konamivrc6/Gewu/README.md

# 格物

> 在一块 8×8 点阵上，渲染几颗**有物理的像素**。

---

## 硬件

| 器件 | 作用 |
|---|---|
| 合宙 CORE-ESP32-C3 | 主控，跑物理引擎 |
| MAX7219 + 8×8 点阵 | 世界本身 |
| MPU6500 | 重力矢量来源 |
| 旋转编码器 EC11 | 连续量输入——重力系数、弹性、阻尼、时间步长 |
| 微动开关 ×2 | 离散量输入——重置、计时、冻结 |
| SN74HCT125 | 3.3V → 5V 电平转换，驱动 MAX7219 |
| 拨动开关 + 2pin 排针 | 5V 供电入口 |
| 电源小板（TP5400 + DW01A） | 18650 → 5V 升压与保护，与主板叠装 |

**`PCB/` 里的 EDA 工程仍标 MPU6050——那只是因为立创EDA 元件库里有这一颗，实际按 MPU6500 采购。**

**电源板上有三处飞线，打样后需手工补接。**

**完整接线见 [`硬件接线.md`](硬件接线.md)。** 该文档包含经官方资料核实的引脚分配、电平转换细节、去耦要求与上电检查步骤，动烙铁前请通读。

---

## 设计要点

**为什么需要 SN74HCT125**：MAX7219 在 5V 供电时输入高电平门限为 3.5V，而 ESP32-C3 输出仅 3.3V，处于「有时能用有时不能用」的危险区间。HCT 系列是 TTL 电平输入，2.0V 即判为高，3.3V 驱动有充足余量，输出 5V 摆幅正好匹配。它只能单向使用，因此**不能**用于传感器的 I2C 总线。

**为什么 X 放在 Y 引脚**：见接线文档「主控引脚分配」一节，其中 GPIO8 与 strapping 脚的取舍有专门说明。

---

## 软件栈

- 平台：Arduino（板型 `AirM2M CORE ESP32C3`）或 ESP-IDF
- 构建：`arduino-cli compile firmware/Hardware_Test`。板型、平台与库版本都钉在 `firmware/Hardware_Test/sketch.yaml` 里，缺什么会自动下载，换机器不必先配板管理器
- flash 模式：DIO（本板型固定，无需设置）
- 显示驱动：MAX7219 三线协议，3 个 GPIO
- 传感器：MPU6500 I2C，地址 `0x68`。九个标定常数（加速度计六个、陀螺三个）与「模组系 → 屏幕系」的轴映射都在固件里，来历见 [`标定.md`](标定.md)
- 物理引擎：自写，1-bit 离散世界，无需浮点库。内核定案为**格子锚定**（格号是状态不变量，不是事后修补），全程 Q16.16 定点。平面内重力、任意转轴的刚体转动（离心 / 科氏 / 欧拉，三轴全进模型）与板面静摩擦（法向压力 `N = sqrt(G² − g∥²)`）都已进来；平放转板时物块会聚到四角，转速低于 `sqrt(μ_p·N/r)` 时被静摩擦钉住不动，绕板面内的轴转时物块被推离该轴。设计推导与验证在 [`物块模式_物理设计.md`](物块模式_物理设计.md)，可运行的定点原型与评测套件在 `sim/particle/`。C++ 移植在 `firmware/common/PhysicsWorld.h`，正式固件 `firmware/Gewu/` 已接编码器增删粒子、MPU6500 实时重力与三轴角速度（200 Hz、±4 g）；角速度经标定与「模组系 → 屏幕系 → 引擎系」映射后每 5 ms 喂给内核，转板子时离心/科氏/欧拉三项都实时生效；`sim/particle/` 仍是逐位基准，三组场景的板上 trace 与 `sim/particle/port_trace.py` 逐行一致。固件现有水 / 红豆 / 钢珠三组材料预设：钢珠是同一内核上的低摩擦高恢复颗粒（μ_p = 0.003、μ = 0.15、e = 0.78、阻尼 0.9999），重力标度与红豆同为 0.0118——密度不进入自由落体，钢珠的「重」只能由低摩擦与高恢复表现。推导与台面实验见 `sim/steel/` 与设计文档 §4.5

---

## 待定

- [x] 物理模型的粒度——答案是两者之外的第三种：位置保持连续，但「占用」是状态的一部分而非事后检查。见 [`物块模式_物理设计.md`](物块模式_物理设计.md)
- [x] 各向异性扫描——镜像残差在 90 个角度上全部为零，见设计文档 §4.1
- [x] 转动的各向同性——`S/+ω` 与转置后的 `T(S)/−ω` 逐位相同，见 §4.2
- [x] 板面静摩擦——启滑阈值逐 LSB 扫过，与 `G·μ/√(1+μ²)` 差 0.7%~3.9%，见 §4.3
- [x] 陀螺实时转动——MPU6500 角速度每 5 ms 进内核，屏幕系 → 引擎系后驱动离心 / 科氏 / 欧拉；`w` 现场调转速增益，见 §4.4
- [x] 内聚力的拓扑加权（平直界面减弱、凸角保持）——8×8 上不成立：零重力液滴周长从 18 涨到 20、边界出现单格凸起，性能 +18%。`k` 不是曲率的好代理，均匀收缩才是液滴成形的机制。已回滚
- [ ] 滞后回线的实测
- [ ] 钢珠模式的块间摩擦与恢复系数上板实测——`u` 扫 0.10 / 0.15 / 0.20，`e` 扫 0.70~0.82；仿真只能验到速度余量与反弹衰减，堆角要在板上看。见设计文档 §4.5
- [ ] 编码器映射到哪个参数最直观
- [ ] 是否需要 WiFi 扩展（OTA 调参？多机同步？）
- [x] PCB 化——主板与电源板的原理图、PCB 均已完成，工程与 Gerber 见 `PCB/`

---

## 工具

`tools/` 下的脚本分两拨。

**工程包解析**——只依赖标准库，**都不传参数即可裸跑**——默认取 `PCB/` 下最新的 `.epro2`，免得工程一改名就集体失效。

| 脚本 | 作用 | 用法 |
|---|---|---|
| `bom.py` | 元器件清单：位号明细、按立创编号聚合的采购表、PCB 手焊清单 | `python tools/bom.py` |
| `netlist.py` | PCB 网表，按位号列出每个焊盘的网络，用来对照 `硬件接线.md` | `python tools/netlist.py` |
| `epro_dump.py` | 工程文件概览：元素类型计数与文档段划分 | `python tools/epro_dump.py` |

`bom.py` 另有两个开关：`--json` 出结构化数据，`-o 文件` 写进文件。**要重定向就用 `-o`**——PowerShell 的 `>` 默认产出 UTF-16，别的工具读不了。

手焊清单的「标签」不是位号，是 layout 阶段为了手焊方便在板面上改成的展示值（`100nF`、`4k7`、`HCT125`），脚本照读原值，并附上它对应的权威位号，方便回头查原理图。

**台面调试与标定**——要 `pyserial`，要板子插在串口上。不指定 `--port` 时按 VID/PID 自动找板上的 CH343（换机器 COM 号变了也不用改脚本）；认不出或有多个候选会列出清单，用 `--port COM7` 覆盖。四支都按 921600 打开。**默认不复位**——只有加 `--reset` 才拉 RTS 让板子重启，因为复位会冲掉亮度、显示模式、屏上已画的内容，而标定过程往往正需要保留这些。

| 脚本 | 作用 | 用法 |
|---|---|---|
| `serial_send.py` | 逐条发串口命令并回显，滤掉 IMU 数据行，`--reset` 会等开机横幅 | `python tools/serial_send.py '?' 'i 8'` |
| `serial_console.py` | 交互式串口控制台：常驻提示符，一行一条命令；本地命令 `:help` / `:reset` / `:port`（别名 `:com`）/ `:filter` / `:log` / `:quit` | `python tools/serial_console.py` |
| `imu_stat.py` | 抓一段 IMU 数据行做静止统计：均值、原始计数、标准差、模长、重力方向 | `python tools/imu_stat.py --sec 12 --label '点阵面朝上'` |
| `accel_calib.py` | 加速度计六面标定：`record` 采一个姿态、`status` 看还缺哪个、`solve` 解常数并自检 | `python tools/accel_calib.py record --pose flat_up` |

原始数据写到 `%TEMP%`，不进仓库。判据、摆法与固件那一路串口命令的清单都在 [`标定.md`](标定.md)。

---

## 文件

| 文件 | 内容 |
|---|---|
| `README.md` | 本文档 |
| `硬件接线.md` | 接线、引脚分配、上电检查 |
| `电源设计.md` | 电源小板的设计规格与选型记录 |
| `标定.md` | 传感器与点阵屏的标定：判据、方法与进度 |
| `物块模式_物理设计.md` | 物理内核的前提、推导、方案评估与验证记录；附录里有被否掉的思路和判别实验设计 |
| `sim/` | 三套原型共用的公共层（只用标准库）：`fixed.py` Q16.16 定点原语（C++ 侧逐条对应）、`spawn.py` 统一摆位、`world2.py` 格子锚定内核（内聚 / 浸润项默认关闭）、`checker.py` 独立不变量检查 |
| `sim/particle/` | 粒子内核原型与评测：`world.py` 基线、`run.py` 终端演示（`--engine v1\|v2`）、`eval.py` 不变量、动能、运算数与板面摩擦阈值评测、`aniso.py` 各向异性扫描、`rot.py` 转动与镜像检验、`port_trace.py` 生成与固件 `v` 命令同格式的逐位对照 trace |
| `sim/water/` | 水模式原型：`water.py` 参数预设、场景、度量与实验（`drop` / `wet` / `tilt` / `sweep` / `jam` / `column` / `show`）；`port_trace.py` 生成与固件 `v water` 同格式的逐位对照 trace，`port_trace_hydro.py` 生成 `v hydro` / `v hydrod` / `v grain` / `v graind` 的压强路径与屈服门逐位对照（竖直与斜向重力各一组，后者开屈服 μ = 0.45；零摩擦零内聚，只留静水压强）。零摩擦、零恢复系数，八邻域内聚 + 键轴阻尼 + 静水压强（重力反方向的水头差变成横向推力，竖柱会塌、液面会平），壁面虚拟格与接触线力（默认关闭） |
| `sim/steel/` | 钢珠模式原型：`steel.py` 参数预设与实验（`drop` / `pile` / `plate` / `bounce` / `tilt` / `show`），同时带一份红豆预设做对照。只改摩擦、恢复、阻尼，不引入球体或多格刚体；`plate` 扫出启滑阈值（钢珠 3 LSB = 0.222°，红豆 40 LSB = 2.965°），`bounce` 扫恢复系数（e = 0.78 首跳回弹 4 格，与 e² × 7 = 4.26 对得上），`tilt` 在 2° 板面上直接看出钢珠流、红豆不动 |
| `PCB/` | 立创EDA 专业版工程（`.epro2`，主板与电源板同在一个工程里）与导出的 Gerber 包 |
| `面板Logo/` | 前面板铭牌 Logo 的源图与导出件，含总览 SVG、铜箔层与丝印层的分层文件 |
| `firmware/` | 板级上电自检草图（Arduino），一次验点阵、I2C 总线、串口与五路输入；另带一路串口命令，可点名点灯、全亮查死点、逐行逐列扫、运行时调亮度。逻辑坐标用数学系 `(x, y)`，原点左下。IMU 读数已按标定修正，`g` 命令进重力模式，把屏幕系的重力方向画成一颗灯 |
| `firmware/Gewu/` | 正式固件：移植后的格子锚定物理内核 + 编码器增删 + MPU6500 实时重力与三轴角速度（200 Hz 采样、±4 g、218 Hz 加速度计 DLPF）。三组材料预设共用同一内核与同一套时间尺度（重力标度 0.0118~0.0120），切换保留现有粒子、只恢复该模式的默认参数，上电不预置任何粒子。默认**水模式**：零摩擦、零恢复、静水压强，外加很小的内聚力和键轴黏性（`a` 4 / `j` 4），重力标度 0.0120、转速增益 200%；`m particles` 切**红豆模式**（μ_p = 0.05、μ = 0.45、恢复 0.50、阻尼 0.9998、重力 0.0118、转速 100%）；`m steel` 切**钢珠模式**（μ_p = 0.003、μ = 0.15、恢复 0.78、阻尼 0.9999、重力 0.0118、转速 100%）。顺时针一格随机添加，逆时针一格删除最新，编码器按下后松开清空全部，容量 64。SW2 短按松开时在 水 ↔ 钢珠 之间循环（红豆预设不给按键入口，只能 `m particles` 进入）；按住满 2 秒时最外圈 28 颗先闪约 120 ms，随后进入计时模式：清空后立刻补一格、之后每 60 秒加一格，长按后的松开不再切换模式；计时模式被编码器转动或编码器按键松开打断，SW2 短按不打断（周期可用 `t` 临时改）。SW3 改为按住冻结：消抖确认的按下沿暂停全部物理推进，松开恢复；冻结期间编码器增删照常、新粒子停在原地，计时任务照常计时。按键动作不再统一在松开沿：SW3 在两个沿动作，SW2 短按在松开沿、长按在按住中触发。串口命令 `n / d / p x y / c / i / f / q / u / e / g / w / t / m / a / j / h / s / k / v`：`a` 调内聚，`j` 调黏性，`h` 调静水压强增益（百分数），`m` 切模式，`f`（百分数）与 `q`（千分之一，钢珠的 0.003 用 `q 3`）调板面摩擦，`u` 调块间摩擦，`e` 调恢复系数（百分数），`g [1-999]` 调重力标度（`m` 切换恢复各模式默认），`w` 调转速增益，`t` 调计时模式周期，`v plain\|friction\|spin\|water\|hydro\|hydrod\|grain\|graind` 生成确定性 trace（前三种对照 `sim/particle/port_trace.py`，`water` 对照 `sim/water/port_trace.py`，其余四种对照 `sim/water/port_trace_hydro.py`，其中 `grain` / `graind` 是带屈服门的颗粒路径）。构建上传：先用 `arduino-cli board list` 确认端口（本板是板载 CH343，换机器 COM 号会变），再 `arduino-cli compile -u -p <端口> -m gewu-firmware firmware/Gewu` |
| `firmware/common/` | `BoardProfile.h`：这台板子**实测出来**的档案——点阵模块型号、编码器每格跳变数、IMU 量程与九个标定常数。与「可调参数」刻意分成两处，见文件开头的分组规则。`fixed_q16.h`：Q16.16 定点原语，逐条对应 `sim/fixed.py`。`PhysicsWorld.h`：格子锚定物理内核的 C++ 逐位移植，header-only，不依赖 Arduino |
| `tools/` | 两组脚本：工程包解析（`bom` / `netlist` / `epro_dump`，只用标准库），台面调试与标定（`serial_send` / `serial_console` / `imu_stat` / `accel_calib`，要 `pyserial`） |
