konamivrc6/Gewu/电源设计.md

# Gewu 电源设计

本文档定义格物的**独立电源小板**：单节 18650 供电、升压至 5V、支持边充边用。

与 `硬件接线.md` 的分工：**格物主板一侧的接线以 `硬件接线.md` 为准，本文档只管电源小板**。两块板之间只有一个 2 针接口 `CN1`。

**本文档的位号与定稿的原理图逐一对齐**，可以直接对着 BOM 和 PCB 找件。两条容易混的地方：电源板的 `H1` 是跳线，格物主板的 `H1` 是输出排针，两块板各自独立编号；网络名本文档仍用概念名（`VBOOST`、`V5V`、`VBAT`、`B−`、`P−`），与 EDA 网名的对应见 §2 的节点表。

**当前版本基于 `TP5400` 单芯片方案**（此前一版是 TP4056 + FP6291 + TLV3011 的离散方案，已被本文档取代）。改版理由见 5.3，被淘汰的候选见 4.7。

---

## 一、目标与约束

| 项 | 内容 |
|---|---|
| 电池 | **1S1P**，单节 18650，容量按 3000mAh 校核（4.2V 放到 3.0V 可用约 2700mAh） |
| 电池保护 | **裸电芯，不自带保护板**，保护电路做在本板上（见 4.3） |
| 输出 | **5V 轨**，供给格物主板的 `H1` 排针。3.3V 由格物板载 LDO 产生，本板不管 |
| 充电 | USB-C 输入 |
| **充电时的负载策略** | **由跳线 `H1` 选择**：断开 = 充电时切断主板供电；闭合 = 边充边用。见 5.8 |
| 切换 | USB 插拔时**允许格物复位或冷启动**，不要求无扰切换（见 5.5） |
| 形态 | 独立小板，**与格物主板叠装**，板载 18650 电池座（`BT1`，占位约 77 × 21 mm），与格物用 **JST XH2.54** 连接 |
| 主要场景 | 手持游玩。**不作为长期插电的桌面设备** |

最后一条是刻意的取舍，它降低了"电池长期停在满充"这一类风险，后文多处结论依赖它。

---

## 二、系统架构

**五条链路，两个汇合点。**

| 链路 | 路径 |
|---|---|
| **输入** | `USB1` 的 VBUS → `F1`/`F2`（PTC）→ `VBUS_CHG` |
| **充电** | `VBUS_CHG` → `U1` 的 `VCC` → `U1` 的 `BAT` → 电芯正极 |
| **放电** | 电芯正极 → `L1` → `U1` 的 `LX` → 整流 → `VBOOST` |
| **整流** | `U1` 的 `LX` → `D2` → `VBOOST`（`VBOOST` 就是 `U1` 的 `VOUT` 脚） |
| **直供** | `VBUS_CHG` → `H1` → `D3` → `V5V`（**`H1` 断开即切断**） |
| **汇合** | `VBOOST` → `Q1`（P-MOS 开关）→ `V5V`；`V5V` → `CN1` |

节点命名：

| 网络名 | EDA 网名 | 含义 |
|---|---|---|
| `VBUS_CHG` | `VBUS_CHG` | PTC 之后的 USB 5V，`D3` 的阳极侧、`U1` 的 `VCC`、`Q1` 的栅极 |
| `VBAT` | `VBAT+` | 电芯正极（保护 IC 之外的 B+），同时是 `U1` 的 `BAT` 脚 |
| `B−` | `VBAT−` | 电芯负极。只连 `BT1`、`U2` 的 `VSS`、`Q2` 的 `S1`、`C10` 的下端 |
| `P−` | `GND` | 板地。`Q2` 的 `S2` 接在这里，**与 `B−` 不是同一个网络** |
| `LX` | `LX` | `U1` 的开关节点，电感与续流二极管之间 |
| **`VBOOST`** | **`BAT5V`** | **升压输出，就是 `U1` 的 `VOUT` 脚**。`D2` 的阴极、`Q1` 的源极、47µF 电解 `C3`、TVS `D1` 都挂在这里 |
| `V5V` | `5VOUT` | 输出轨。`Q1` 的漏极与 `D3` 的阴极在此汇合，47µF 储能 `C9` 也挂在这里，直接送 `CN1` |

**`VBOOST` 和 `V5V` 是两个节点，中间是 `Q1`。** 这个拆分是本文档最新一版的核心改动，理由见 5.6。

`V5V` 由谁供：

| 状态 | `H1` | `V5V` 由谁供 | 电池 | 格物 |
|---|---|---|---|---|
| USB 不在位 | 任意 | `Q1` 导通，5.0V | 放电 | 运行 |
| USB 在位 | **闭合** | `D3`，约 4.65V（`Q1` 关断） | 充电，判停干净 | **继续运行**（边充边用） |
| USB 在位 | **断开** | **无人供电 → `V5V` ≈ 0** | 充电，判停干净 | **断电** |

**四个关键拓扑性质**：

1. **负载与充电器不在同一个节点上。** `U1` 的 `BAT` 脚上只有电池和保护，格物的负载挂在 `V5V`。所以充电器的判停测量天然干净，不需要任何电源多路复用器。
2. **`Q1` 保证"USB 在位时电池不出力"是无条件的。** 不依赖任何电压余量，见 5.6。
3. **`H1` 决定"USB 在位时主板吃不吃电"。** 这是使用者的配置选择，见 5.8。
4. **`D3` 保证"电池供电时升压不会被自己的输出电压顶住"**（否则形成自锁死循环），见 5.6。**注意 `D3` 无论 `H1` 怎么设都不能删。**

---

## 三、负载预算

**两种账，不能混用。**

### 3.1 电流账（选器件用）

| 项 | 平均 | 峰值 |
|---|---|---|
| MAX7219 显示 | 15～75mA | 320mA |
| 3.3V 轨（经格物板载 LDO） | 30mA | ~45mA |
| **5V 轨合计** | **45～105mA** | **0.36A**（本项目无 WiFi） |

含 WiFi 的峰值是 0.7A，格物用不到，只作参考。

**MAX7219 平均电流的来历**：8 位扫描复用，任一时刻只有一行导通。设单段电流 `I_seg`（`R_SET` = 10kΩ、5V 时约 40mA），则平均电流 = `N_lit` × `I_seg` / 8，其中 `N_lit` 是当前点亮的总像素数。64 颗全亮才等于 8 × `I_seg` = 320mA。

**这一栏是估算，不是实测。** 实际值取决于固件每帧画了多少像素。**下一步应该串一颗电流表跑真实固件量一次。**

### 3.2 能量账（算续航用）

升压是功率守恒 + 效率惩罚，输入电流由电压比放大：

```
I_in = (V_out × I_out) / (V_in × η)
```

`TP5400` 手册给的效率是 **90% @ 500mA 输出、88% @ 1000mA**（`VBAT` = 3.8V）。本项目工作点只有 45～105mA，离手册测点较远，**取 η = 0.85 作为偏保守的估计**（这是估算不是手册值）：

| 5V 轨电流 | 输入电流 @3.7V | 输入电流 @3.0V |
|---|---|---|
| 45mA | 72mA | 88mA |
| **75mA（典型）** | **119mA** | **147mA** |
| 105mA | 167mA | 206mA |
| 365mA（峰值） | 580mA | **716mA** |

电感纹波（`L1` = 10µH、f = 400kHz、Vin = 3.0V、D = 0.43）：

```
ΔI_L = (V_in × D) / (L × f) ≈ 0.32A
峰值电感电流 ≈ 0.716 + 0.16 ≈ 0.88A
```

**设计输入峰值取 0.9A。**

续航按 147mA 估，2700mAh 可用容量对应**约 18 小时**。

**顺带两条设计上限**：

- `TP5400` 的最大占空比是 75%，本项目 3.0V 输入时只需约 43%，余量充足
- 它的升压**绝对最大输出是 1.8A/5V**，本项目用不到，也不要按这个数去设计散热

---

## 四、器件选型

**选型顺序：封装是第一道筛子，功能是第二道。**

手工焊接的可用封装白名单：**SOT-23 / SOT-23-3 / SOT-23-6 / SC70 / SOP-8 / ESOP-8 / TSSOP-8 / MSOP-8 / SMA / SMB / 1206 / 1812 / 0805 / 0603 / 2.54mm 排针，以及所有直插**。

不可用：**QFN、DFN、VQFN-HR、WLCSP、BGA**——凡是无可见引脚、靠底部焊盘散热的一律排除。

**`ESOP-8` 是允许的**：本体 4.9 × 3.9 mm、引脚间距 1.27 mm 的鸥翼脚，拖焊轻松；底部散热焊盘虽然不可见，但尺寸大（3.1 × 2.21 mm），可以用过孔从背面灌锡解决，见 7.18。

**无源元件统一用 0805，不用 0603。** 两者都在白名单里，但 0805 比 0603 大一档，镊子夹持和拖焊都明显更好操作，而本板虽然**与格物主板叠装**，叠装高度却是由 `BT1` 里的 18650 决定的——电芯本体直径 18.4 mm，连座子约 21 mm，**凡是低于电芯的元件都不受约束**。这是**反向的木桶效应**：桶高不由最短的那块板定，由最长的那块（电芯）定。所以 0805 多占的那点尺寸换不到任何代价，§7.20 那条"热回路周长压到 15mm 以内"在 0805 下依然轻松满足。

**TVS（`D1`）不受 0805 规则约束。** TVS 的封装体系是 SOD-123 / SOD-323 / SMA / SMB，EIA 阻容尺寸的 TVS 本来就少，**双向型更难找**。本设计实际用的是 **SMB 封装的 `SMBJ6.8CA`**——比 0603 大得多，但它挂在 `VBOOST` 而不是 `LX` 上，封装引线的寄生参数影响很小，手工焊反而更容易。如果将来要缩小，正确的方向是 **SOD-323 或 SOT-23 的双向 TVS**，不是 0805。

### 4.1 选型表

| 位号 | 功能 | 型号 | 封装 | 关键参数 |
|---|---|---|---|---|
| `U1` | **充电 + 升压二合一** | **TP5400**（南京拓微） | **ESOP-8 带散热焊盘** | 线性充电 1000mA 可编程、4.2V ±1%、C/5 判停、2.9V 涓流；升压 5V ±2.5%、VFM、400kHz、Dmax 75%；**内置欠压关断 3.0V 关断 / 3.3V 解锁**；空载 <10µA；**无需按键自动启动** |
| `U2` | 电池保护 | **DW01A**（永裕泰 C2927799） | **SOT-23-6** | 过充 **4.30V / 解除 4.10V**，过放 **2.40V / 解除 3.00V**，放电过流 **0.16V**，短路 **1.3V**。引脚 1 OD / 2 CSI / 3 OC / 4 NC / 5 VDD / 6 VSS |
| `Q2` | 保护 MOS | **8205A**（杰盛微 C2762931） | **SOT-23-6** | 20V / 6A，Rds(on) **22/28mΩ @4.5V、30/38mΩ @2.5V**（典型/最大）。引脚 1 S1 / 2 D（共漏）/ 3 S2 / 4 G2 / 5 NC / 6 G1。**引脚 2 的焊盘铺铜但不接网络**，见 7.25 |
| **`Q1`** | **输出隔离开关** | **CJ3401**（长晶，P-MOS） | **SOT-23-3** | 1=G、2=S、3=D。**源极接 `VBOOST`，漏极接 `V5V`，栅极接 `VBUS_CHG`**，见 5.6 |
| `D3` | USB 直供通路 | **SS34** | SMA | 3A / 40V。阳极接 `H1`，**阴极接 `V5V`** |
| `D2` | 升压整流 | **SS34**（**与 `D3` 同料**） | SMA | 同上。手册推荐 SS32（3A/20V），本项目统一用 SS34 换 40V 耐压余量。阳极接 `LX`，阴极接 `VBOOST` |
| `D1` | `VBOOST` 端 TVS | **`SMBJ6.8CA`**（R+O C19077562），双向 | SMB | VRWM 5.8V，击穿 6.46～7.14V，钳位 10.5V @ 57.1A。手册推荐 5.5～6.8V 的 TVS，本料**两端都满足**：`VRWM` 5.8V 保证 5.0V 稳态不导通，击穿 + `D2` 的 Vf ≈ 7.0～7.7V 保证钳位赶在 `LX` 的 10V 绝限之前。击穿上限比手册典型值高 0.34V，不影响功能，见 5.7。接在 `VBOOST` 与 GND 之间 |
| `L1` | 升压电感 | **`SLS6D38S100MTT`**（顺络 6D38，10µH ±20%） | 7×7mm（本体 6.0×6.0×3.8） | 额定电流 **2A**，DCR **38mΩ max**。手册推荐 3.3～22µH，典型 10µH。−20% 容差对应 8µH，峰值电流约 0.92A，仍远低于额定 |
| `F1`/`F2` | 输入自恢复保险丝 | **1.5A 保持 PTC ×2 并联**（R+O `SMD1206-150-8`） | **1206 ×2** | **Vmax 8V**、Imax 40A、Itrip 3A。**按库存条件定的方案**：库存现成的是 1.5A/1206，单颗扛不住 1A 的工作点，而 1206 的 PTC 上限就在 1.5A 附近，买 2A 要换成 1812 并重新开一次采购。并联后保持电流约 **2.4～2.7A**（不是 3A），热余量比单颗 2A 还宽。**两颗必须同型号、并排、且一起远离 `U1`**，见 4.5 后果一、7.23、7.24 |
| **`H1`** | **充电时负载策略选择** | **2.54mm 2 针排针 + 短路帽** | — | **闭合** = 边充边用；**断开或不装** = 充电时切断主板。见 5.8。可用 2 焊盘焊接跳线或 0805 零欧电阻代替，但改起来要动烙铁 |
| `R4`/`R6` | 充电电流设定 | **2.2kΩ ×2 并联 = 1.1kΩ** | **0805 ×2** | `I_BAT` = 1100 / `R_PROG`(kΩ)，其中 `R_PROG` = `R4`∥`R6` → **1000mA**（手册上限）。**按库存条件定的方案**：库存没有 1.1kΩ，但有 2.2kΩ 一百颗，两颗并联正好是 1.1kΩ（并联比单颗还准）。**两颗都必须是 1%**，见 4.5、7.17。另一笔代价是电池低于约 3.3V 时芯片会热调节降流 |
| `R3` | LED 限流（两颗共用） | 1kΩ | 0805 | 手册典型应用。`LED2`（红，充电中）与 `LED1`（绿，充满）**共用这一颗**——两个开漏非此即彼，约 3mA |
| **`R5`** | **`Q1` 栅极下拉 + `VBUS_CHG` 泄放** | **10kΩ** | 0805 | **一颗电阻干三件事**，见 4.4。开源参考设计用的是 100kΩ，会带来约 0.7 秒的切换空窗，本文档改小 |
| `R8` | DW01A `VDD` 串阻（引脚 5） | 470Ω | 0805 | DW01A 手册强制，**必须 ≥470Ω** |
| `R7` | DW01A `CSI` 串阻（引脚 2，旧称 `VM`） | 2kΩ | 0805 | DW01A 手册要求 1～3kΩ |
| **`R1` / `R2`** | **USB-C CC 下拉** | **5.1kΩ** | 0805 | 分别接 `USB1` 的 `CC1` / `CC2` 到 GND。**漏了就取不到电**，见 6 与 7.12 |
| `C2` | `VCC` 储能与去耦 | 10µF | 0805 | 紧靠 `U1` 的 `VCC` 脚，管充电稳定与输入纹波（**不在开关热回路上**，见 7.20）。**不要再加大**——它同时决定拔线后升压启动的延时，见 4.4 与 5.5 |
| `C1`/`C8` | `VCC` 高频去耦 | 0.1µF | 0805 | 与 `C2` 并联 |
| `C6` / `C7` | `BAT` 去耦 | **22µF ×2，铝电解**（`KM1E220M0407`） | **直插**（φ4×7mm） | 手册要求 `BAT` 端并联两颗 22µF，**不限类型**。实际用 25V 规格，建议 105°C。为什么用铝电解和直插，见 5.7 |
| `C3` | `VBOOST` 主电容 | **47µF / 25V 直插铝电解**（`KS476M025D07`） | 直插（φ5×7mm） | **手册强制要求钽或电解，不能用 MLCC**，见 5.7。最终选了铝电解而不是钽，理由见 5.7 |
| `C4` | `VBOOST` 高频去耦 | 0.1µF | 0805 | 与 `C3` 并联 |
| `C9` | `V5V` 储能 | **47µF / 25V 直插铝电解**（与 `C3` 同料） | 直插（φ5×7mm） | 撑住 `Q1` 关断那一刻的负载电流，见 5.5。**有极性** |
| `C5` | `BAT` 高频去耦 | 0.1µF | 0805 | 与 `C6`/`C7` 并联 |
| `C10` | DW01A 去耦 | 0.1µF | 0805 | ≥0.1µF |
| `LED2` | 充电中指示 | 红色 LED（`GL0805UR01`） | 0805 | 接 `U1` 的 `CHRG`（开漏），经 `R3` 限流 |
| `LED1` | 充满指示 | 绿色 LED（`GL0805UG01`） | 0805 | 接 `U1` 的 `STDBY`（开漏），经 `R3` 限流 |
| `BT1` | 电池座 | **18650 贴片电池座**（MYOUNG `BH-18650-B1BA002`） | SMD | 焊在板上，占位约 77 × 21 mm。**取出电芯即物理断电**，见 4.4。⚠️ 贴片座要承受每次换电芯的插拔力，见 7.21 |
| `CN1` | 输出连接器 | **JST XH2.54** 2P | — | 每触点 3A |
| `USB1` | 充电输入 | **USB-C 16P 母座**（首韩 `TYPE-C 16PIN 2MD(073)`） | SMD 卧贴 | 只用 VBUS/GND/CC1/CC2，**D+/D−/SBU 全部悬空**；**CC1 / CC2 各经 `R1` / `R2` 配 5.1kΩ 下拉** |

### 4.2 元件数统计

| 方案 | IC | 分立半导体与 LED | 无源 | 连接器与开关 | 合计 |
|---|---|---|---|---|---|
| 全集成（不可焊，作废） | 3 | 0 | 12 | 4 | 19 |
| 离散方案（TP4056 + FP6291 + TLV3011） | 5 | 7 | 约 21 | 4 | **约 37** |
| **本方案（TP5400 + `Q1` + `H1`）** | **2** | **7** | **19** | **4** | **32** |

省下的 8 个主要来自 `U1` 内部替掉了 FP6291 升压 IC、TLV3011 迟滞比较器、VBUS 检测管以及 `EN_BOOST` 上拉网络和整个迟滞分压网络共 5 个无源。

**新增的是 4 个，分两类：**

- **功能性的两颗**：`Q1` 把"USB 在位时电池不出力"从"依赖电压余量"变成"无条件成立"（见 5.6）；`H1` 把"充电时主板要不要断电"变成使用者的选择（见 5.8）。这两颗都不可省
- **重复的两颗**：`F1`+`F2` 与 `R4`+`R6` 各由一颗变两颗，是**对着库存定的并联方案**（1.5A/1206 的 PTC 两颗并联当输入保险丝、2.2kΩ 两颗并联当 1.1kΩ 的 `R_PROG`），见 4.5。省掉的是采购，不是元件

所以相对离散方案**净省 5 个**（8 减 4，再加上删掉的电源开关 `SW1`——那一颗两边本来都有，现在本方案没有）。

> **口径说明**：上表的"离散方案 约 37"是按单颗 `R_PROG`、单颗 `F1`、含一颗电源开关计的。本节那两处并联是为了省采购才加的重复件，**纯比架构的话本方案是 30 个**（省下的 8 个全额兑现，再减掉删掉的开关），32 是含库存方案的实际装配数。加 `C9`、`C5`、`C8` 三颗文档早期版本没有的电容后，板上实际装配 **34 颗**。

**代价是失去了可调的欠压门限**（见 5.3）和**电池温度检测**（见 4.6），换来的是整块板不再有任何需要上台调参的模拟模块。

### 4.3 电池保护电路——不可省

裸电芯没有保护板，而 **`TP5400` 的充电管理不包含放电保护**。它只有：

- 充电侧的浮充限压（4.2V ±1%）和热调节（`Tj` 120°C）
- 升压侧自己的欠压关断（3.0V）——但这只管升压，**不管电芯本身**

它**不管放电过流、不管短路**。而且 3.0V 的升压关断点对 18650 来说偏深——18650 放到 3.0V 已经接近深度放电区。没有 `U2` + `Q2`，一次输出端短路就没有任何东西拦得住。

> 顺带一条佐证：英集芯在 `IP5306` 手册里专门列了「Battery protection recommends: **IP3005A**，ESOP8，过充检测 4.28V，过放检测 2.5V，过流检测 7A」。**厂商自己都建议给集成方案外加保护 IC。**

`U2` + `Q2` 的过流门限：

```
Rds(on) 两颗串联 ≈ 22 × 2 = 44mΩ（典型，Vgs = 4.5V）
I_OCP = 0.16V / 0.044Ω ≈ 3.6A
```

**按最坏情况再算一遍**：`Rds(on)` 取手册最大值 28mΩ；电池接近 3.0V 时栅压只有 2.5V 上下，此时取 38mΩ。串联 76mΩ，`I_OCP ≈ 2.1A`。

**2.1～3.6A，都远高于本项目 0.9A 的输入峰值**，不会误触发；又能真正拦住短路。这是一个合适的窗口——下限比文档早期按 FS8205A 的 21.6mΩ 算出的 3.5A 低，但仍然有 **2.3 倍**余量。

DW01A 的外围（手册强制要求，不可省）：

| 位号 | 值 | 作用 | 约束 |
|---|---|---|---|
| `R8` | 470Ω | `VDD` 串阻 | **必须 ≥470Ω** |
| `R7` | 2kΩ | `CSI` 串阻 | 1～3kΩ |
| `C10` | 0.1µF | `VCC` 去耦 | ≥0.1µF；**下端接 `U2` 的 `VSS` 脚（引脚 6），也就是 `B−`，不是板地 `P−`** |

**一个可选的替代**：把 `U2` + `Q2` 换成单颗 **`IP3005A`**（**ESOP-8**，同样手工可焊，MOS 内置）。立创开源工程 `rushairer/tp5400-18650` 用的就是它，BOM 少一行。选哪个主要看手头库存与采购难度，**电气上是同一个东西**——过放点从 DW01A 的 2.4V 变成 `IP3005A` 的 2.5V，差异可以忽略。

> ⚠️ 顺带记一条教训：那个工程的作者在描述里写「`IP3005A` 低于 3V 关断」，被评论区指出**手册实际是 2.5V**。**以手册为准，不要以作者的描述为准。**

### 4.4 两个"位置型"决策

这两条都不是选器件，是选位置，改一下布线就能同时满足多个约束。

> **电源开关 `SW1` 已删除。** 上一版在电感支路里串过一颗 ≥1A 的拨动开关（`VBAT → SW1 → L1 → LX`），那是它唯一合法的位置——`TP5400` 把充电输出和升压输入做在同一个 `BAT` 脚上，开关放在电芯与 `BAT` 之间会连充电一起断掉。现在整颗删掉，支路直连。
>
> - **理由**：`BT1` 是焊在板上的电池座，**把电芯取出来就是物理断电**；日常开关机落在**主板那颗 `SW1`**（`SS-12D10L5`，串在格物 5V 轨上）。电源板上再放一颗，等于把一个动作拆到两个地方。
> - **代价**：电源板不再有低功耗关机态。只要电芯放在 `BT1` 里，升压就一直在跑、`V5V` 恒为 5.0V；主板开关断开只是摘掉负载，静态电流从原来约 40µA 变成**升压空载电流**。这个数手册没给、也没实测，是删掉这颗开关唯一没有兜底的代价，见 9.2。
> - **成本下降**：`SW1` 原本串在 7.20 的热回路里，删掉之后那条回路少一个远程元件，15mm 的约束更容易满足。
> - **一条不成立的担心**：非同步升压有一条「电芯 → `L1` → `LX` → `D2` → `VBOOST`」的无源直通路径，但它只在**升压停着**的时候才有意义。删掉开关后只要有电池升压就启动，`VBOOST` 被芯片稳压在 5.0V，直通路径被盖过去。
> - **装配顺序**：电芯落进 `BT1` 的瞬间升压就启动，`V5V` 立刻带电。先接好 `CN1` 再放电池，见 7.15。
>
> 参考设计 `rushairer/tp5400-18650` 本来就没有电源开关，这是回到它的做法。

#### ① `R5` 的位置：一颗电阻干三件事

`R5`（10kΩ）接在 `VBUS_CHG` 与 GND 之间，同时服务三个目标：

| 作用 | 说明 |
|---|---|
| **`Q1` 栅极下拉** | USB 拔掉后把栅极拉到 0V，`Q1` 才导得通。**没有它栅极会浮空，输出永远起不来** |
| **`VBUS_CHG` 泄放** | 让 `U1` 的 `VCC` 跌破 3.8V，升压才会重启。没有它 `VCC` 只能靠芯片 µA 级漏电放电，要十几秒 |
| 顺带放掉 `C2` | 同上 |

**取值是 5.5 与 5.8 两节联立的解。**

#### ② `D3`、`D2`、`D1` 三颗二极管各有各的方向

名字相近，接错方向都会造成难查的故障：

| 器件 | 阳极接 | 阴极接 | 接反的后果 |
|---|---|---|---|
| `D3` | `H1` | `V5V` | 完全不充电，见 7.6 |
| `D2` | `LX` | `VBOOST` | 升压建立不起来，见 7.7 |
| `D1` | — | — | 双向 TVS 无方向，但**不能用成单向型**，见 7.8 |

### 4.5 充电电流设定（`R4`/`R6`）——**与 `H1` 联动**

`TP5400` 的充电电流公式：

```
I_BAT = 1100 / R_PROG(kΩ)    （mA）        R_PROG = R4 ∥ R6
```

手册给的表：

| `R_PROG` | 10k | 5k | 2k | 2.2k | 1.5k | **1.1k** |
|---|---|---|---|---|---|---|
| `I_BAT` | 130mA | 245mA | 560mA | 500mA | 740mA | **1000mA** |

**本设计取 1.1kΩ，也就是手册的上限 1000mA。** 理由是 500mA 对 3000mAh 电芯只有 0.17C，充满要 6.5～7.5 小时；1A 是 0.33C（仍是 18650 的标准 0.5C 以内），充满缩到 **3.5～4 小时**，近乎翻倍。**这个改动带来两个必须一起认账的后果，见本节末尾。**

#### `R4`/`R6` 怎么取值：两颗 2.2kΩ 并联（按库存定）

**本设计不买 1.1kΩ，而是用两颗库存的 2.2kΩ 0805 并联得到。** 库存里没有 1.1kΩ 这个阻值，但有 2.2kΩ 一百颗。

```
R = (2.2k × 2.2k) / (2.2k + 2.2k) = 4.84k / 4.4k = 1.1kΩ
```

**这是精确值，不是近似**——两条同阻值支路并联就是一半。三条判据都对得上：

| 担心 | 实际情况 |
|---|---|
| **精度会变差？** | 不会。**同阻值电阻并联，相对误差不放大。** 最坏情况是两颗偏到同一极端（都 +1%），并联后仍是 +1%；实际上一颗偏正、一颗偏负时误差还会互相抵消一部分。**并联出来只会比单颗更准，不会更差** |
| **功率够不够？** | 远远够。`PROG` 脚电压只有 1V 上下，流过 `R4`/`R6` 的电流约 0.9mA，整组才耗 **0.9mW**，对半分到每颗 **0.45mW**——0805 额定 125mW，用了不到 0.4% |
| **代价是什么？** | 多占一个 0805 焊盘。板子还没画，零成本 |

**但有一条不能打折：两颗都必须是 1%。** 并联合格的前提是它们各自合格——**两颗 5% 并联出来还是 5%**，充电电流会在 950～1050mA 之间飘（见 7.17）。丝印上 `2201` 是 1%、`222` 是 5%；有些 0805 批次根本不印字，那就只能看采购时的包装标签。

**充电时 USB 端口要供多少电流，取决于 `H1`：**

| `H1` | 充电时负载电流 | USB 总电流 @`R4`/`R6`=1.1k | 说明 |
|---|---|---|---|
| 断开（充电时切断主板） | **0** | **1000mA** | **必须配真正的 USB 充电头** |
| 闭合（边充边用） | 约 150mA | **1150mA** | 同上，且余量更紧 |

> ⚠️ **500mA 时代那条"任何 USB 口都扛得住"的结论，随 `R4`/`R6` 改成 1.1k 一起作废了。** 见 5.8 那张表的同类修正。

`TP5400` **没有输入电流自适应**（那是 `IP5306` 的功能）。它只有 `VCC` 欠压闭锁：`VCC` 掉到接近电池电压时直接停充，**是硬切换不是柔性降流**。所以插进一个只有 500mA 的电脑 USB 口时，它不会降流，而是走"拉塌 `VCC` → 停充 → `VCC` 回弹 → 复充"的振荡：症状是 `LED2` 忽明忽暗、充电极慢，**可能比老老实实用 500mA 还差**。

### ⚠️ 后果一：`F1`/`F2` 要改成两颗并联（按库存定）

`F1`/`F2` 串在 `USB1` 的 VBUS 到 `VBUS_CHG` 之间，**充电电流和负载电流都要从它们身上过**。它们原本是按 500mA 选的，`R4`/`R6` 改到 1A 之后就不够了：

下表是 60°C 下的**占用率**（实际电流 ÷ 降额后的保持电流），**超过 100% 就会跳闸**。降额比例按 50%～70% 的区间取（不同厂家的曲线有差异）：

| `F1`/`F2` 方案 | 25°C 保持 | 60°C 降额后 | `H1` 断开（1.0A） | `H1` 闭合（1.15A） |
|---|---|---|---|---|
| 1.5A 单颗（原选型） | 1.5A | 0.75～1.05A | ❌ 不够 | ❌ 不够 |
| 2A 单颗（1812） | 2.0A | 1.0～1.4A | ⚠️ 勉强 | ⚠️ 勉强 |
| **1.5A 两颗并联（本设计采用）** | **2.4～2.7A** | **1.2～1.9A** | ✅ | ✅ |

PTC 的保持电流随温度大幅衰减，**1.0A 的静态工作点直接落进单颗 1.5A 规格的降额曲线里**。而这颗 PTC 和 `U1` 在同一块小板上，`U1` 线性充电时要往板上倒 1～2W，**PTC 感受到的温度高于室温**。

**本设计采用两颗 1.5A/1206 并联，这是对着库存定的。** 库存现成就是 1.5A/1206（10 颗），单颗扛不住 1A 的工作点；而 1206 的 PTC 上限就在 1.5A 附近，要去买 2A 就得换成 1812，等于为这一颗料重开一次采购。**用库存件并联，采购省掉，热余量反而比 2A 单颗更宽。**

并联不是想当然的做法，Eaton 的 PTC 应用指南（Technical Data 11055）里专门有一节讲它，三条要点：

- **阻值减半，但保持电流不翻倍。** 原文："the hold/trip current does not double. A general rule of thumb is that this hold and trip current increase is **1.6 to 1.8 ×** I_HOLD of a single PTC resettable fuse"。所以两颗 1.5A 得到的是 **2.4～2.7A**，不是 3A
- **`I_MAX` 不增加**，仍等于单颗。单颗 1206 的 `I_MAX` 在 50A 量级，USB 源给不到这个数，本条对本设计无影响
- **必须同型号，且必须处在相近的热环境里**，否则会产生 nuisance trip

**第三条落到布局上是硬要求**：`F1` 与 `F2` 并排放、朝向一致，而且**两颗都要尽量远离 `U1`**。如果一颗挨着发 1～2W 热的充电芯片、另一颗在板子另一头，两者温度对不上，电流分享会失衡——这正是 Eaton 警告的那种 nuisance trip。

**代价要认**：`1.6～1.8` 是厂商写的 "general rule of thumb"，**不是规格值**；跳闸时间曲线也只对单颗给出，并联组合没有。也就是说这颗安全器件工作在经验值上，出了事没有手册数字可以对照。换来的是一笔省掉的采购和更宽的热余量——在本项目（室内手持、由 USB 充电头供电）的场景下可以接受。

> 顺带记一条：`F1`/`F2` 的价值随工作电流上升而变薄。它的作用是在 USB 源之外兜底（非限流源、车充、实验电源），而 USB 充电头本身自带限流。工作电流抬到 1A 后，`F1`/`F2` 的合力保持电流做到 2.4A、跳闸点更高——**已经高于多数 USB 源能提供的电流上限**，对限流源来说它基本是装饰。真要简化，这条是可以讨论整条删掉的；留着则按两颗并联做。**不要既留着它、又让它工作在降额边缘**——那是唯一真正糟糕的组合。

### ⚠️ 后果二：底部一段充电会热调节降流

`TP5400` 的充电通路是**线性**的（手册：`VCC` 与 `BAT` 之间的功率管 `Rds(on)` = 450mΩ），功耗 `= (VCC − VBAT) × I_BAT`。电流翻倍，这一项也翻倍：

| 电池电压 | I = 500mA（旧） | I = 1000mA（新） | 结温 @θJA 55°C/W、25°C 环境 |
|---|---|---|---|
| 3.0V | 1.00W | **2.00W** | 135°C → **热调节** |
| 3.3V | 0.85W | 1.70W | 118.5°C ✅（刚好压线） |
| 3.7V | 0.65W | 1.30W | 96.5°C ✅ |
| 4.2V | 0.40W | 0.80W | 69°C ✅ |

**热调节点在 120°C，对应电池约 3.3V。** 也就是说：

- **电池高于约 3.3V 时真跑 1A**
- **低于 3.3V 时芯片自己把电流收下来**，结温稳定在 120°C 附近，而不是继续往上冲

**这不是故障，是手册设计的保护行为**，而且恰好落在最不重要的那一段——3000mAh 电芯的 2.9V～3.3V 只占 5% 上下容量，多花的时间可以忽略。**但它意味着"1A"是名义值而非全程值**，别拿它去对账充电时间。

深放电不必担心：低于 2.9V 进涓流，电流降到程序值的 **1/5**（`R4`/`R6` = 1.1kΩ 时约 200mA），此时 (5.0 − 2.4) × 0.2 = 0.52W，**离热调节点远得很**。

> ⚠️ **更正**：本文档早期版本此处写的是「约 1/10（约 100mA）」，**那是 `TP4056` 的值**，从上一版方案抄过来时没有改。`TP5400` 手册中英文两版的原文都是涓流电流约为设定值的 **1/5**（`ITRIKL` 典型值 200mA @ `RPROG` = 1.5K）。改成 1/5 之后功耗从 0.26W 变为 0.52W，**离热调节点仍然远得很，结论不变**。这条也是一个提醒：换芯片时要顺着旧芯片的每一个参数回头重算一遍，哪怕它藏在别的小节里。

**代价是 `θJA` 从"备注"升级成"设计参数"。** 上面那张表的 55°C/W 前提是"ESOP-8 散热焊盘焊好、铜箔足够"。板子铺铜不足、或焊盘没焊上时 `θJA` 会到 70～80°C/W，热调节会**更早介入、覆盖更宽的电压段**。所以 7.16 和 7.18 这两条在 1A 下从"建议"变成**硬要求**，`U1` 周围的顶层铺铜也该按能铺多大铺多大。

**验收标准也变了**：见第八节第 20 步，1A 下的"正常"比 500mA 下烫得多，别拿旧数字当判据。

### 4.6 ⚠️ 失去的电池温度保护

`TP5400` **没有任何电池温度检测引脚**。对比表：

| | TP4056（上一版） | TP5400（本版） |
|---|---|---|
| 电池温度输入 | `TEMP` 脚，配 NTC 分压 | **无** |
| 低温禁充（<0°C） | 可做 | **做不了** |
| 内部过温保护 | 有（`Tj` 145°C） | 有（`Tj` 145°C，热调节 120°C） |

**这是一个真实的退步，必须明说。** 0°C 以下给锂离子充电会在负极析出金属锂，不可逆，且是后续热失控的种子。渭南冬天室外可以到零下，虽然本项目主要场景是室内手持，但风险存在。

**可选的外部补齐方案（待定，见 9.3）**：`TP5400` 的 `PROG` 脚不只是电流设定，还是**关断脚**——手册写明「Shutdown Mode: `RPROG` Not Connected」。所以可以用一支 NTC 网络在超出温区时**断开 `PROG`**，等价于关掉充电器。

代价是要么用一颗比较器（把刚省下的元件又加回来），要么用三极管 `Vbe` 做粗略阈值（精度差，且阈值本身随温度漂移——用它测温度误差会叠加）。**两条路都不优雅。**

**倾向：先不做，接受这个退步，把 NTC 列为后续可加的模块。**

### 4.7 为什么淘汰了其他候选

| 型号 | 原定用途 | 封装 | 结论 |
|---|---|---|---|
| TP4056 | 充电 | SOP-8 带散热焊盘 | **可用，但功能被 `TP5400` 覆盖**，拆开会多出 8 个元件 |
| FP6291 | 升压 | SOT-23-6L | **可用，同上被覆盖**。另外它不是低功耗件，见 9.2 |
| TLV3011 | 欠压闭锁比较器 | SOT-23-6（DBV） | **被 `TP5400` 内置的 3.0V/3.3V 关断取代**，代价是门限不可调 |
| **IP5306** | 充电宝 SoC | ESOP8 | **封装可焊，但有三颗雷**，见 5.4 |
| TP4100 / TP4102 | 充电 + 保护 + 反接一体 | DFN3×3-8 / DFN2×2-8 | 无可见引脚，排除 |
| TPS2121 | 电源多路复用 | **VQFN-HR-12**（2.5×2mm） | 无可见引脚，排除 |
| SGM66057A | 同步升压（3.45A 开关、24µA Iq、固定 5V 输出） | **WLCSP-1.26×1.21-9B**（0.4mm 球间距） | 比 QFN 更难，排除 |

**一个结构性事实**：带电源路径管理的充电 IC **几乎全是 QFN**。原因是它要让充电电流通过芯片内部或紧贴芯片的功率管，热量集中在底部，厂商为了散热必须用带焊盘的封装。**"手工可焊"和"集成电源路径"这两个约束天然打架**，这不是运气问题。

**`TP5400` 为什么能绕开这条规律**：它**没有电源路径管理**——它是"充电"和"升压"两套独立逻辑共用一个封装，靠 `VCC` 电压决定谁工作。真正需要"路径管理"的那个场景（充电时把负载从电池上切走）在这里是由**拓扑 + 一颗 `Q1`** 解决的，不是由芯片解决的，见 5.6。

---

## 五、关键设计决策

**这一节是本文档的核心。** 每条决策都记下理由，改动前先读。

### 5.1 保留格物板载 LDO，不做二级 3.3V 转换

5V → 3.3V 经线性稳压，效率 66%，损失 51mW（3.3V × 30mA 输出，从 5V 取 150mW）。

想省这 51mW 需要加一颗 3.3V 升降压转换器（1S 供电时 3.7V 输入出 3.3V，电池掉到 3.0V 时 LDO 做不到，所以必须升降压）。这类器件在 30mA 轻载下效率约 85%，净省约 34mW，**约为电池侧总功耗的 10%**。

**不值得。** 而且 LDO 在中高频的 PSRR 有 40～60dB，把升压输出的开关纹波滤得很干净，3.3V 轨反而更安静。

### 5.2 负载必须挂在 `V5V`，不能挂在 `BAT` 节点

**这是整个设计的地基，不是可选优化。**

如果把负载和充电器并联在同一个节点（这是最直觉、也是绝大多数开源充电宝板子的接法），充电器的判停判据就被污染了。判据本身是「我的输出电流降到设定值的 1/5」（`TP5400` 是 C/5；`TP4056` 是 C/10），而负载电流混在里面：

- 格物的负载折算到电池节点是 70～160mA
- `TP5400` 的 C/5 门限（`R4`/`R6` = 1.1kΩ、1000mA 时）是 **200mA**

**负载高于门限时判停永不触发，低于门限时会在 4.1V 与 4.2V 之间无限微循环。**

**关键认识：问题不是"测不到终点"，是"测到了也没用"。** 负载焊死在电池节点上，关掉充电器只会让电池转为服务负载，电压跌落又会重启充电。只有物理切换能解决。

**但"物理切换"不等于"必须用多路复用器"。** 把负载整个搬到 `V5V` 节点、让 `U1` 的 `BAT` 脚上只剩电池和保护，KCL 上的干扰项就消失了。

### 5.3 为什么选 `TP5400`

一句话：**它把上一版最难的三个模块做进了芯片内部。**

| 上一版要自己做的 | `TP5400` 的处理 | 判定 |
|---|---|---|
| VBUS 检测 + 停升压 | 内置：`VCC` > 3.8V 时升压自动停 | ✅ 替代 |
| 升压 IC（`U4` FP6291 + 电感 + 续流管） | 内置 400kHz VFM 升压，只需外接电感与二极管 | ✅ 替代 |
| 欠压闭锁迟滞比较器（`U5` + 5 个无源） | 内置 3.0V 关断 / 3.3V 解锁，滞回 300mV | ⚠️ **替代，但门限不可调** |
| 充电器（`U1` TP4056 + `R_PROG`） | 内置线性充电，`R4`/`R6` 可编程 | ✅ 替代 |
| 按键开关机 | **不需要**，手册明写 "No External Button is Required for Start" | ✅ 省掉 |

**它是怎么做到"插 USB 就停升压"的**——手册原文：

> "When the `VCC` pin is not connected to the power supply and the Li-Ion battery voltage is in the range of 3V-4.2V, **the boost circuit starts automatically** and the 5V constant voltage source is continuously output. When the `BAT` voltage is 3V-4.2V and the input power supply `Vcc` is less than 3.8V, or `Vcc` < `Vbat`+50mV and the `PROG` pin is left floating, the boost operation will also work."

**判据是 `VCC` 电压，不是某个使能脚。** 这一条同时带来一个好处和一个麻烦：

- 好处：真正的"自动"，不需要任何外部逻辑
- 麻烦：拔掉 USB 后，`VCC` 节点上的电容要靠自己放电跌破 3.8V，升压才会启动。**所以 `R5` 不可省**，见 4.4 与 5.5

**代价清单（要认账）：**

| 失去的 | 说明 |
|---|---|
| **可调欠压门限** | 固定在 3.0V / 3.3V。上一版是 3.25V / 3.63V。3.0V 对 18650 偏深——但本项目插电时电池不放电，循环次数本来就少，**可以接受** |
| **电池温度检测** | 见 4.6 |
| **输入电流自适应** | 见 4.5 |
| **充电终止精度** | C/5（1000mA 时是 200mA）比 TP4056 的 C/10 粗，电池大约充到 90% 就判满。**对循环寿命反而是好事**。注意门限随 `R4`/`R6` 变：改用 1.1kΩ 后判停点从 100mA 升到 200mA，**终点会再早一点、少充约 2～4% 容量**（3000mAh 上是 60～120mAh，续航约少半小时）——和充电时间近乎减半相比，这个代价可以接受 |
| **`VBOOST` 不用 MLCC** | 手册强制钽或电解，见 5.7 |

### 5.4 为什么不用 `IP5306`

它是这个品类里最流行的芯片（2.4A 升压 / 2.1A 充电 / 单电感 / 4 颗 LED 电量 / 内置路径管理），封装同样是 ESOP-8 手工可焊，价格更低。**但它在"永远在线的小电流负载"这个场景下有三颗雷**，全部来自手册：

| 参数 | 手册值 | 对本项目的意义 |
|---|---|---|
| `TloadD` 负载移除检测 | 负载电流持续 **< 45mA** 达 **32s** → 关输出 | ⚠️ 格物空闲时（点阵全灭 + WiFi 关）完全可能掉到 45mA 以下，输出一关就是**重启死循环** |
| `ICHARG` 充电电流 | **1.8 ～ 2.1A，不可编程** | 接电脑 USB 口全靠"自适应"，不确定 |
| `TEND` 充电安全定时器 | **20 / 24 / 27 小时** | 长期插电会到点强制终止充电 |

还有三条手册之外的实证：

- 有开源作者在原话里写着「更改成用物理开关控制（**从物理层面解决不同版本的芯片导致的各种问题**）」——**`IP5306` 有版本漂移**
- 有用户实测报告「用一段时间就会烧毁芯片，最终导致电池损坏」，另有一例是 10W 负载把主控**烧红穿洞**
- 有开源工程专门换了芯片，标题直接写着「**完美解决了 IP5306/FM5324GA 的低电流下的自动休眠**」

**结论：`IP5306` 是给充电宝设计的，它为"手机插上就充、拔了就走"优化，而格物是永远在线的小电流负载。** 场景不同，不适合。

### 5.5 时序：USB 插拔时到底发生什么

**这一段是整块板最需要实测的地方。**

#### `VBOOST` 的启动延时（两种 `H1` 配置相同）

拔掉 USB 后，`U1` 要等 `VCC` 跌破 3.8V 才启动升压：

```
t=0    USB 拔出，VBUS_CHG 开始经 R5(10kΩ) 与 C2(10µF) 放电
t≈23ms VBUS_CHG 跌破约 4.1V → Q1 的 Vgs 变负 → Q1 导通
t≈44ms VBUS_CHG 跌破 3.8V → U1 的升压自动启动
```

τ = `R5` × `C2` = 10kΩ × 10µF = **100ms**：

| 事件 | 阈值 | 时间 |
|---|---|---|
| `Q1` 导通 | `VBUS_CHG` ≈ 4.1V | **23ms** |
| 升压启动 | `VBUS_CHG` ≈ 3.8V | **44ms** |

**参考设计用的是 100kΩ 配 20µF**（τ = 2s），同样两个事件分别在 **0.4s 和 0.7s**。这解释了为什么别的开源工程评论区里有人实测出「**大约 0.5 秒的断电现象**」——那个数字不是物理极限，**是 `R5` 取值不当**。

#### `H1` 闭合（边充边用）：拔线时是"复位"

`V5V` 在插电时由 `D3` 供到 4.65V，拔线后无人供电，只能靠自身电容撑：

```
t_hold = C × ΔV / I = 47µF × 0.6V / 0.15A ≈ 190µs
```

**比 44ms 小两个数量级，所以格物一定复位。** 要撑过 44ms 需要 `C = 0.15A × 0.044s / 0.6V ≈ 11000µF`——**不现实**。

#### `H1` 断开（充电时切断主板）：拔线时是"冷启动"

`V5V` 在插电时本来就是 0，格物是关着的。拔线 → 44ms → 升压起来 → **格物从上电开始跑**。

**这在体验上比"复位"好**：是一次干净的开机，而不是运行中被硬生生打断。

**但插入方向要留意**：运行中插上 USB，`VCC` 立刻升到 5V → 升压停 → `Q1` 栅极被拉高 → `Q1` 关断 → **`V5V` 掉，格物当场硬断电**。这个掉电由格物自己的输入电容决定（几十 µF 配 100mA，约几毫秒），**非常陡**。如果 ESP32 正好在写 NVS / SPIFFS，有小概率损坏文件系统。要完全避免，应当在插入前先拨断主板那颗 `SW1`。

#### `R5` 的取舍

| `R5` | `VBUS_CHG` 静态电流 | 升压启动延时 | 评价 |
|---|---|---|---|
| 100kΩ | 50µA | **约 0.7s** | 参考设计的取值，太长 |
| 22kΩ | 227µA | 约 150ms | 折中 |
| **10kΩ** | **约 500µA** | **约 44ms** | **本文档取值** |
| 4.7kΩ | 1.06mA | 约 21ms | 再快也没意义 |

再往下调没有收益——**44ms 已经远小于人眼能感知的"开不了机"**，而静态电流是实打实地从 USB 口抽的。

#### 升压关断的收益

| | 升压常开 | 本方案 |
|---|---|---|
| USB 在位时的电池电流 | 升压空载电流持续消耗 | **≈ 0**（`VCC` > 3.8V，升压停；`Q1` 断开输出） |

### 5.6 ⚠️ `Q1` 为什么必需，以及 `VBOOST` / `V5V` 为什么必须分开

**这一节是本文档最新一版的核心改动，也是整个设计里最容易想错的地方。**

#### 先说一个"看起来能省掉 `Q1`"的方案

最直觉的接法是：**`VBOOST` 和 `V5V` 直连成一个节点**，靠 `D3` 和 `D2` 的方向性来隔离。理由听起来很硬：

```
USB 在位时： V5V = VBUS − Vf(D3) ≈ 5.0 − 0.35 = 4.65V
             LX  = VBAT（经 L1 直流耦合）≤ 4.2V
             D2 阴极 = V5V = 4.65V，阳极 = LX = 4.2V
           → 反偏 0.45V，D2 阻断，电池不受倒灌 ✅
```

**问题出在这个 0.45V 的余量不是恒成立的。**

| 情形 | `VBUS_CHG` | `V5V` | 满电电池 | `D2` 状态 |
|---|---|---|---|---|
| 好线 + 好头 | 5.0V | 4.65V | 4.2V | 反偏 0.45V ✅ |
| 长线 / 弱头 | 4.6V | 4.25V | 4.2V | 反偏 **0.05V** ⚠️ |
| 差一点 | 4.5V | 4.15V | 4.2V | **正偏 → 电池倒灌** ❌ |

**倒灌的后果有两条，第二条更麻烦**：

1. 电池在"充电中"同时向负载放电，白白损耗
2. **这条不受控的电流会混进充电器的判停测量**，把 5.2 节好不容易理干净的 KCL 又污染回去——电池会在 4.1V 与 4.2V 之间微循环，永远判不满

#### `Q1` 怎么解决

在 `VBOOST` 和 `V5V` 之间串一颗 **P-MOS（`Q1`，CJ3401）**，**栅极直接接 `VBUS_CHG`**：

| | `VBUS_CHG`（栅极） | `VBOOST`（源极） | `Vgs` | `Q1` |
|---|---|---|---|---|
| USB 在位 | 5.0V | ≈ 3.95V | **+1.05V** | **关断** |
| USB 不在位 | 0V（`R5` 拉低） | 5.0V（升压稳压点） | **−5.0V** | **导通** |

（`Vgs(th)` 典型 −0.9V，`Vgs` 只要不显著为负就是关断。）

**关断之后，电池到负载的通路彻底断掉，不依赖任何电压余量。** 这才是"USB 在位时电池不出力"的无条件保证。

#### 体二极管的方向是故意的

P-MOS 的体二极管是「**漏极 → 源极**」。所以要 **源极接 `VBOOST`、漏极接 `V5V`**（`CJ3401` 的 SOT-23 引脚：1=G、2=S、3=D）：

```
体二极管方向： V5V → VBOOST     ← 和电池供电方向相反
```

| 路径 | 方向 | 结果 |
|---|---|---|
| 电池 → 负载（`VBAT` → `L1` → `D2` → `VBOOST` → `V5V`） | 逆着体二极管 | ✅ **沟道关断 + 体二极管反向，双向阻断** |
| `V5V`（USB 供）→ `VBOOST` | 顺着体二极管 | 导通，`VBOOST` 被抬到约 3.95V。**无害**——那本来就是 USB 的电，不是电池的 |

**如果把 `Q1` 的源漏接反**（源极接 `V5V`、漏极接 `VBOOST`），体二极管就变成 `VBOOST → V5V`，**正好给电池供电打开了一条路**，`Q1` 完全失效。**这是本文档最隐蔽的一个坑**，见 7.2。

#### 这条设计是抄来的，注明出处

接法取自立创开源工程 `rushairer/tp5400-18650`（作者"阿笨"，已在 AbenFan Pro 项目投产，评论区有人下单 100 套移植）。他用的是同一颗 `TP5400`、同一个思路：`BAT5V`（相当于本文档的 `VBOOST`）与 `5VOUT` 之间一颗 `CJ3401`，栅极接 `USB5V`，配一颗 `100kΩ` 下拉。

作者在回复里解释得很准确：

> "TP5400 因为 5V 比 USB 过肖特基后还高，不用担心倒灌问题，而是**避免 USB 供电时依然跑电**。所以方向是反过来的。"

本文档只改了他的 `R5` 取值（100kΩ → 10kΩ），理由见 5.5。

#### `VBOOST` 与 `V5V` 分开之后，各挂什么

| 节点 | 挂什么 | 依据 |
|---|---|---|
| **`VBOOST`** | `U1` 的 `VOUT` 脚、`D2` 阴极、`Q1` 源极、**47µF 电解 `C3`**、`0.1µF` 的 `C4`、**TVS `D1`** | 手册典型应用：47µF 与 TVS 都在 `VOUT` 端 |
| **`V5V`** | `Q1` 漏极、`D3` 阴极、**47µF 电解 `C9`**、`CN1` | 输出节点 |

**⚠️ 千万不要在 `VBOOST` 与 `V5V` 之间再串一颗二极管当"保护"。**

```
USB 在位 → 升压关断 → 若 VBOOST 被二极管与 V5V 隔开，它会掉到 0V
         → D2 阳极 = LX = VBAT ≈ 4.2V，阴极 = VBOOST = 0V
         → D2 正偏，电池经 L1 → D2 直接灌进 VBOOST 的电容和负载 ⚠️
```

**凭空造出一条不受控的电池放电通路。** 加"保护"之前，把所有方向的电流路径都走一遍。

#### ⚠️⚠️ 一个必须认账的退步：`V5V` 现在是真正的 5.0V

**电池供电时，`V5V` = 5.0V，不是 4.65V。**

`D2` 的压降落在 `VBOOST` 之前，而 `VBOOST` 被 `TP5400` 稳压到 5.0V；`Q1` 是 MOS 不是二极管，导通压降只有几十毫伏。所以负载拿到的是实打实的 5.0V。

**后果**：格物主板上那个**烧录用的 USB-C 口**，它的 VBUS 直接挂在 5V 轨上。如果在那里插一台电脑，电脑的 5.0V 与本板的 5.0V **面对面，没有电位差、也就没有屏障**，存在向电脑 USB 口倒灌的风险。

早期离散方案里靠 `D2` 的 0.35V 压降把 `V5V` 压到 4.65V，从而天然避免这件事；**换成 `Q1` 之后这个附带保护没有了**。代价是值得的（`Q1` 换来的隔离是无条件的），但规则必须守住：

> **两个 USB 口不能同时插。** 这不是"建议"，是硬规则。要烧录就先拔掉充电线，反之亦然。

（顺带一提：参考设计 `rushairer/tp5400-18650` 有同样的性质，它的作者在描述里也没提这一条。）

### 5.7 `VBOOST` 的电容必须有 ESR——不能用 MLCC

`TP5400` 手册注意事项第 2 条原文：

> "the capacitance value at the `VOUT` end should not be less than 47μF (too small capacitance value will cause the chip to work unstable, and it is **strongly required to use tantalum capacitors or electrolytic capacitors** at the `VOUT` end), and connect a **5.5V~6.8V TVS diode** to make it have better frequency characteristics."

**"strongly required"——这是强制的，不是建议。**

原因是 VFM（变频）模式的环路补偿依赖输出电容的 ESR，MLCC 的 ESR 太低（毫欧级），会破坏环路稳定性，表现为输出振荡或纹波异常。

**两条强制的后果**：

- **`C3` = 47µF / 25V 直插铝电解**（`KS476M025D07`，φ5×7mm）。耐压取 25V 而不止 16V，是因为手册同一段还写着「电容的耐压至少是设计输出电压的三倍」，5V × 3 = 15V；25V 是 47µF 直插最顺手的档位
- **`D1` = SMB 双向 TVS（`SMBJ6.8CA`）**，击穿 6.46～7.14V，接在 `VBOOST` 与 GND 之间。手册写的是 "5.5V~6.8V TVS"，那两个数是按意图定的、不是绝限：**下限**管"5.0V 稳态不导通"（本料 `VRWM` 5.8V，满足）；**上限**管"钳位赶在 `VOUT`/`LX` 的 10V 绝限之前"（本料击穿 + `D2` 的 Vf ≈ 7.0～7.7V，满足）。击穿上限 7.14V 比手册典型值高 0.34V，**不影响功能**。真正要避免的是 8V 以上的型号——那样它永远赶在绝限之后动作，等于没装。另外，钳位电压 10.5V 那个数是在 57.1A 浪涌下标出来的，本项目的振铃电流只有百 mA 级，实际钳位点落在击穿电压附近

**布局上的三个后果**：

1. 直插电解比 0805 大得多（φ5×7mm），还要留出卧倒或立起的高度，占板面积要留够
2. **有极性**，丝印上必须画极性标记，装反了会鼓包漏液
3. TVS 必须用**双向**型，不要用单向的；封装是 SMB，不是 0603

参考料号：`KS476M025D07RR0VH2FP0`（47µF/25V，φ5×7mm 直插）。

**⚠️ 更正**：本文档早期版本在这里写过"开源工程用的就是它"，**这是错的**。参考工程的网表里它自己的 C2 的封装是 `CAP-SMD_BD5.0-L5.3-W5.3-LS6.3-FD`——本体直径 5.0mm 的圆柱贴片，是**贴片铝电解**，不是钽电容。所以参考工程走的是"手册允许的另一条路"。本设计最后也回到这条路——用**直插铝电解**，理由是失效模式温和、好买好换，而叠装高度由电芯决定（约 21mm），7mm 高的直插电容远在下面。

#### 铝电解可以替代，MLCC 串电阻不推荐

手册原文是 "tantalum capacitors **or** electrolytic capacitors"，**两者并列**。筛选条件不是"钽"，是"**有 ESR**"。三条路的对比：

| | 47µF/16V 钽（6032） | 47µF/16V 贴片铝电解 | 100µF/16V MLCC + 0.5Ω |
|---|---|---|---|
| 本体尺寸 | 6.0 × 3.2 × 2.5 mm | ⌀5.0 × 5.3 mm | 1210 + 1206，两个元件 |
| 极性 | 有 | 有 | 无 |
| ESR @100kHz | 0.3～1Ω | 0.3～2Ω | 由电阻定，可精确控制 |
| **DC 偏压衰减** | 几乎没有 | 没有 | **5V 下只剩 50～70%** |
| −20°C 的 ESR | 约 2× | 约 5～10× | 约 1× |
| 失效模式 | **起火** | 鼓包、漏液（温和） | **短路** |
| 元件数 | 1 | 1 | **2** |

**换铝电解完全合格**——本设计最终就选了这条路。除高度外，钽电容没有任何电气优势，而失效模式最凶险（起火）。本板与主板叠装，但高度天花板是电池座里的电芯（约 21mm），钽电容省下的那 4.5mm 换不到任何东西，这笔交易划算。上面那张对比表里的"47µF/16V 贴片铝电解"一列，对应的就是本设计实际用的那一档（只是换成了直插）。

**MLCC 串电阻在电气原理上是对的**（串在电容支路上的电阻就是 ESR 的物理定义），但在这个场合不划算：

1. **省不下空间**——因为 DC 偏压衰减，要保证 5V 下真有 47µF 得买 100µF 的，而 100µF/16V 的 1210 MLCC 加一颗 1206 电阻，占板面积已经和一颗 6032 钽电容打平
2. **验证手段够不着**——按手册用钽或铝电解，验收只需示波器看纹波（第八节第 20 步）；自己串电阻要验的是**相位裕度**，需要网络分析仪或 Bode 注入，本工程没有。示波器看阶跃响应的过冲只能证明"没炸"，不能证明"有余量"
3. 多一个元件、多两个焊点
4. 反着来，出了问题厂商不认

**两条常见但我认为不成立的理由**，不要拿它们当论据：串电阻的发热（`VBOOST` 纹波电流约 0.21A RMS，0.5Ω 上只有约 22mW）；串电阻牺牲瞬态响应（`ΔV = ΔI × ESR`，与钽电容的 ESR 是同一回事，不构成区别）。

**什么时候 MLCC 串电阻是对的**：IC 手册明确标 `MLCC stable`（内部补偿）的场合，**串电阻反而是错的**；量产产品能做环路特性化时，串电阻可以省掉钽电容的成本和起火风险。两条都不适用于手工单板。

#### 但 `BAT` 端（`C6`/`C7`）不受这条约束——本文档用直插铝电解

上一节那一整套强制**只针对 `VOUT` 端**。手册在 `BAT` 端只规定了容量（22µF ×2），**没有限定电容类型**。本设计在这里用 **22µF 直插铝电解 ×2**，三条理由：

| 依据 | 说明 |
|---|---|
| **高频环流另有其人** | 按 7.20 圈定的回路，`BAT` 侧的高频去耦由 **`C5`（100nF）** 承担——它紧贴 `BAT` 脚，吃掉开关环流里最陡的那一段。`C6`/`C7` 是**体电容**，管低频储能与纹波基底；手册对 `BAT` 端只规定容量（22µF ×2）、不限类型。电芯本身就在这个节点上，是最大的一颗"电容" |
| **MLCC 在这一栏名不副实** | 手册要 22µF，但 22µF 的 MLCC 以 6.3V/10V 档为主，在 4.2V 偏置下有效容量通常只剩 30～50%，**两颗加起来往往还不到手册要求的一半**。铝电解没有直流偏压衰减，标称多少就是多少 |
| **这一栏对 ESR 本来就松** | `BAT` 脚同时是线性充电器的输出，`C6`/`C7` 实质也承担输出电容的角色。充电是线性通路，没有开关边沿，对 ESR 的要求远低于 `VOUT` 端——那一端的强制来自 VFM 环路补偿，这条环路在这里不存在 |

**选直插而不是贴片铝电解**：贴片型的高度只有直插（实际用的 φ4×7mm）的一半左右，但直插更好手工焊接与更换，也更容易在装配后换料。本板虽与格物主板叠装，但**叠装高度由 `BT1` 里的 18650 决定**（连座子约 21mm），直插电解 7mm 的高度远在下面；贴片省下的那 2mm 换不到任何东西，**取直插**。

**规格**：≥16V（`BAT` 最高 4.2V，16V 已有充足余量）、建议 **105°C** 规格。实际用的是 **22µF/25V、φ4×7mm**；25V 比 16V 更好找。

**代价要认**：

- **有极性**——直插铝电解本体上有负极白色条纹，丝印必须画极性标记，见 7.10
- **低温 ESR**——−20°C 下涨 5～10 倍（见本节上面那张对比表）
- **有寿命小时数**——按规格书的小时数降额使用

这三条在"室内手持、纹波小、温度低"的本项目场景下都可以接受。**如果将来要挪到室外或做成长期插电的桌面设备，这一条要重估。**

### 5.8 `H1`：充电时主板要不要断电

**这一节是使用者做的一个配置选择，不是技术优劣问题。** 两种行为都合理，取决于怎么用。

#### 两种配置

```
VBUS_CHG → H1 → D3 → V5V
             │
             └─ 闭合：USB 直供负载（边充边用）
                断开：切断主板供电（仅充电）
```

| | `H1` 闭合（边充边用） | `H1` 断开（仅充电） |
|---|---|---|
| **插上 USB** | 升压停，格物**继续运行**（走 `D3`） | 升压停 + `Q1` 断 → **格物立刻关机** |
| **拔掉 USB** | `V5V` 掉 → **格物复位** | 44ms 后升压起 → **格物冷启动** |
| 充电时 USB 端口总电流（`R4`/`R6`=1.1k） | **1150mA** | **1000mA**——**两者都必须配真正的充电头**，电脑 USB 口已经不够（见 4.5） |
| 充电时主板发热 | 有 | 无 |
| 电池没电了能不能边充边玩 | **能** | **不能** |

#### 为什么做成跳线而不是二选一

这个权衡没有明显赢家：

- **`H1` 闭合**胜在体验。手持设备"电池快没电了，插上充电线接着玩"是很自然的动作，砍掉它比较难受
- **`H1` 断开**胜在干净：充电时格物不在跑，不会在写 NVS 时被硬断电，板子也不发热

> ⚠️ **原文这里还有一句"顺带把 USB 2.0 端口 500mA 的坎直接消掉"，随 `R4`/`R6` 改成 1.1kΩ 一并作废了。** 1A 的充电电流下两种配置都超出了电脑 USB 口的能力，`H1` 断开不再带来"任何口都能充"这个附带收益。这是 `R4`/`R6` 那个改动的第二笔账（第一笔是 `F1`/`F2` 要放大，见 4.5）。

**一颗 2.54mm 跳线帽的价钱，换掉一次押错的风险。** 装上去、试两种、留下顺手的那个。

#### 不装跳线时的默认行为

**断开（仅充电）**，也就是"安全"的那一侧：

- USB 端口不会超载
- 不会出现"插着充电线格物还在跑、然后被硬断电"这种情况

**跳线帽掉了也是退回这个状态**，症状是"插上充电线格物就关机"——**这是设计行为不是故障**，别去查电路。

#### 一个容易混的地方

**电源板上已经没有总开关了**（`SW1` 已删除，见 4.4），别再指望 `H1` 能关掉整机。

| | 管什么 |
|---|---|
| 主板 `SW1`（`SS-12D10L5`） | 格物的 5V 轨。断开后格物不工作，**电源板照常运行** |
| `H1` | **USB 直供支路**（`VBUS_CHG` → `D3` → `V5V`） |

所以**「整机断电」只剩一条物理路径：把电芯从 `BT1` 里取出来**。主板开关断开只是把负载摘掉，升压仍在空载运行。板上是清楚的：电芯是唯一的供电总闸，`H1` 是板内的一次性配置。

---

## 六、接口定义

**三个接口，方向各不相同，不要混。**

| 接口 | 针 | 网络 | **能量方向** | 说明 |
|---|---|---|---|---|
| `BT1` | + | `VBAT`（EDA：`VBAT+`） | **输入**（电芯 → 板） | 电池正极触点 |
| | − | `B−`（EDA：`VBAT−`） | | 电芯负极，进板后经 `Q2` 才接到板地 `P−`（EDA：`GND`） |
| `CN1` | 1 | `V5V`（EDA：`5VOUT`） | **输出**（板 → 格物） | 到格物 H1 脚 1 |
| | 2 | `GND` | | 到格物 H1 脚 2 |
| `USB1` | VBUS / GND | — | **输入**（充电器 → 板） | **充电口**，只做取电，**不引出 D+/D-** |
| | CC1 / CC2 | — | | 各经 `R1` / `R2`（5.1kΩ）下拉到 GND，见 7.12 |

**定稿用的是 16 针 USB-C 母座，但只接了四个功能**（VBUS/GND/CC1/CC2），D+/D−/SBU 全部悬空，两个外壳脚接 GND。早期版本打算用 6 针纯电源座，实际采购到的 `TYPE-C 16PIN 2MD(073)` 是 16 针件——**电气上没有区别**，但"顺手把 D+/D− 接上"的念想仍然要断掉。

**充电只走 `USB1`。`CN1` 充不了电**，因为 `D3` 反向阻断了 `V5V` 到 `U1` 的 `VCC` 的路径（见 5.6）。这是刻意的——那条路径一旦打通，`U1` 会误判 `VCC` 在位而永不启动升压，形成自锁死循环。

**`BT1` 是保护电路的边界。** 电芯正负极直接落在电池座上，保护器件在板上串在负极回路里。座子焊死在板上、极性由机械结构固定，**但焊座之前仍要核对两个焊盘与 `+`/`−` 的对应关系**——丝印标反了没有第二次机会，见 7.21。

> ⚠️ **`BT1` 只放 18650 电芯。** 绝不要用一段导线或假电池从座子里灌 5V 进去"充电"——那是直接跨在电芯两端，绕过 `U1` 的限压限流和 `U2` 的全部保护，**会过充起火**。充电只有一个入口：`USB1`。

全系统共两个 USB-C 口，各管各的：

| USB 口 | 位置 | 用途 |
|---|---|---|
| **电源小板的 `USB1`** | 电源小板 | **只充电** |
| 格物主板的 USB-C（在 CORE-ESP32-C3 上） | 格物主板 | **只烧录 / 串口**，不充电 |

分开的理由：在一根线上同时处理电源和数据，会牵出"两个口同时插"的一堆边界情况。**而这一版里"同时插"从"不方便"升级成了"有倒灌风险"**，见 5.6 末尾。

---

## 七、易错点

按危险程度排序。

1. **`U2`/`Q2`（或 `IP3005A`）的 `B−` / `P−` 混淆**——保护器件必须串在**电池负极回路**里，`B−` 是电芯负极、`P−` 是板地。接反或跳过，保护完全失效，且症状是"平时一切正常，出事时全无反应"。
2. **⚠️ `Q1` 的源漏接反**——必须**源极（引脚 2）接 `VBOOST`、漏极（引脚 3）接 `V5V`**。接反后体二极管方向变成 `VBOOST → V5V`，**正好给电池供电打开一条路，`Q1` 完全失效**，而万用表量不出任何异常（见 5.6）。这是全板最隐蔽的坑。
3. **`Q1` 栅极只接了 `VBUS_CHG` 而没有 `R5` 下拉**——栅极浮空，拔掉 USB 后 `Q1` 不导通，输出永远起不来。
4. **两个 USB 口同时插**——电池供电时 `V5V` 是实打实的 5.0V（见 5.6），与电脑 USB 口没有电位差，**存在倒灌风险**。这条在早期方案里靠 `D2` 的压降天然避免，换成 `Q1` 之后没了。**必须遵守"先拔一边再插另一边"。**
5. **在 `VBOOST` 与 `V5V` 之间多串一颗二极管**——见 5.6，会凭空造出电池放电通路。**看似加保护，实际造故障。**
6. **`D3` 缺失或装反**——`V5V` 直连 `U1` 的 `VCC`，`U1` 误判 `VCC` 在位，升压永不启动，形成自锁死循环。装反则完全不充电。**注意 `D3` 无论 `H1` 怎么设都不能删**——它挡的是自锁，不是直供。
7. **`D2` 缺失或装反**——升压没有整流回路，输出建立不起来。
8. **`D1`（TVS）漏装或用成单向型**——手册强制要求。TVS 的作用是压住 `LX` 的**正向**振铃：`LX` 冲高时 `D2` 正偏导通，把节点钳在 `VBOOST + Vf`；`VBOOST` 再高就被 `D1` 钳住，所以 `LX` 的正向上限 ≈ TVS 击穿电压 + `D2` 的 Vf ≈ **7.0～7.7V**（`SMBJ6.8CA` 的击穿区间 6.46～7.14V），离绝对最大值 10V 还有 2.4V 以上。漏装会让 `U1` 长期工作在过压边缘。**它对负向振铃一点作用都没有**——不要以为装了 TVS 就两侧都保住了，见 7.11。
9. **`C3` 用了 MLCC 而不是钽/铝电解**——手册"strongly required"，低 ESR 破坏 VFM 环路补偿。本设计里 LC 双重极点在 **5.4kHz**、电解电容（ESR≈0.5Ω）的 ESR 零点在 **6.8kHz**，零点紧跟在极点后面补相位；换成 MLCC（ESR≈5mΩ）零点跑到 **677kHz**，等于不存在。症状是输出振荡或纹波远超预期，**万用表查不出来，必须用示波器**。串一颗电阻去伪造 ESR 也不行——见 5.7。
10. **有极性电容装反**——全板**四颗直插铝电解**（`C3`、`C6`、`C7`、`C9`）反装都会鼓包、漏液，容量名存实亡，通电久了还可能炸开。四颗的丝印都必须画极性标记，装配时逐个复核。
11. **`LX` 节点铺铜过大**——它是全板唯一的 dv/dt 噪声源，铜皮越大天线越大，寄生电容也越大（和回路电感谐振，振铃越凶）。`LX` 到 `L1`、`LX` 到 `D2` 的铜皮够用就行。**⚠️ 这一条是画板时的硬检查项，不是画完再测的验收项**（理由见第八节第 18 步）。**它同时管正向和负向两侧的振铃，而两侧的保护来源完全不同。**

    `U1` 的 `LX` 绝对最大值是 **−2V ～ 10V**，两侧都要管——本文档早期版本只提了 +10V 一侧。名义工作点是：开关导通 `−I_L × Rds(on)` ≈ **−0.11V**，开关关断 `Vout + Vf(D2)` ≈ **5.35V**。也就是说留给振铃的余量是 **负向 1.9V、正向 4.65V**——**负向比正向难防得多**，这个不对称本身就是信息。

    - **正向有外部救兵。** `LX` 冲高时 `D2` 正偏导通，把节点钳在 `VBOOST + Vf`；`VBOOST` 再高就被 `D1` 钳住，正向上限 ≈ **7.0～7.7V**。**`D1` 存在的理由在这一侧。**
    - **负向没有外部救兵，而且不该有。** `D2` 全程反偏、`D1` 挂在 `VBOOST` 而不是 `LX`，两样都够不着。`LX` 掉到约 −0.7V 时，芯片内部升压 NMOS 的**漏-体结**（`LX` 是漏极的 n+ 区，衬底 p 型接 GND）自行正偏导通，把振荡能量吃掉。手册把这个方向限死在 −2V，约束的不是引脚耐压，而是**再往下就会往衬底里注入载流子**——这块硅上同时跑着充电器的基准、误差放大器和比较器，轻则基准漂移、比较器误动作，重则闩锁。

    **所以负向只有几何这一条路，加元件只会更糟**：任何外加器件（肖特基、RC 缓冲、管子）的封装引线加走线本身就接近 nH 量级，接到 `LX` 上等于给一个几 nH 的回路再串 2～3nH，**方向和要解决的问题是反的**。振铃过冲 ∝ √(回路寄生电感) ∝ √(节点寄生电容)，这两个根号分别对应本条和 7.20。有效手段只有三个：收窄本条说的铜皮、收紧 7.20 的回路、选一颗结电容小的 `D2`。
12. **USB-C 的 CC1 / CC2 没有配 5.1kΩ 下拉**——用 C-to-C 线接现代充电器时**完全取不到电**，而用 A-to-C 线却正常。症状具欺骗性，极易误判为充电器或线材问题。
13. **`R5` 漏焊**——拔掉 USB 后 `Q1` 不导通、升压不启动，**输出彻底为零**。装成大阻值（如 100kΩ）则表现为"拔了线要等差不多一秒才有电"。
14. **以为还能"关掉电源板"**——`SW1` 删除之后 `VBAT → L1 → LX` 直连，只要电芯放在 `BT1` 里，升压就一直在跑。主板那颗开关在 `V5V` 之后，只摘负载不停升压。**唯一的物理断电方式是把电芯从 `BT1` 里取出来**（见 4.4、5.8）；长期存放不取电池，就是拿升压空载电流去耗电芯。
15. **先放电池、后接负载**——电芯落进 `BT1` 的瞬间触点就接通、升压随即启动，`V5V` 立刻是 5.0V。装配与调试时先接好 `CN1` 再放电池，别带电插拔格物的 H1 排针。
16. **`U1` 的散热焊盘不接 GND 或不焊**——手册原文是"the Radiator need connect GND"。悬空会显著恶化散热，充电时结温冲上热调节点，充电电流被反复削减。**`R4`/`R6` = 1.1kΩ（1A）之后这条从"建议"升级为硬要求**：1A 下线性损耗最坏 2.0W，`θJA` 只要比 55°C/W 差一点，热调节就会覆盖很宽的电压段，充电反而比 500mA 时快不了多少。
17. **`R4`/`R6`（`R_PROG`）用 5% 精度电阻**——充电电流一致性差。必须用 **1%**。本设计是**两颗 2.2kΩ 并联**（见 4.5），所以要求落在**两颗**上：并联不会把精度变好到超过单颗的水平，**两颗都是 5% 出来就还是 5%**，指望分选或配对是没用的。
18. **散热焊盘没从背面灌锡**——ESOP-8 的散热焊盘从正面烤不到。正确做法是**焊盘上留 4～6 个过孔直通底层 GND 铺铜，焊接时从背面用烙铁灌锡**，靠毛细作用爬上正面焊盘。过孔**不要做阻焊塞孔**，要开窗。这是布局阶段就要留好的。1A 下**顶层 `U1` 周围也该尽量铺铜**，别只靠背面那层。
19. **两个 22µF（`C6`/`C7`）只装了一颗**——手册明确要求 `BAT` 端并联两颗。
20. **大电流回路面积过大**——升压的开关环路是唯一一条"画错了就随机出问题、万用表查不出来"的规矩。**热回路在 `BAT` 侧，不在 `VCC` 侧**：

    - **开关半环（最凶）**：`C5`(+) → `U1` 的 `BAT` 脚 → `L1` → `LX` 脚 → 内部 NMOS → `GND` 脚与散热焊盘 → 回到 `C5`(−)。这一圈每一拍都要从 0 跳到 `I_L` 再跳回 0，边沿最陡，**周长压到 15mm 以内**
    - **二极管半环**：`L1` → `LX` 脚 → `D2` → `C3`/`C4` → GND → 回到 `BAT` 侧电容的地。电流是电感电流的转移，边沿稍缓，但同样要短

    **`VCC` 侧（`C2`/`C1`/`C8`）不在热回路上。** 这颗芯片充电时升压停、升压时没有 USB（见 5.3），两者从不同时工作，`VCC` 节点在升压运行期间本来就是 0V。那一侧只走 1A 直流，没有快速边沿；`C2` 管的是充电稳定与 44ms 启动延时（见 5.5），不是开关环流。**布局注意力放在 `BAT` 侧：`L1` 贴近 `LX` 与 `BAT` 两个脚，`C5` 紧贴 `BAT` 脚，`C6`/`C7` 就近但不必挤进 15mm 那一圈，它们的接地回流要短。**

    **⚠️ 这一条是画板时的硬检查项，不是画完再测的验收项。** 理由与 7.11 相同：`LX` 的振铃没有条件实测（见第八节第 18 步），所以约束必须提前到画图阶段执行——**用设计约束替代测量**。物理关系很直接：`LX` 的负向过冲 ∝ √(回路寄生电感)，而回路面积就是这个电感的决定因素。画完拿尺子量，不要指望事后补救。
21. **连接器与电池座的极性**——`U1` 没有输入反接保护，**保护电路也不防反接**。`CN1` 是 XH2.54，做防呆标记；`BT1` 的机械结构不允许电芯反装，但**焊座时焊盘与 `+`/`−` 的对应关系只能靠丝印和装配前复核**，焊反了就是电芯两端直接短进板子。另外 `BT1` 是**贴片座**：板上没有电源开关，换电芯就是唯一的关机动作，这个座子会被反复插拔，插拔力全部落在两个贴片焊盘上。焊盘按能大则大做，装配后别拽着电芯拔。
22. **`H1` 额定电流不足**——`H1` 走负载电流（约 150mA，峰值 0.36A），2.54mm 排针余量充足。**注意它不走充电电流**：`H1` 在 USB 直供那一路，`R4`/`R6` 改成 1.1kΩ 不改变它的额定值要求。
23. **`F1`/`F2` 只装一颗**——`F1`/`F2` 串在 VBUS 入口，**充电电流和负载电流都要从它身上过**，是唯一被 `R4`/`R6` 改动波及的功率器件。**单颗** 1.5A 保持的 PTC 在 60°C 下降额到 0.75～1.05A，**盖不住 1A 的静态工作点**；而这颗 PTC 和发着 1～2W 热的 `U1` 同在一块小板上，它感受到的温度高于室温。症状是"天凉快时充电正常，热了就时断时续"，**极易被误判为充电头或线材的问题**。按 4.5 **必须装两颗**（同型号 1.5A/1206 并联，合力约 2.4～2.7A）。
24. **并联的 `F1`/`F2` 分开放**——Eaton 的 PTC 应用指南要求并联的 PTC 处在相近的热环境里，否则保持电流会失衡、引起 nuisance trip。**两颗必须并排、朝向一致，而且要一起远离 `U1`**——别让一颗贴着充电芯片、另一颗撂在板子另一头。这条和 7.20 的热回路布局是同一个区域的事，画板时一起考虑。
25. **`Q2` 的共漏脚（引脚 2）焊盘空着**——`8205A` 的两颗 MOS 在封装内部共漏，引脚 2 不接任何网络电路也能正常工作（`S1 → 内部共漏 → S2` 是通的），但**焊盘不要空着：铺一小块独立的顶层铜皮焊上去**，只做散热与载流，手册的 6A 额定就是按焊盘铺铜给的。⚠️ **这块铜皮绝不能接到 GND 或任何其他网络**——那等于把保护 MOS 的漏极短到板地，保护彻底失效，而且症状和 7.1 接反一模一样。

---

## 八、上电与验证步骤

> **测电流一律用假电池。** `BT1` 是焊死在板上的座子，没有插头可以拔，所以第 4、5、9 步的串表要在电池座里做：拿一颗 18650 空壳（或一段外径 18 mm 的塑料棒配两片铜皮）当载体，正负引线从座子里引出，电流表串在引线之间。空壳的机械尺寸照真电芯做，**接触电阻和引线长度会影响实际压降，测低压端工况时要留意**。

**第一步，不接任何负载**（`CN1` 空载，`H1` 先断开，电池最后才放）：

1. 万用表测 `VBAT`、`VBOOST`、`V5V` 对 GND，确认无短路。**上电前先目视复核 `C3`/`C6`/`C7`/`C9` 四颗有极性电容的方向**——万用表查不出反装的铝电解，只能靠眼睛，见 7.10
2. 把一颗已充电的电芯放进 `BT1`，量 `VBOOST` 应为 **5.0V ± 0.1V**（这是芯片的稳压点）。**电芯落座的瞬间升压就启动，没有开关可以拦**，见 4.4
3. 量 `V5V` 应与 `VBOOST` 基本相同（`Q1` 导通，压降几十 mV 量级）

**第二步，测静态电流**：

4. `CN1` 空载，用假电池在电芯回路里串电流表。**应小于 1mA**（升压空载应进入 VFM 的极低功耗状态）。`SW1` 删掉之后**这就是唯一的待机电流**。手册给的是 **10～100µA**（`IBAT`，升压无负载 @`VBAT` 3.8V），实测落在这一档就对了；大一个数量级就回头查 9.2
5. 用假电池把可调电源接进 `BT1`，从 4.2V 缓慢降到 3.0V 以下：`V5V` 应在约 **3.0V 时掉到 0**，输入电流降到 µA 量级。**这个具体值手册没给**（`ICC` 表里的 40µA 是 "Boost start"，不是关断态），顺手量出来记下。这是对内置欠压关断 3.0V / 3.3V 滞回的唯一验收，也是删掉 `SW1` 之后唯一存在的"关机"形态

**第三步，测真实负载**：

6. 接上格物，跑真实固件，在 `V5V` 串电流表记录电流波形。**这是 3.1 节那个估算的实测校正**
7. 记录不同画面下的平均电流，得到负载区间
8. 用示波器看 `V5V` 的纹波（AC 耦合，20MHz 带宽限制）。**这是 5.7 节电解电容选型是否正确的验收**，也是全板唯一必须用示波器而不能用万用表的指标

**第四步，测隔离——本设计最关键的一组**

9. **插着 USB，电池充到 4.0V 左右，用假电池在电芯回路里串 µA 表**。读数应为充电电流（正）。**如果测到电池有电流流出（负），说明 `Q1` 的方向错了或没装**，见 7.2
10. **把充电线换成一根又长又细的**（故意让 `VBUS_CHG` 掉到 4.5V 左右）重测第 9 步。**这是 `Q1` 存在的唯一理由**（见 5.6），也是"看起来能省掉 `Q1`"那个方案会失败的工况
11. 量 `Q1` 的 `Vgs`：USB 在位时应为 **正值（约 +1V）**，USB 拔出后应变为 **负值（约 −5V）**

**第五步，测 `H1` 两种配置**

12. **`H1` 闭合**：插着 USB，格物应**照常运行**，`V5V` 约 4.65V
13. **`H1` 断开**：插着 USB，格物应**关机**，`V5V` 应接近 **0V**；拔掉 USB 后约 44ms 格物冷启动
14. **`H1` 断开 + 不插 USB**：`V5V` 仍为 **5.0V**——这是删掉 `SW1` 之后的默认状态，电池在位升压就在跑。要真正断电只有把电芯从 `BT1` 里取出来，取出后 `VBOOST` 与 `V5V` 都应为 0

**第六步，测充电与判停**

15. 拔掉电池，只接 USB，量 `V5V`：`H1` 闭合时约 **4.65V**，断开时约 **0V**
16. 接上电池充电，观察 `LED2`（充电中）与 `LED1`（充满）。**若 `H1` 闭合**，接上格物并让它跑起来制造负载。**`LED1` 必须能在电流降到约 200mA 时点亮**（`R4`/`R6` = 1.1kΩ 的 C/5 判停点）——这是 5.2 节整套拓扑是否真的生效的最终验收。**同时量一次恒流段电流**：电池在 3.5～4.0V 之间时串电流表应读到 **1000mA**；明显偏低（比如只有 700mA）说明要么 `F1`/`F2` 在发热降额、要么 `U1` 已进热调节，两者都指向散热或 `F1`/`F2` 选型，见 4.5
17. **反接测试**（放到最后做）：把 `USB1` 反接一次，确认无器件损坏

**第七步，测切换与振铃**

18. **`LX` 振铃实测——⚠️ 不具备测量条件，跳过。** 预期振铃频率在 **100MHz 量级**，超出业余仪器带宽（100MHz 的入门台式示波器也只是勉强，口袋示波器差几个数量级）；而且常规鳄鱼夹地线的电感在这个频率下阻抗已达几十欧，**远大于真实回路的几欧——测出来的会是探头自己造出来的振铃**。所以"买台便宜示波器"解决不了这一条。

    **替代方案是把约束提前到画图阶段**：本条原本要验的两个量，改由 **7.11（`LX` 铺铜）与 7.20（热回路 ≤ 15mm）**在画板时手工保证，画完拿尺子量。这不是"测不了就不验收"，是**用设计约束替代测量**——和附注第 10 条"不要靠一个你无法验证的量来保证性质"是同一条原则。

    真要留一条万用表能做的间接判据：`LX` 的负向过冲如果已经严重到往衬底注入，**症状全在充电器一侧**——4.2V 判停不准、`LED2`/`LED1` 状态乱跳、恒流段电流明显偏离 1000mA。这三项分别落在第 15、16 步，任何一项对不上，回头查 7.11 和 7.20。

    若将来有条件测（**≥200MHz 示波器 + 短地弹簧**，不能用鳄鱼夹地线），判据是：**正向峰值 ≤ 8V、负向谷值 ≥ −1.6V**（绝对最大 −2V ～ 10V，两侧各留 20% 余量）。
19. **插拔切换测试**：设备运行中反复插拔 USB，用示波器单次触发抓 `V5V` 最低点。**`H1` 闭合时预期约 44ms 后复位；断开时是硬断电**（见 5.5），确认这个行为可以接受
20. **热测试**：电池放到 3.3V 左右，插 USB 以 **1A** 充电，跑 30 分钟，用热像仪或手指摸 `U1` 表面，**同时用手指摸 `F1` 与 `F2`（要摸的是它们俩温度是否接近）**。⚠️ **判据和 500mA 时代完全不同，别沿用旧数字**：1A 下 `U1` 本来就工作在热调节点附近（见 4.5 后果二），外壳到 **70°C 上下是设计行为不是故障**。真正要查的是两件事——**`F1`/`F2` 是否发烫**（发烫说明它在降额边缘，是 7.23 那个坑），以及 **`U1` 是否明显高于 70°C**（说明 `θJA` 远超 55°C/W，散热焊盘或铺铜不到位）。任一命中就退回 `R4`/`R6` = 1.5kΩ（740mA）

---

## 九、待定项

### 9.1 充电电流设定（`R4`/`R6`）——**已定：库存 2.2kΩ ×2 并联（1A）**

**这条已不再是待定项，留档记录决策、实现方式与退路。**

| `R_PROG` 有效值 | 怎么实现 | 充电电流 | 充满（3000mAh） | USB 侧 | 热 |
|---|---|---|---|---|---|
| 2.2kΩ（原设计） | 库存单颗 | 500mA | 6.5～7.5h | ≤0.65A，任何口都行 | 结温约 80°C，宽松 |
| **1.1kΩ（选定）** | **库存 2.2kΩ ×2 并联** | **1000mA** | **3.5～4h** | **1.0～1.15A，必须真充电头** | 低于约 3.3V 时进热调节 |
| 1.5kΩ（退路） | 库存 1kΩ + 470Ω 串联 = 1.47kΩ | 约 748mA | ≈5h | ≤0.9A | 全程不触热调节 |

**选定 1A 的理由**：500mA 只有 0.17C，充满要 7 小时，对一颗 18650 太慢；1A 是 0.33C，仍在标准充电倍率以内，时间近乎减半。

**实现方式同样对着库存定**：不买 1.1kΩ，用**两颗库存的 2.2kΩ 0805 并联**得到，正好是 1.1kΩ 的精确值，省掉一笔采购，见 4.5。**两颗都必须是 1%**（见 7.17）——并联不会把精度补回来。

**两笔连带成本**（都写在 4.5、7.23、7.24）：`F1`/`F2` 同样改成**两颗库存的 1.5A/1206 并联**；`H1` 断开方案失去了"任何 USB 口都能充"这个附带收益。

**退路**：第八节第 20 步的热测试是判据。若 `U1` 明显高于 70°C、或两颗 `F1`/`F2` 发烫，就退回 **1.5kΩ 那一档**——全程不触热调节，是最稳的折中。库里同样没有 1.5kΩ，用 **1kΩ（#35）+ 470Ω（#34）串联**得到 1.47kΩ，约 748mA。全都是 0805，动一下烙铁的事。

### 9.2 升压 IC 的进一步优化——**建议放弃**

**手册其实给了这个数。** 电特性表的 `IBAT` 一栏，条件是「升压无负载，`VBAT` = 3.8V」：**典型 −10µA、最大 −100µA**。（早期版本只看了 "no-load current less than 10µA when Supply Voltage is 5V" 那一句，漏了这张表。）按最坏的 100µA 算，3000mAh 电芯能撑 **约 3.4 年**——"放在抽屉里几个月"完全不用担心。

**删掉 `SW1` 之后这条从"待机参考"升级成"关机漏电"**——电源板上已经没有任何东西能在电池接入时停掉升压，所以这个数就是整机待机时唯一在流的东西。手册给的 10～100µA 已经足够低，这一条的风险基本可以排除；第八节第 4 步仍然要实测一次，确认拿到的就是这一档而不是大一个数量级。

如果实测发现空载电流偏大，可选方向是换一颗同步整流 + 真关断的升压 IC——但那类通常是 WLCSP 或 SOT-563，**封装筛子会先把大部分候选筛掉**（已排除的 SGM66057A 就是例子）。

**倾向：先实测，不预设问题。**

### 9.3 电池温度保护（可选模块）

见 4.6。`TP5400` 没有温度检测脚。补齐方案是**用 NTC 网络在超出 0～45°C 时断开 `PROG`**（手册：`RPROG` 断开即进入 Shutdown）。

两条实现路径都不优雅：

- **一颗比较器**：把 4.7 节刚省下的元件又加回来
- **三极管 `Vbe` 阈值**：约 3 个元件，但精度差，且阈值本身随温度漂移——用它来测温度，误差会叠加

**倾向：先不做。** 但**如果冬天要在室外充电，这一条必须补上。**

### 9.4 其余

- `H1` **已定为 2.54mm 2 针排针 + 短路帽**（`LAIL-PZ2.54-2P-L`，额定 3A）。焊接跳线或 0805 零欧电阻的备选放弃，原因是改起来要动烙铁
- `L1` **已定为 `SLS6D38S100MTT`**（10µH ±20%，DCR 38mΩ max，额定 2A，7×7mm 屏蔽）
- **`C3` 用钽电容还是铝电解——已定：直插铝电解**（见 5.7）。钽省高度，铝电解失效模式温和且好买。叠装高度由电芯决定（约 21mm），高度不构成约束，取铝电解
- **保护器件选 `DW01A` + `8205A` 两颗，还是单颗 `IP3005A`**（见 4.3）——原理图已按 `DW01A` + `8205A` 定稿
- 是否加 INA219 做电量计（MPU6050 已占 `0x68`，需另择地址）
- 电量显示**不要用 ADC 读电压**——OCV–SoC 曲线中段是平的，80%→20% 只跨 270mV（见第五课）
- **板层数：二层。** 底层整块铺 GND，走线尽量全走顶层；热回路围一圈打过孔缝合。四层的判据是：输出电流上 2A、板上加第二路开关电源、或 **`LX` 节点的寄生参数在二层上压不下来**。⚠️ 第三个判据原本写的是"实测 `LX` 振铃超标"，**随第八节第 18 步改成不可测一并作废**——既然拿不到那个读数，判据只能换成画板时能判断的东西

---

## 十、参考资料

### 器件

| 内容 | 地址 |
|---|---|
| **TP5400 数据手册**（南京拓微 TOPPOWER，REV 2.1） | 立创 `C2891434` 页面附件，或 `toppwr.com` |
| DW01A 数据手册 | `hxymos.com/web/userfiles/productfile/Adatasheet/Other/SOT_23_6L_DW01A.pdf` |
| FS8205A 数据手册 | `forsemi.com/upfile/2021050616241190.pdf` |
| CJ3401 数据手册（长晶科技 P-MOS） | 立创 `CJ3401` 页面附件 |
| IP3005A 数据手册（`IP5306` 手册中列为官方推荐保护 IC） | `injoinic.com` |
| TP4056 / FP6291 / TLV3011 手册（上一版方案，留档对照） | 见 `dfrobot.com.cn` / `sunrom.com` / TI `SBOS300` |
| IP5306 数据手册（**评估过但未采用**，见 5.4） | `injoinic.com` 官网附件 |

### 可直接参考的开源工程

| 工程 | 为什么看它 |
|---|---|
| [`rushairer/tp5400-18650`](https://oshwhub.com/rushairer/tp5400-18650) | **本文档 `Q1` 那一块的接法直接取自这里。** TP5400 + IP3005A + CJ3401 + PTC + 0603 双向 TVS，标题就是"可边充边放 5V 输出"，有人评论说已下单 100 套移植投产。作者还录了一期切换电路的仿真视频（`https://b23.tv/VaKjpVg`） |
| [`Aknice/leiups-...`](https://oshwhub.com/Aknice/leiups-li-dian-chi3-7v-sheng-ya-chong-dian-yi-ti-dian-lu) | 离散派做法（TP4056 + SX1308 + PMOS 切换），**评论区有人实测出 0.5s 断电空窗**——`R5` 取值不当的典型后果，见 5.5 |
| [`wzw666/IP5306`](https://oshwhub.com/wzw666/IP5306) | 最流行的 18650 充电宝，看主流怎么用 IP5306；评论区有 10W 负载把主控烧穿洞的实测 |

### 背景

| 内容 | 地址 |
|---|---|
| 锂电池充放电特性与老化数据 | Battery University `batteryuniversity.com` |
| 升压变换器布局指南 | 各厂商 AN，通用原则见 7.11 / 7.20 |

---

## 附：与本文档配套的推理链

以下几条是从讨论中沉淀下来、**将来改动设计时必须重新走一遍**的判断，不是结论而是方法：

1. **两种账不能混用**——选器件看峰值电流，算续航看平均能量。混用会同时买错器件和算错续航。
2. **封装是第一道筛子，功能是第二道**——对一块手工板子，"你能不能焊上去"是**筛选条件**，不是备注。按功能选完再回头看封装，会得到一份漂亮的、装不起来的 BOM。
3. **别从"原理图上没画出某条路径"推断"电路里不存在这条路径"**——升压的无源通路、USB 的直连 VBUS、`Q1` 的体二极管，都是原理图上不显眼但物理上必然存在的东西。
4. **供电环路只有一个判据：上电那一瞬间，谁是活的。** 凡是会出现"输出为零 → `VCC` 仍被顶住 → 永远不启动"这种自锁的地方，都要单独走一遍。
5. **保护是最后一道防线，不是工作点**——凡是依赖保护动作才能正常工作的参数，都说明设计有问题。
6. **估算要标出来是估算**——3.1 节的负载、3.2 节的效率、4.5 节的散热，都是要实测校正的数，不要当结论引用。
7. **同一个功能，换位置实现可能比换器件实现更省**——`D2` 既是整流二极管又是倒灌屏障，`R5` 一颗电阻兼了栅极下拉与泄放，欠压门限交给芯片就省掉整个比较器。反过来也成立：**删掉一个元件往往比挪它更省**——`SW1` 原本挪进电感支路才合法，最后一算不如直接删掉，把断电动作交还给电池座和主板那颗开关。
8. **"加一颗保护器件"要先验证它到底保护了什么**——`VBOOST` 与 `V5V` 之间那颗二极管就是反例：它看起来在防倒灌，实际制造了一条电池放电通路（5.6）。**加器件之前，把所有方向的电流路径走一遍。**
9. **换芯片要连"它拿走了什么"一起记账**——`TP5400` 省了 8 个元件，但拿走了可调欠压门限、电池温度检测和输入电流自适应。**省下的元件数是收益，拿走的功能是成本，两个都要写进文档。**
10. **不要靠"电压余量"来保证一个必须成立的性质。** 这一版最核心的教训：`D2` 的反偏依赖一个会随线材、充电头、电池电量变化的几百毫伏差值，而 `Q1` 把它变成了一个无条件成立的开关条件。**凡是要在宽范围工况下都成立的性质，就用器件保证，不要用余量保证。**
11. **改一个地方，要回头查所有引用它的结论。** 加 `Q1` 之后 `V5V` 从 4.65V 变成了 5.0V，5.6 节里"`D2` 的压降顺带挡住了往电脑 USB 口倒灌"这条结论**当场作废**——那个附带保护是压降带来的，压降没了保护也就没了。**器件一换，它带来的所有"副作用"都要重新过一遍。**
    再举个同类的例子：`R4`/`R6` 的有效值从 2.2kΩ 改成 1.1kΩ（用两颗 2.2kΩ 并联实现）只动了**一个充电参数**，但顺着电流路径往回走，牵出两处——**`F1`/`F2` 是按 500mA 选的，1A 会把它推到降额曲线里**（7.23）；**5.8 节"`H1` 断开就没有 500mA 的坎了"这条附带收益，前提正是 500mA**，电流一改就没了。两处都不在"充电"这一节里，光看 `R4`/`R6` 那一行是发现不了的。**做参数改动时，要顺着它经过的每一个器件走一遍，而不是只改引用它的那几句话。**
12. **读别人的开源设计要读网表，不要读截图，更不要读描述。** 本文档一开始从截图和作者描述里**推导错了 `Q1` 的必要性**，拿到网表才看清楚它的源漏方向、栅极接法，以及它和 `R5` 的关系。作者自己的描述也会错——同一个工程里，作者把 `IP3005A` 的过放点写成 3V，手册实际是 2.5V。
13. **两难且说不清的取舍，用一颗跳线买回选择权。** `H1` 就是这条的实例：边充边用和充电时断电各有各的道理，取决于怎么用，事先想不到。**一颗跳线帽比一次押错的代价低得多**（见 5.8）。
