konamivrc6/Gewu/硬件接线.md

# Gewu 硬件接线

本文档是接线与上电的唯一依据。动烙铁之前请完整读一遍「易错点」和「上电前检查」两节。

---

## 一、器件清单

位号一栏以 EDA 原理图为准，**请按这一栏叫器件**。

| 位号 | 器件 | 型号 | 供电域 | 接口 |
|---|---|---|---|---|
| U1 | 主控开发板 | 合宙 CORE-ESP32-C3 | 5V 输入，板载 LDO 出 3.3V | — |
| U2 | 四路三态缓冲器 | SN74HCT125DR（SOIC-14） | 5V | 电平转换 |
| M1_MAX7219 | 8×8 点阵模块 | MAX7219 | 5V | 类 SPI，三线 |
| M3 | 六轴姿态传感器 | MPU6500 | 3.3V | I2C |
| SW4 | 旋转编码器 | EC11（五脚带按压） | 3.3V 逻辑 | 两相 + 按键 |
| SW2 / SW3 | 微动开关 | 6×6 四脚轻触 | 3.3V 逻辑 | 按键 |
| SW1 | 电源拨动开关 | SS-12D10L5 | 5V 主回路 | — |
| H1 | 2pin 排针 | — | 5V | 电源输入 |

---

## 二、三个电压域

| 域 | 谁在上面 |
|---|---|
| **5V** | H1 输入排针、SW1 拨动开关、U1 的 `5V` 脚、M1_MAX7219 的 VCC、C1（不焊，见 6.2）/ C4 / C6 / C7 / C8 / C9 / C10、U2 的 pin 14 |
| **3.3V** | U1 的 `3V3` 脚输出 → M3 的 VCC、十颗上拉电阻、C5 / C11 |
| **信号** | ESP32-C3 输出 3.3V，经 U2 抬到 5V 后送 M1_MAX7219；其余信号全程 3.3V |

三条铁律：

1. **M1_MAX7219（MAX7219）只吃 5V**
2. **M3（MPU6500）只吃 3.3V**
3. **上拉电阻一律拉到 3.3V**。

---

## 三、为什么需要 SN74HCT125

MAX7219 的输入高电平门限是 `VIH = 0.7 × VDD`，供电 5V 时即 **3.5V**。ESP32-C3 输出满幅约 3.3V，**差 0.2V**，属于「有时能用有时不能用」的区间，是最难排查的一类故障。

SN74HCT125 的 HCT 系列采用 TTL 电平输入：VCC = 4.5～5.5V 时 **VIH 仅 2.0V，VIL 为 0.8V**，3.3V 输入有充足余量。其输出为 5V 摆幅，正好驱动 MAX7219。

**排除掉的替代方案**：不要为了让 MAX7219 直接吃 3.3V 而把它接到 3.3V 供电。MAX7219 规定 VCC 最低 4.0V，3.3V 属于超规格使用。

---

## 四、主控引脚分配

### 4.1 合宙 CORE-ESP32-C3 官方可用引脚

官方共引出 15 路 GPIO。下表为官方文档给出的完整定义：

| GPIO | 复用功能 | 可用性 |
|---|---|---|
| GPIO0 | ADC_0、UART1_TX | 空闲 |
| GPIO1 | ADC_1、UART1_RX | 空闲 |
| GPIO2 | ADC_2、SPI2_CK | 空闲，**strapping** |
| GPIO3 | ADC_3、SPI2_MOSI | 空闲 |
| GPIO4 | **I2C_SDA**、ADC_4 | 空闲，官方标注 I2C，默认 JTAG MTMS |
| GPIO5 | **I2C_SCL**、ADC_5 | 空闲，官方标注 I2C，默认 JTAG MTDI |
| GPIO6 | — | 空闲，默认 JTAG MTCK |
| GPIO7 | SPI2_CS | 空闲，默认 JTAG MTDO |
| GPIO8 | — | 空闲，**strapping**，下载时会被拉低 |
| GPIO9 | BOOT 按键 | **占用，不可用**，strapping |
| GPIO10 | SPI2_MISO | 空闲，上电有 5ns 低电平毛刺 |
| GPIO11 | VDD_SPI | **需烧熔丝解锁，不可逆，不用** |
| GPIO12 | 板载 LED D4 | 可借用，需 flash 配 DIO 模式 |
| GPIO13 | 板载 LED D5 | 可借用，需 flash 配 DIO 模式 |
| GPIO18 / GPIO19 | USB D- / D+ | **简约版占用** |
| GPIO20 / GPIO21 | UART0 RX / TX | **经典版占用** |
| GPIO14～17 | 外置 SPI flash | **不可用** |

### 4.2 原理图脚号与官方脚号是镜像的

**这是本文档最容易踩的一条，调试前务必读。**

合宙官方引脚表从模块一端开始编号（pin 1 = GND、pin 31 = 5V、pin 32 = GND）。立创EDA 的 `CORE-ESP32-C3-ALL` 元件**从另一端开始编号**，所以原理图与网表里的脚号相对官方表是镜像的：

**完整映射表**

| 原理图脚 | 官方脚 | 官方名称 | 本项目信号 | GPIO |
|---|---|---|---|---|
| 1 | 32 | GND | GND | — |
| 2 | 31 | 5V | +5V | — |
| 4 | 29 | IO08 | `CLK_IN` → U2 pin 5 | GPIO8 |
| 5 | 28 | IO04 | SDA → M3 | GPIO4 |
| 6 | 27 | IO05 | SCL → M3 | GPIO5 |
| 8 | 25 | GND | GND | — |
| 10 | 23 | IO07 | 微动 2（SW3） | GPIO7 |
| 11 | 22 | IO06 | 微动 1（SW2） | GPIO6 |
| 12 | 21 | IO10 | `CS_IN` → U2 pin 9 | GPIO10 |
| 13 | 20 | IO03 | 编码器按压（SW4） | GPIO3 |
| 14 | 19 | IO02 | `DIN_IN` → U2 pin 2 | GPIO2 |
| 16 | 17 | GND | GND | — |
| 19 | 14 | GND | GND | — |
| 20 | 13 | 3.3V | 3V3 | — |
| 26 | 7 | GND | GND | — |
| 30 | 3 | IO01 | 编码器 A（SW4） | GPIO1 |
| 31 | 2 | IO00 | 编码器 B（SW4） | GPIO0 |
| 32 | 1 | GND | GND | — |

### 4.3 本项目分配

| 信号 | GPIO | 原理图脚 | 备注 |
|---|---|---|---|
| MPU6500 SDA | GPIO4 | 5 | 官方标注的 I2C 数据脚 |
| MPU6500 SCL | GPIO5 | 6 | 官方标注的 I2C 时钟脚 |
| 74HCT125 1A → DIN | GPIO2 | 14 | strapping 脚，见 4.4 |
| 74HCT125 2A → CLK | GPIO8 | 4 | strapping 脚，见 4.4 |
| 74HCT125 3A → CS | GPIO10 | 12 | 上电有 5ns 低电平毛刺，无害，见 4.4 |
| 编码器 A | GPIO1 | 30 | |
| 编码器 B | GPIO0 | 31 | |
| 编码器按压 | GPIO3 | 13 | |
| 微动开关 1（SW2） | GPIO6 | 11 | |
| 微动开关 2（SW3） | GPIO7 | 10 | |
| 备用 | GPIO12 / GPIO13 | 29 / 23 | 板载 LED，暂不动 |

### 4.4 U2 的三个信号输入：全部加 10k 上拉

**GPIO2（1A）、GPIO8（2A）、GPIO10（3A）各配一颗 10kΩ 上拉到 3.3V。**

两个理由，作用范围不同：

- **strapping**（只管 GPIO2 / GPIO8）：ESP32-C3 上电复位时采样这两个脚决定启动模式，SPI Boot 要求 GPIO2 = 1，Download Boot 还要求 GPIO8 = 1。而复位默认态里 **GPIO2 和 GPIO8 都是高阻、无内部上下拉**（只有 GPIO9 自带内部上拉）。不拉高就没有确定值。
- **CMOS 输入不能浮空**（三路都要）：U2 的四个 `OE` 全接地 = 恒使能，输出永远在被驱动。输入浮空会让输入级停在阈值附近，既产生贯穿电流，又让输出跟着噪声抖。

**Boot Mode Control**

| Boot Mode | GPIO2 | GPIO8 | GPIO9 |
|---|---|---|---|
| Default Config | – (Floating) | – (Floating) | 1 (Pull-up) |
| SPI Boot（默认） | 1 | 任意 | 1 |
| Joint Download Boot | 1 | 1 | 0 |

**IO MUX 复位默认态**：GPIO2 = 1、GPIO8 = 1（含义都是「输入使能，高阻，无内部上下拉」），GPIO9 = 3（内部上拉使能）。

**三路里 GPIO8 最要命。** MAX7219 接收数据要求 CS 为低**且** CLK 上有 16 个上升沿，缺一不可。把 CLK 钉成静态高，等于把整条误写入路径切断——即使 CS 抖到低，没有时钟沿也什么都移不进去。

---

## 五、分器件接线

### 5.1 电源链路

拨动开关 SW1 串在 5V 正线上。

| 从 | 到 |
|---|---|
| H1 脚 1 | SW1 一端 |
| SW1 另一端 | 5V 轨 |
| H1 脚 2 | GND 轨 |
| 5V 轨 | U1 脚 2（官方 pin 31，5V） |
| 5V 轨 | M1_MAX7219 的 VCC |
| 5V 轨 | U2 pin 14 |
| 3.3V 轨（来自 U1 脚 20，官方 pin 13） | M3 的 VCC |
| GND 轨 | 以下所有 GND |

必须接地的引脚：U1 的六个 GND 脚（原理图 1 / 8 / 16 / 19 / 26 / 32）、M1_MAX7219 的 GND、M3 的 GND、U2 pin 7、SW4 的 C 脚、SW4 按压开关的一脚、SW2 与 SW3 各一脚。

**电流估算**：ESP32-C3 开 WiFi 峰值约 350mA，MAX7219 高亮 200～350mA，**合计可达 0.7A**。SW1 的型号是 SS-12D10L5，该系列不同后缀额定从 0.5A 到 1A 都有，**下单前确认这一颗 ≥ 1A**。

### 5.2 SN74HCT125（U2）

封装 SOIC-14。注意右侧引脚是镜像排布，**pin 8 是 3Y（输出）、pin 9 是 3A（输入）**，输出在输入上方。

| 引脚 | 名称 | 接到 |
|---|---|---|
| 1 | 1OE（低有效） | **GND** |
| 2 | 1A | U1 脚 14（GPIO2） |
| 3 | 1Y | M1_MAX7219 的 DIN |
| 4 | 2OE | **GND** |
| 5 | 2A | U1 脚 4（GPIO8） |
| 6 | 2Y | M1_MAX7219 的 CLK |
| 7 | GND | GND |
| 8 | 3Y | M1_MAX7219 的 CS |
| 9 | 3A | U1 脚 12（GPIO10） |
| 10 | 3OE | **GND** |
| 11 | 4Y | 空置 |
| 12 | 4A | 接 GND |
| 13 | 4OE | **GND** |
| 14 | VCC | 5V |

**`1A` / `2A` / `3A` 三个输入各配一颗 10kΩ 上拉到 3.3V**，理由见 4.4。

要点：

1. **四个 OE 全部接 GND。** 低有效使能，为高时输出高阻，芯片等于不存在。
2. **数据方向是 nA → nY，同相不反相。**
3. **U2 输出是 5V 摆幅，绝不能接回 ESP32-C3 的引脚。**

### 5.3 MAX7219 点阵模块（M1_MAX7219）

模块两侧各有一排 5 针，一侧为**输入**，另一侧为**级联输出**。用输入那一侧。

| 模块脚 | 接到 | 网络名 |
|---|---|---|
| VCC | **5V 轨** | 必须与其他 5V 同网络 |
| GND | GND | — |
| DIN | U2 pin 3 | — |
| CS | U2 pin 8 | — |
| CLK | U2 pin 6 | — |

### 5.4 MPU6500（M3）

| 模块脚 | 接到 |
|---|---|
| VCC | **3.3V** |
| GND | GND |
| SDA | U1 脚 5（GPIO4），并配 4.7k 上拉到 3.3V |
| SCL | U1 脚 6（GPIO5），并配 4.7k 上拉到 3.3V |
| AD0 | **GND**（地址 `0x68`） |
| INT | 悬空 |
| XDA | 悬空 |
| XCL | 悬空 |

**I2C 上拉**：SDA / SCL 各配一颗 **4.7kΩ 到 3.3V**，不依赖 GY-521 板载（抄板可能装 10k 甚至不装，而裸 10k 在 400kHz 下上升时间超规范）。

### 5.5 旋转编码器 EC11（SW4）

| 编码器脚 | 接到 | 网络名 |
|---|---|---|
| A | U1 脚 30（GPIO1），并配 4.7k 上拉到 3.3V | `ENC_A` |
| C（中间） | **GND** | — |
| B | U1 脚 31（GPIO0），并配 4.7k 上拉到 3.3V | `ENC_B` |
| 按压一脚 | GND | — |
| 按压另一脚 | U1 脚 13（GPIO3），并配 4.7k 上拉到 3.3V | `ENC_SW` |

### 5.6 微动开关（SW2 / SW3）

| 开关 | 一脚 | 另一脚 |
|---|---|---|
| SW2 | GND（pin 4） | U1 脚 11（GPIO6），并配 4.7k 上拉 + 100nF 到地（pin 2） |
| SW3 | GND（pin 4） | U1 脚 10（GPIO7），并配 4.7k 上拉 + 100nF 到地（pin 2） |

100nF 与开关并联，靠近开关本体。

---

## 六、上拉电阻与电容

### 6.1 上拉电阻

**4.7kΩ → 3.3V，七颗**：编码器 A / B / 按压、微动 1 / 2（R1～R5），以及 I2C 的 SDA / SCL。

**10kΩ → 3.3V，三颗**：U2 的三个信号输入 `1A` / `2A` / `3A`（GPIO2 / GPIO8 / GPIO10），见 4.4。

共十颗。4.7k 那五颗接机械触点，需要湿电流；I2C 是开漏总线，4.7k 是标准值；10k 三颗是纯逻辑输入。

### 6.2 电容

| 位置 | 值 | 位号 | 说明 |
|---|---|---|---|
| M1_MAX7219 供电去耦 | 10µF MLCC ×3 + 100nF | C7 / C8 / C9 + C10 | **最重要的一组**，紧贴模块 VCC |
| M1_MAX7219 备用储能 | 10µF 电解 ×1 | C1 | **不焊接**，焊盘留空备用 |
| 5V 轨通用去耦 | 100nF ×2 | C4 / C6 | 其中一颗紧贴 U2 的 pin 14 ↔ pin 7 |
| 3.3V 轨去耦 | 100nF ×2 | C5 / C11 | 其中一颗在 M3 的 VCC 处 |
| 按钮消抖 | 100nF ×3 | C2（SW2）、C3（SW3）、C12（SW4 按压） | 与开关并联 |

### 6.3 消抖

| 输入 | 硬件滤波 | 软件消抖 |
|---|---|---|
| SW2 / SW3 / SW4 按压（`ENC_SW`） | 100nF 到地 | 10～20ms |
| **编码器 A / B（`ENC_A` / `ENC_B`）** | **不加** | 状态机查表法，或 PCNT 硬件正交解码 |

---

## 七、易错点

按危险程度排序：

1. **M1_MAX7219 的电源网络被拆成两个名字**（`VCC` 与 `+5V`）——PCB 上变成孤岛，点阵完全不亮，且毫无线索
2. **U2 的四个 OE 悬空**——输出高阻，MAX7219 完全不动，且现象毫无线索
3. **拿合宙官方引脚表对原理图脚号**——两边是镜像的（见 4.2），每一个信号都会对错
4. **MAX7219 去耦不足或 MLCC 耐压不够**——随机复位，误判为固件问题
5. **M3（传感器）的 I2C 走缓冲器**——I2C 是双向的，单向缓冲器必然失败
6. **U2 输出接回 ESP32，或把 GPIO2 / GPIO8 / GPIO10 / SDA / SCL 的上拉接到 5V**——5V 打坏 3.3V 引脚
7. **拨动开关额定电流不足**——峰值 0.7A，开关发热或接触不良
8. **5V 与 USB 同时供电**——可能倒灌，调试时只用一种
9. **AD0 接 5V**——打坏传感器
10. **编码器 C 脚接 3.3V**——接反，编码器不工作
11. **按钮接在 strapping 脚（GPIO2 / 8 / 9）上**——按住上电会进不了启动模式
12. **微动开关用同侧两脚**——永远导通，按键等同常按
13. **未共地**——所有 GND 必须连在一起
14. **占用 GPIO14～17**——外置 flash 在用，接上去会启动失败
15. **用 ESP32 内部上拉（45k）带编码器和按钮**——湿电流仅 73µA，低于 ALPS 的 1mA 最小额定。症状是「用了几个月才偶发丢步」，易误判为软件问题
16. **给编码器 A/B 并 100nF**——时间常数 4.5ms，吃掉脉冲，方向判断出错
17. **给 SDA / SCL 并电容**——I2C 线上只能有上拉电阻。4.7k 配 100nF 是 470µs 时间常数，总线直接瘫痪；按钮那套「上拉 + 100nF」不能套到 I2C 上
18. **把「SW1」当成编码器**——SW1 是电源拨动开关，编码器是 SW4；EC11 丝印上的 `SW1` / `SW2` 是它自己的脚名，三者互不相干
19. **U2 三个输入的上拉电阻漏装**（GPIO2 / GPIO8 / GPIO10 各一颗 10k）——GPIO2 / GPIO8 是 strapping，浮空会导致偶发启动或下载失败；三路浮空还会让 U2 输出在复位窗口跟着噪声抖，而这三条输出直通 MAX7219

---

## 八、上电前检查

**第一步，不插任何模块**：

1. 万用表测 5V 轨对 GND、3.3V 轨对 GND，确认无短路
2. 只上电，量 U1 脚 20（官方 pin 13，3V3）对 GND，应为 3.3V
3. **量 M1_MAX7219 那一排排针的 VCC 脚对 GND，应为 5V** —— 这一步专门用来抓「电源网络被拆成两个名字」那类错误，不量就发现不了
4. **验上拉装到位**：按住 RST 时，U1 的 GPIO2 / GPIO8 / GPIO10 对 GND 应为 3.3V（这三个脚此时高阻，量到的就是上拉电压）；拔掉 M3 后，它座上 SDA / SCL 对 GND 也应为 3.3V
5. 拨动开关来回拨几次，确认断电时 5V 轨真的掉到 0V

**第二步，逐个插模块**：每插一个测一次电压，确认后再插下一个。

**第三步，确认版本**：合宙 CORE-ESP32-C3 有经典版（板载 CH343 串口芯片）和简约版（USB 直连）两种。经典版 GPIO20/21 走串口，简约版 GPIO18/19 走 USB。**先从官方硬件资料页下载对应版本的原理图核对**。

**唯一不能热插拔的是 MAX7219 模块**，带电插拔容易打坏。

---

## 九、参考资料

### 开发板

| 内容 | 地址 |
|---|---|
| 板级文档（引脚定义） | `wiki-zh.luatos.org/chips/esp32c3/board.html` |
| 硬件资料（原理图） | `wiki-zh.luatos.org/chips/esp32c3/hardware.html` |
| 合宙资料总站 | `docs.openluat.com` |

合宙主域名 `wiki.luatos.com` 在本机网络环境下无法访问，使用中文镜像 `wiki-zh.luatos.org`。

原理图 PDF 直链位于 `cdn.openluat-luatcommunity.openluat.com/attachment/`，分别有经典版、简约版和参考尺寸三份。

### 芯片

| 内容 | 地址 |
|---|---|
| SN74HCT125 数据手册 | Nexperia `74HC_HCT125.pdf`（Rev. 8，2024-02-22） |
| ESP32-C3 硬件设计指南（中文） | `docs.espressif.com/projects/esp-hardware-design-guidelines/zh_CN/latest/esp32c3/` |
| MAX7219 数据手册 | Analog Devices `max7219-max7221.pdf` |
| MPU-6500 数据手册 | InvenSense `PS-MPU-6500A-01` |
| MPU-6000/6050 数据手册 | InvenSense MPU-6000/6050 Register Map and Descriptions |

ESP32-C3 硬件设计指南的 **Strapping Pins** 一节是 4.4 的依据，其中 Boot Mode Control 表和 IO MUX 复位默认态表务必自己看过一遍。

### 机电元件

| 内容 | 地址 |
|---|---|
| ALPS EC11 数据手册 | `www.farnell.com/datasheets/5205.pdf`（湿电流、抖动时间、Dummy 脚标注） |
| Bourns PEC11R 数据手册 | `www.bourns.com/docs/product-datasheets/PEC11R.pdf`（官方推荐滤波电路） |
| SS-12D10 系列规格 | 立创商城对应型号页，重点看额定电流 |

### 开发环境备注

- Arduino 板型选择：**AirM2M CORE ESP32C3**
- flash 模式：**DIO**（使用 GPIO12/13 时必须）。本板型**固定为 DIO、无需设置**——esp32 核心的 `boards.txt` 里 `AirM2M_CORE_ESP32C3.build.flash_mode=dio` 是写死的，板型菜单里根本没有 Flash Mode 这一项（已用 `arduino-cli board details` 核对），不必去菜单里找
- 串口日志波特率：921600
- 经典版需安装 CH343 驱动，默认 CDC 驱动只能打印日志、下载会失败

### 其他入口

**立创开源硬件平台**（`oshwhub.com`）搜索「合宙 ESP32-C3」，已有引脚全引出拓展板的开源工程，可直接打开抄封装与网络。
