konamivrc6/Gewu/物块模式_物理设计.md

# 物块模式 · 物理模型设计

本文记录物块模式物理内核的设计结论与推导过程。**重点是前提和推导链**——结论本身只有几行，但如果不写清怎么来的，后来的人（包括几个月后的自己）会重新走一遍已经走不通的路。

正文是结论与推导。附录是被逐一评估的候选方案、被否掉的思路、以及能判别方案优劣的实验设计——那部分和结论一样有价值，因为重走某条路之前，值得先知道它已经被试过、以及为什么不行。

---

## 一、前提

**世界**

1. 世界是 8×8 的 64 个像素，没有别的空间
2. 有若干材料模式：水、物块、钢珠。一个场景内的对象同质——要么全是水，要么全是物块，要么全是钢珠；材料只改参数，不改几何与占据原语
3. 物块模式下，**一个物块的大小就是一个像素**

**硬性要求**

4. 每个像素同一时刻最多被一个对象占据
5. 场景里有 N 个对象时，**始终有且仅有 N 个像素被点亮**。是"始终"，不是"通常"、"大多数时候"或"偶尔例外"

要求 5 不是一条独立约束。它等于要求 4 加上"每个对象恰好映射到一个像素"这个显然成立的事实——渲染本来就是函数。所以**只需保证要求 4**，要求 5 自动成立。后文所有强弱判定都只针对要求 4。

**运动模型**

6. 要牛顿动力学：连续位置、连续速度、连续的重力方向
7. 重力来自 MPU6050，要能任意角度倾斜，包括接近水平与翻转

**硬件**

8. 目标芯片 ESP32-C3 是 RV32IMC，**没有硬件浮点单元**，浮点靠 libgcc 软件模拟。定点数走硬件乘法器，快一个数量级，且跨平台逐位一致
9. 所以全程用 Q16.16 定点。原型也用定点，为的是将来能逐位移植

---

## 二、推导

### 2.1 为什么不用格子气 / 元胞自动机

元胞自动机天然满足要求 4 和 5，代价最小。否掉它的理由是**方形格点的各向异性无法通过调参消除**：HPP 模型（1973）在方格点上沿轴向和沿对角线的输运性质不同，水流会阶梯化。恢复各向同性需要六边形格点（FHP）或至少 D2Q9 速度组，而 8×8 是方格，做不了六边形；D2Q9 在 64 格上已经不是玩具了。

附带一条：格子气要把重力方向量化成 4/8/16 个方向，倾斜板子时表现为"跳着翻面"，这直接违反前提 7。

### 2.2 为什么"牛顿动力学 + 事后修补"行不通

第一版原型就是这个思路：连续位置 + 硬球碰撞，每子步结束后检查有没有两个对象落在同一格，有就把其中一个瞬移到邻格、并把它的速度分量归零。

**几何层的不相容。** 碰撞原语是半径 0.5 的圆盘，占据原语是格子。这两个谓词无法调和：

- **距离可以任意小却分处两格**（紧贴格边界两侧的两个点），所以任何有限直径都会把"邻格"误判成重叠
- **同格的两点最远可以相距 √2**（对角），所以要让同格必然重叠，直径得 ≥ √2

一个要求直径趋近 0，一个要求直径 ≥ √2，**无解**。所以"两条约束都得显式写"在圆盘前提下是对的。

**表征层的问题更根本。** 不变量根本不在状态里，它是状态上的一个**谓词**，每子步被检查一次，不成立时被修补。这个架构致命的地方在于：修补是局部贪心、无势函数、无单调量的迭代，**不保证收敛**。而一个不保证收敛的修补每子步施加一次，就是紧致集上的不可逆分段映射——这类映射的通有吸引子是**周期轨道**。所以观察到的冻结不是参数没调好，是这个复合映射的预期行为，**调参调不出收敛**。

实测印证：40 seeds × 3000 帧，帧末点亮数出错率在任何参数下都不为零，tilt 80 时 0.11%。把静止判定阈值调到最优之后仍有 0.01~0.09%。

顺带一个当初把症状当成成功的问题：第一版的静止判定阈值 `v_sleep = 0.0022` 选在了每子步重力 `0.0012` **之上**。物块贴墙时每子步刚加上的重力立刻被清零，于是整段运行**动能恒等于 0**——动力学完全冻结，位置还能变，全是因为修补层在动。看到"末帧动能为 0"以为是收敛得好，其实物理已经死了。

### 2.3 关键转折：让碰撞原语等于占据原语

2.2 节那个"无解"的证明**只对圆形成立**。它证明了"圆盘"与"格子"不相容，但没证明"格子"与"格子"不相容。

换一个问法：与其在两种形状之间调和，不如**让碰撞形状和占据形状是同一个东西**。

于是：物块的碰撞体就是它所在的那一格——边长 1、边与格线对齐的正方形。这样"两个物块重叠"和"两个物块同格"不再是两个可能互相矛盾的谓词，而是**同一个谓词的两种说法**。它们不可能打架，因为它们是同一件事。

一个像素大的物块，碰撞形状就该是一个像素。原来选圆形才是那个错误的自由选择。

### 2.4 非牛顿操作不可避免，问题只在放在哪里

重力是常向量场，在水平／垂直的格边上有非零法向分量，所以流必然穿出"合法集"的边界。（换个说法也一样：任何碰撞本身就是非光滑操作。）**所以想靠纯动力学维持要求 4 是不可能的，任何实现都必须在格边处做点什么。**

那么设计空间就只剩下一个问题：**这个操作放在哪里？**

- 放在**越界之后**（第一版的做法）：位置已经错了，唯一的修法是改位置——于是只能表现为瞬移加抹速度。瞬移不守恒动量，抹速度凭空吃能量，而且修补会在别处制造新的违反
- 放在**格边之上**：它表现为一次法向冲量交换加切向摩擦，也就是**一次完全合法的接触**

第一版的病根不在"引入了非牛顿操作"——那不可避免——而在**放错了位置**。

### 2.5 结论

把"一格一物"从**事后修补的约束**提升为**状态的不变量**：

- 每块显式持有一个整数格号 `(cx, cy)`，以及格内的连续相位 `(px, py)`
- **格号只在一条代码路径上被改写，且只在目标格为空时改写**
- 穿越格边是一个**事件**：目标格为空则提交（位置连续，无瞬移，只改格号）；目标格被占则该面成为实心接触；目标是界外则是墙

因为格号只能"迁入空格"，所以"N 个物块占用 N 个互不相同的格"是**构造性成立**的——不是被检查出来的，也不可能被破坏。

---

## 三、方案要旨

**状态**：每块 `(cx, cy)` 整数格号 + `(px, py)` 格内相位 + `(vx, vy)` 连续速度。另有一张 `owner` 表，格号到块号的映射。

**每子步**：积分速度与相位 → 逐块逐轴做"跨格门"。门里只有三种结局：界外撞墙、目标被占走接触、目标为空则提交。

**不变量为什么是构造性的**：`owner` 表与格号只在提交那条路径上一起改写，而提交的前置条件是目标格空闲。所以任意时刻格号两两不同，归纳成立。

**顺带的好处**：热路径是 O(N)（每块每轴一次目标格判定），比第一版的 O(N²) 配对求解加整个修补 pass **更简单**。对没有 FPU 的 C3 是好事。

---

## 四、验证

不变量用**独立于引擎**的检查函数复核（不用引擎自己的计数器——那个把"修补工作中"和"修补放弃了"混在一起，读不出东西）。检查器在 `sim/checker.py`：除格号重复外，还查"相位跑出本格"和"`owner` 表与块状态互为逆映射"。整套用例在 `sim/particle/eval.py`，一条命令重跑：

```
python sim/particle/eval.py invariant --engine v2
```

| 场景 | 帧数 | 违反 |
|---|---|---|
| 原失败配置（tilt 80 / seed 5 / n 6 / 400 帧） | 400 | **0**（末帧 6/6，原实现为 5/6） |
| 20 seed × 7 倾角 × 800 帧 | 112000 | **0** |
| n = 1,2,4,8,16,32,48,64，连续随机倾角 × 600 帧 | 4800 | **0** |
| n = 6,24,64，快速正弦扫掠 × 900 帧 | 2700 | **0** |

合计 11.99 万帧，零违反。n=64（满屏）也能稳定维持。同样这 11.99 万帧跑 `--engine v1` 得到 **99.181%** 的点亮正确率和 **982 个违反帧**——这个对照就是"强保证"和"弱保证"的区别。原失败配置在 v1 下第 332 帧破了，在 v2 下 400 帧一次没破。这个帧数本身依赖算术实现：定点乘从向下取整改成就近取整之前，它第 23 帧就破了；取整的半值方向又从向上改成远离零之后，v1 的违反帧数从 858 变成 982——所以别把具体帧数当成常数，能复现的是"某帧必破"。

**动能残差**（`python sim/particle/eval.py kinetic --engine both`）：无重力、阻尼置 1、恢复系数 1、无摩擦，n=6 挤在左上角跑 600 帧。这是弹性台球，能量损失只可能来自非牛顿操作，不会和真实的非弹性碰撞混在一起。v1 保留 **33.90%**，v2 保留 **100.00%**（六位小数不变）。格子锚定在无耗散条件下严格守恒，v1 的修补层把三分之二的动能吃掉了。

### 4.1 各向异性

否掉格子气的原始理由就是方格点的各向异性。这版换掉了碰撞原语，但没有换掉**方格的轴**，所以必须验。两步：

**原始曲线**（`python sim/particle/aniso.py`）：倾角 0° 到 90° 以 1° 步长，从同一初态跑到静止（画面连续 30 帧不变且速度低于 0.02 格/子步），记录**用格号算的**质心。μ = 0.3 / 0.55 / 0.8 各跑一遍。

**镜像检验**：世界是正方形，转置 `T(x, y) = (y, x)` 把世界映到自己，并把倾角 θ 映成 90° − θ。如果动力学对 T 等变，那么用 `T(S)` 在 90° − θ 下跑出的质心，必须等于用 `S` 在 θ 下跑出的质心的转置。两者的距离就是各向异性的直接度量，不用人眼去认台阶。

| μ | 镜像残差 最大 | 平均 | 零残差角度 | 跳变最大角度 |
|---|---|---|---|---|
| 0.3 | 0.0000 | 0.0000 | **91/91** | 80° |
| 0.55 | 0.1976 | 0.0022 | **90/91** | 72° |
| 0.8 | 0.0000 | 0.0000 | **91/91** | 68° |

唯一的残差在 μ = 0.55 的**恰好 45°**：那里 `|vx| = |vy|`，按速度分量定轴序的规则遇到平局，只能退回先 x。这是一个测度零的例外——确定性的顺序更新在对称点上诉诸二进制选择，不可能同时对称。门若固定先 x 后 y，同样条件下残差会在 37 个角度上非零，最大 0.50 格、平均 0.088 格。

雪崩阈值随 μ 单调移动：μ = 0.3 的过渡铺在 76–81°，μ = 0.55 集中在 72–73°，μ = 0.8 在 68–71°。按附录 C 的判别法，这是**真实的颗粒阈值行为**，不是量化假象。

**这次检验还揪出三处方向性偏置**，都在定点层或边界处理里，和格子无关：

1. `mul` 用算术右移，对负乘积向下取整。负乘积占所有乘积的一半，于是每一次乘法都把世界往负方向拉一点。改成就近取整
2. `_pair_friction` 里的 `d >> 1` 作用在有符号的切向冲量上，同样向下取整。改成对称的除二
3. 左/上边界落在 cell 0 的**闭端**：位置恰好走到 0 时格号仍是 0，门看不见，于是左墙比右墙晚一个子步响应。补一次位置在 0 处的墙判定

修完之后，左右镜像在**逐块逐子步**的意义上严格相等（45/52/67/72/80° 各跑 800 子步，逐位相同），质心残差在所有 91 个角度上为零。这条值得记住：**一个对称的世界，只有算术也是对称的，结果才是对称的。**

**尚未验证**：滞后回线、吞吐数字（`sim/particle/eval.py ops` 只给运算计数，没有周期数）。

### 4.2 转动

板子在转，格子坐标系就是非惯性系。角速度 `Ω = (Ωx, Ωy, Ωz)`、角加速度 `Ω̇`，块的平面内位置 `r`、相对速度 `v`，三个伪力在平面内的分量是（单位质量）：

| 项 | 平面内表达式 | 参与的分量 |
|---|---|---|
| 离心 | `((Ωy² + Ωz²)·rx − ΩxΩy·ry, (Ωx² + Ωz²)·ry − ΩxΩy·rx)` | 三个都参与 |
| 科氏 | `2Ωz (vy, −vx)` | 只有 Ωz |
| 欧拉 | `Ω̇z (ry, −rx)` | 只有 Ω̇z |

科氏与欧拉的平面内分量只由 z 分量给出——`Ωx`、`Ωy` 的那部分**垂直纸面**，被底板的支持力吃掉，平面内看不见。离心不一样，三个分量都有平面内贡献：转轴躺在板面里时（把板子当桨叶翻），块会沿"离开转轴"的方向被推开。所以只做 `Ωz` 不够，三个分量都要进离心项。

"转轴在平面内"和"倾斜"不是一回事：倾斜是**重力方向**在体坐标里变了，由 `set_tilt` 管；`Ω` 管的是非惯性系的伪力。要模拟一段自洽的翻板动作，两者得按同一条轨迹一起更新。真机上这两样都由加速度计与陀螺直接给出，不需要显式跟踪姿态。

**转轴不需要知道。** 加速度计读的是 `a_spec = a_原点 − g`，而惯性系里 `a_块 = a_原点 + Ω×(Ω×r) + Ω̇×r + 2Ω×v + a_相对`。两边消掉 `a_原点`，剩下的正好是 `−a_spec` 加那三个伪力，`r` 从**加速度计**量起。加速度计偏心带来的那份离心读数不是误差，它正是把原点从板心搬到加速度计的那一项。手绕腕关节转、绕桌角转、平放原地拧，同一套式子都成立。模拟里的 `pivot` 就是"加速度计落在哪一格"，默认板心。

**检验**：转置 `T(x, y) = (y, x)` 把世界映到自己，但角速度是**赝矢量**，镜像下按 `Ω' = (−Ωy, −Ωx, −Ωz)` 整体取反。所以 `S` 在 `Ω` 下的解，必须等于 `T(S)` 在 `Ω'` 下的解。`sim/particle/rot.py` 从这里取质心残差，和 §4.1 的倾角镜像同一套路，多出来的 Ω 符号正好抓科氏或欧拉写反。

实测 μ = 0.1 / 0.2 / 0.4、转速 0.25~2 转/秒、恒定转速与带升速斜坡两种，质心残差全部 **0.0000**；加上重力与倾角（`--gravity 0.0012 --tilt 30`）同样是 0.0000。转轴取 `(0,0,1)`、`(1,0,0)`、`(0.3,−0.7,0.2)`、`(−0.4,0.9,−0.6)` 等任意方向，结果一样。g = 0 的用例里进一步逐项比对状态，`S / Ω / Ω̇` 与 `T(S) / Ω' / Ω̇'` 在 1200 个子步内**逐位相同**，包括 Ω̇ = 1~3 转/秒² 的强角加速段。加上重力之后逐位一致会停在某个子步——都是某块的速度恰好 `|vx| = |vy|`，按速度定轴序遇到平局只能退回先 x。这就是 §4.1 那个测度零的平局在转动里的复现，不是新问题；质心残差仍然是 0.0000。

**这一项又揪出一处定点偏置。** `mul` 原来的"就近取整"是 `(p + 0x8000) >> 16`，半值向上：`+72.5 → 73`，`−72.5 → −72`，取负不交换。平局本该是测度零，但这个世界的格心全在半整数上，转动一开始 `Ω̇×r` 对每个块都恰好落在 .5 上，于是镜像两侧从第一个子步就差 1 LSB，再被混沌放大成完全不同的末态（质心残差一度到 3.99 格）。改成半值向远离零的方向取整后归零。C 移植必须照抄这个分支：`p >= 0 ? (p + 0x8000) >> 16 : -((-p + 0x8000) >> 16)`。

**行为**：居中的 4×4（n = 16）平放，绕板心以 0.5 转/秒恒定转动，1800 帧后：

```
##...###
#......#
#.......
........
........
......#.
#......#
###...##
```

十二块落在四个 2×2 的角里，平均半径 4.34（这个初态的最大可能半径是 4.95）。剩下四块卡在墙中段——不是没滑到，是被先到的块挡住了：角里填满之后，沿墙的队列就堵住。这是颗粒堵塞，不是 bug。**关掉板面摩擦时**（`--plate-friction 0`）同样条件下 0.25 / 0.5 / 1.0 转/秒都是 12/16，末态画面在 0.25 与 0.5 下逐位相同。默认开着板面摩擦（§4.3）后，低速端会被静摩擦钉住，这个画面只在临界转速以上成立。

**转轴躺在板面里**时行为完全不同。`--axis 1 0 0`（绕板心的 x 轴、0.5 转/秒）把居中 4×4 分成上下两条，平均半径 3.20，一块也不在角上：

```
··████··
··████··
········
········
········
········
··████··
··████··
```

这一项是二阶的（Ω²r），比绕法线转的甩出弱，但不是零；任意方向的转轴会把三项叠加起来。

**关掉板面摩擦时，转速不是参数。** g = 0 时墙边的法向力、切向驱动、块-块与块-墙的摩擦上限都正比于 ω²，三者一起约掉，所以贴墙的块是滑向角还是原地粘住只由 μ 与几何决定。实测恒定转速下（`--plate-friction 0`），μ = 0.1 / 0.2 在 0.25~2 转/秒的角落数全是 12/16；μ = 0.4 时在 8~12 之间浮动，摩擦大了，堵塞的落点更依赖轨迹。但**排列不严格不变**：阻尼和恢复系数的速度阈值都是按子步给的绝对量，不是尺度无关的；带上 1 秒的升速斜坡时，欧拉项的瞬态还会改变块落在墙上的位置。要验的是"角落数"这种粗统计量，不是逐位末态。

**定点开销**：n = 6 时每帧从 124 次升到 392 次（每个块四个 `mul_sq` 加两组乘加），仍远低于 v1 的 1352 次。开着板面摩擦时再添 60 次（每块每子步一次 `hypot`、一次 `div`、两次 `mul`），到 452 次。C3 的预算按这个数对表。

**低速量化地板**：ω² 本身是 Q16.16 里的小数，ω ≲ 0.05 转/秒时对靠近转轴的块 `ω²·r` 会掉到半个 LSB 以下。没有板面摩擦时，这些块不动是量化而不是物理；开着板面摩擦时，更早就会出现真正的不动——那是静摩擦，不是量化。两者在 `rot.py` 里可以通过 `--plate-friction 0` 区分开。

### 4.3 板面静摩擦

§4.2 末尾原来记着"底板没有摩擦"这条待办。现在补上了。

物理上法向压力不是另一个自由参数：总重力是一个向量，平面内分量 `g∥` 与法向分量 `N` 满足

    N = sqrt(G² − g∥²)

`G = gravity_total`，默认与默认的平面内重力相同（0.0012）。板子竖直（g∥ = G）时 N = 0，块是在一个竖直的框里滑，板面不提供摩擦；板子平放（g∥ = 0）时 N = G，全重力压在板上。同一个式子把两种姿态接起来，不需要第二套参数，也不会出现"竖直板上也有摩擦"这种自相矛盾的配置。

摩擦按库仑模型每个子步扣一次速度：

    |v| > μ_p·N  →  v ← v·(|v| − μ_p·N)/|v|
    |v| ≤ μ_p·N  →  v ← 0

第二行就是静摩擦。它不是单独的"静止判定"，而是同一条库仑规则的零速端：本子步能提供的冲量够抵消，块就停在原地。已经滑起来的块走同一行，所以动摩擦与静摩擦共用一个系数。

**切向必须用精确模长。** 逐轴夹紧（vx、vy 各自减 μN）实现起来少一次开方，但摩擦锥会变成方的：45° 方向的静摩擦阈值比轴向高 √2 倍，倾斜扫描一眼就能看出来。`sim/fixed.py` 里为此加了 `hypot`，每块每子步一次 `isqrt`。量程上界 3.09e9，C 里用 uint64 中间量。

**启滑阈值**（`python sim/particle/eval.py plate`）：单块、空盘、无墙，逐 LSB 扫平面内重力，240 帧内不动就算卡住。

| μ_p | 连续解 g∥ | 实测阈值 | 实测/连续 | 阈值处 N |
|---|---|---|---|---|
| 0.20 | 0.000235 | 0.000244 | 1.037 | 0.001175 |
| 0.35 | 0.000396 | 0.000412 | 1.039 | 0.001127 |
| 0.55 | 0.000578 | 0.000595 | 1.029 | 0.001042 |
| 0.90 | 0.000803 | 0.000809 | 1.007 | 0.000887 |

连续解是 `g∥ = G·μ/√(1+μ²)`，因为 N 自己随倾角变。实测比它高 0.7%~3.9%：`μ_p·N` 取整到最近的 LSB，阈值是第一个超过它的整数，再叠上 0.9995 的阻尼因子，所以只能落在整数 LSB 上。

**最小演示**：`python sim/particle/run.py --scene center --n 16 --gravity 0.0003` 跑 300 帧，一次跨格都没有（提交 0、阻挡 0、撞墙 0），块钉在原地；把 `--gravity` 换成 0.0006 就翻过阈值，块滑到底墙堆起来。

**转动**：`rot.py` 默认平放（g∥ = 0），板面摩擦是满的。居中的 4×4 在 0.25 转/秒及以下一块都不动（末态逐位等于初态），0.30 转/秒 4/16 到角，0.35 转/秒 8/16，0.5 转/秒 12/16。临界转速的粗估是

    ω_c = sqrt(μ_p·N / r)

4×4 外圈到板心的距离约 2.1 格，μ_p = 0.35、N = 0.0012 给出 0.27 转/秒，和实测的 0.25~0.30 对上。这条比 §4.2 记的量化地板干净：那里是 ω²r 掉到 LSB 以下，这里是真实的静摩擦。镜像残差在开着摩擦时仍是 0.0000——摩擦锥是圆的，转置与取负都严格交换。

**开销**：n = 6、平放、有速度时，不转每帧 211 次（其中 12 次 `hypot`、12 次 `div`），转动时 452 次。竖直板（N = 0）时 `fdv = 0`，函数直接返回，回到 124 / 392 次，一分钱不多花。

**还没做的**：

- 只有一个系数，μ_s = μ_k。真实材料的静摩擦系数通常比动摩擦高 10%~50%；要区分得再加一个参数和一条"是否从零起滑"的分支
- 转动产生的离面分量没有计入 N（`−2Ω×v`、`−Ω̇×r` 的 z 分量，以及 `Ωz·(Ωx·rx + Ωy·ry)`）。平放绕法线转时它们为零；绕平面内的轴转时会让一部分块压得更紧、另一部分松脱，这里一律按压紧处理
- 支持力不能为负，块不会离开板面——和 §4.2 记的是同一条限制

### 4.4 固件移植与逐位对照

C++ 内核在 `firmware/common/PhysicsWorld.h`，定点原语在 `firmware/common/fixed_q16.h`，两者都是 header-only：arduino-cli 不编译 `common/` 下的 `.cpp`，而类内定义天然 inline，草图与将来的主机 harness 都能直接 include。正式草图是 `firmware/Gewu/Gewu.ino`，`Hardware_Test` 仍然只做上电自检。Python 侧新增 `sim/particle/port_trace.py`，用同一批场景生成与固件同格式的 `TRACE` 行。

**动态块数。** 引擎不再有固定的 `n`：`blocks_` 只追加，删除只弹尾部，所以任何幸存块的下标都不变，`owner_[64]` 永远不需要重建或压缩，最新添加的块恒为 `blocks_[count-1]`。这条约束同时满足“删除最新添加的粒子”和“owner 表与块状态互为逆映射”两件事；换成 swap-remove 会同时破坏两者。

**两处 y 翻转，各只出现一次。** 引擎是 x 右、y 下、cy = 0 在顶部；固件逻辑坐标是 y 向上；屏幕系重力也是 y 向上。屏幕系 → 引擎的翻转写在 `PhysicsWorld::setGravityScreenQ16()`（重力翻 y）与 `setSpinScreenQ16()`（角速度翻 y、z；屏幕系 n 出屏、引擎 +z 入屏）里，引擎 → 逻辑的翻转写在 `Gewu.ino` 的 `renderWorld()` 里。除此之外任何地方都不许再出现 `-gy` 或 `7 - y`。

**实时法向压力是对原型的一处扩展。** 原型的 `gn/fdv` 只在初始化时算一次，`set_tilt()` 只转方向、不改大小。固件跟 IMU 走，平放时 `N ≈ G`、板面摩擦满额，竖直时 `N ≈ 0`、摩擦关闭，所以 `setGravityScreenQ16()` 每次设置都按 `N = sqrt(G² − g∥²)` 重算；`setTiltDeg()` 仍然保持原型语义（只改方向），专门留给逐位对照。C++ 里两条路分开，互不污染。

**默认参数下板面摩擦其实不生效。** `gravity = gravity_total = 0.0012`，而 `from_float(0.0012) = 79`，`79/65536 = 0.00120544 > 0.0012`，所以原型初始化时 `G² − g∥² < 0`，`gn = 0`、`fdv = 0`。§4.3 的阈值实验都是显式调小 `gravity` 或单独给 `gravity_total`，不是在裸默认参数下测的。固件的实时路径用的是 IMU 实测模长，平放时红豆模式 `G ≈ 774`（标度 0.0118）、`g∥ ≈ 0`、`fdv = 38`，两者行为不同；逐位对照必须显式构造重力向量，不能拿 `World2(Params())` 的默认输出当基准。

**静水压强补上水模式的最后一块。** 内聚力只让液-气界面收缩，它不传递竖直方向上的重量：一根 8 格高的水柱里，每个粒子都被下面一格挡住，左右两侧的内聚力又互相抵消，所以整根柱子是完全平衡的，竖着拿板子时它会一直立着。真实液体里这份重量就是压强 `p = ρg·h`，相邻水柱的水头差把水从高柱推向低柱；格点模型没有压力场，只能把这一项显式写出来。`Params.hydrostatic` 打开它（`h N` 现场调，N/100，默认 1.00）：每格沿真实重力反方向以半格步长做射线，找到最后一个还有水的采样点，再用射线穿过最后那格边界的位置把水头插值成连续值；随后对四邻域水头做中心差分，扣掉沿重力分量，只保留垂直分量作为横向加速度。重力方向不量化，力方向随板子连续转动；水头插值是为了避免射线跨格时水头跳半格。两侧都是自由面且水头相等时按「朝板心一侧倒」做确定性破缺——真实液体靠热涨落选方向，这里不引入随机数，trace 仍可复现。重力为零时整项恒为零，所以零重力液滴与 `v water` 的逐位基准都不变。回归实验是 `python sim/water/water.py column`：贴墙竖柱、板心竖柱、底行铺平、45° 对角柱四个场景，前两个必须塌、底行必须不动。

**逐位对照。** 固件的 `v plain|friction|spin [帧数]` 用独立的 `PhysicsWorld` 跑确定性场景，每帧打印 `stateHash`（FNV-1a-64，覆盖块数、每块的 `px py vx vy cx cy`）、mask、动能原始和、audit、接触计数。2026-10-17 在板上实测：`plain 240`、`friction 240`、`spin 600` 三组与 `sim/particle/port_trace.py` 的输出逐行完全相同（242 / 242 / 602 行，包含 `begin` 与 `END` 行）。这同时压过了 `mul` 的对称半值分支、`mul_sq`、`halve`、`fromFloat` 的半值取偶、`pen` 的稳定降序、跨格门、块-块/块-墙接触、板面摩擦和三个转动伪力。水模式另加 `v water`：零重力、居中 4×4、`cohesion = 0.0010`、`cohesion_diag = 0.5`、`cohesion_damping = 0.05`，240 帧与 `sim/water/port_trace.py` 逐行相同（242 行），覆盖两遍内聚求和、键轴阻尼与定点取整。静水压强在零重力下恒为零（`g∥ = 0`），所以这条 trace 不受影响；新项由 `sim/water/water.py column` 的四个场景覆盖。板上固件占 344364 B flash、18384 B RAM；`k 12000` 在 63 块满盘下跑了约 20.5 秒，折合每帧约 1.71 ms——那是 2 子步时代的读数，改成每帧 4 子步后按倍率估约 3.4 ms，离 16.7 ms 的实时预算仍有约 5 倍余量，板上实测待补。静水压强改成连续射线后每子步为每个水格建一张水头表（最多 24 个半格步），12 粒实测 `drops=0`；满盘的最坏路径按 64 格 × 24 步估约 0.3–0.5 ms/帧，仍远低于预算；2026-11-12 在满盘上实测并做了三项逐位等价的优化，实测比这个估算高一个数量级，优化后压强项 1.65 ms/帧，详见 §4.6。

**本版固件接了什么。** 编码器顺时针一格 → 随机空格添加一个粒子，逆时针一格 → 删除最新添加的粒子，按下后松开 → 清空全部粒子；容量 64。IMU 每 5 ms（200 Hz）同时更新一次重力与三轴角速度，加速度计量程 ±4 g、加速度计 DLPF 218 Hz；物理按 240 Hz 子步推进、每 4 个子步渲染一帧。子步不是参数，是时间尺度：重力标度不变时，子步率翻倍等于屏幕上的一切快一倍。红豆模式因此从约 6.5 倍慢放收到约 3.3 倍（只算子步：8 格自由落体从 0.53 秒缩到 0.26 秒；重力标度随后又提到 0.0118，最终约 1.9 倍慢放），而 `a_sim` 完全没动，所以堆叠稳定性、摩擦阈值、`vmax` 余量都不受影响——这是加子步而不是加重力的唯一理由。代价是满盘物理耗时翻倍（1.7 → 3.4 ms/帧），仍有约 5 倍实时余量；帧率仍是 60 Hz，`frame_hz` 由 `substepHz / substeps` 算出，两者一起改才不丢帧。`sim/world2.py` 与 `sim/water/water.py` 的默认也一起改成 4 子步 / 240 Hz，终端里跑仿真和板上看到的是同一个时间尺度，不用每次手敲 `--substeps 4`。唯一的例外是逐位基准：固件 `runTrace()` 用的 `traceWorld` 走 `PhysicsWorld::Params` 的默认值（仍是 2 / 120），两个 `port_trace.py` 也各自显式钉死 `substeps=2, substep_hz=120.0`，不跟随默认。改子步数时只要不动这两处，`v plain|friction|spin|water` 的逐位对照就一直成立。串口留了 `n / d / p x y / c / i / f / q / u / e / g / w / t / m / a / j / h / s / k / v` 与完整的增删、重力、转动、参数接口；其余编码器映射只有枚举与 switch。`feat/water` 分支默认进**水模式**：零摩擦、零恢复、静水压强 `h`（默认 1.00），内聚力 `a` 与键轴黏性 `j` 取很小的值（a 4 = 0.0004、j 4 = 0.04）：4 mm 格子上表面张力的毛细长度 2.7 mm、黏性边界层 0.2 mm，都不足一个像素，仿真里关掉内聚力后倾斜 30°、1.5 转/秒甩板、竖柱塌落的结果逐项相同；但低速流淌时水会散成单个格子，因为速度差让相邻块逐渐分离，而内聚力只在相邻时作用、分开就回不来。这组值是板上调出来的：a 3 还散，a 5 已经发滞，j 负责抹平相邻块的速度差且不影响静止液面。重力标度 0.0120、转速增益 200%（红豆模式的 2 倍；离心项按 ω² 长，所以水模式的离心实际是红豆的 4 倍）；`m particles` 切回红豆模式，`m water` 切回水，`m steel` 切钢珠（详见 §4.5）；SW2 后来改成只在水 ↔ 钢珠之间循环，红豆预设只留串口入口。切换保留现有粒子，只恢复该模式的默认参数，`g [1-999]` 与 `w [0-400]` 可临时改当前模式。红豆模式的手感初值按「颗粒材料」反推，不是按某一种实物标定：μ_p = 0.05、μ = 0.45、恢复系数 0.50、阻尼 0.9998、重力标度 0.0118。SW3 是演示用的慢速生成任务：松开时清空全部粒子并立刻补一颗，之后每 60 秒加一颗；SW3 再次松开、ENCSW 松开或编码器转过一格都会打断它（SW2 只切模式，不打断），`t N` 可在 1~3600 秒之间临时改周期。（后来按键语义改为：SW3 按住冻结、松开恢复，冻结不打断计时；计时模式改由 SW2 长按 2 秒触发，先让点阵外圈 28 颗闪约 120 ms，再清空、立刻补一颗、每 60 秒加一颗。）这组值的依据是「方块不滚」这个结构性缺失：板面 μ_p = 0.05 对应启滑倾角约 2.9°，比真实圆粒的 3~5° 略低，因为模型的方块不会滚，只能用很低的库仑系数去等效那个缺失的自由度；块间 μ = 0.45 按 tan 换回约 24° 的休止角，方块互锁比圆粒强，同样的 μ 会堆得更陡，0.45 是往回找的补偿；恢复系数 0.50 是观感甜点，低于 0.4 碰撞闷、高于 0.6 一堆粒子同时弹就变成噪点。阻尼 0.9998 在 240 Hz 下每秒剩约 95.3%，接近真实空气阻力（本可忽略），让碰撞与摩擦去承担耗散，水模式仍保留 0.9995 压内聚振铃。`f N` / `u N` 可以按百分之几现场改这两个系数，不用重烧；`PhysicsWorld::Params` 的默认值仍保持 0.35 / 0.55，那是与 Python 逐位对照用的，两边不要混成同一个默认值。重力标度初值取 0.0118（原型 0.0012），折合约 1.9 倍慢放，8 格自由落体约 0.15 秒；`g N` 按 N/10000 现场改。转速增益红豆模式保持 100%：IMU 给的是真实角速度，离心 ω²r 本来就应该和重力同尺度，重力提到实时附近之后两者的比例才是物理的；水模式仍取 200%，那是艺术夸张。摩擦的启滑倾角只由 μ 决定，改 G 不移动阈值，只让滑起来之后的加速度更大。

**IMU 响应速度与“抛起来”。** 20 Hz 采样时，一次十几毫秒的横向甩多半整个落在采样间隙里；即便被采到，也会被当成持续 50 ms 的恒定重力，冲量被量化为 50 ms 一格。现在采样是 5 ms，DLPF 从 44 Hz 提到 218 Hz，量程从 ±2 g 提到 ±4 g，有效冲量分辨率降到物理子步的 8.33 ms，短甩既不容易漏采，也不会被拉长。实测代价：两次 6 字节读加标定换算约 0.56 ms/次（最大 0.84 ms），200 Hz 下占单核约 11.2%；63 块满盘时每帧约 1.7 ms，子步预算 8.33 ms，`drops` 保持 0。热路径分两次读：加速度从 0x3B 起 6 字节，陀螺从 0x43 起 6 字节。温度夹在中间（0x41..0x42），一次 14 字节连续读会把温度也读回来，白占总线；两次 6 字节读的总线开销与 14 字节读接近（只多一组 START/STOP），但不碰温度。±4 g 让每 LSB 对应的 g 值翻倍，静止时重力分量的抖动仍在 1 个 Q16 LSB 量级（约 7.6 mg，折算角度约 0.4°），对玩具尺度没有可感影响。

**陀螺这一路怎么进内核。** 每 5 ms 读一次原始角速度，按 `(raw − GYRO_OFFSET) / 131` 换成模组系 dps；`rateInScreen()` 做 `ω_screen = (−ω_Y, −ω_X, −ω_Z)`，再经 `PhysicsWorld::setSpinScreenQ16()` 翻成引擎系（y、z 取负），最后换成内核要的 rad/子步与 rad/子步²。每轴先过 0.2 dps 死区：标定残差 ≤0.03 dps、静止噪声约 0.056 dps，0.2 dps 约 3.6σ，静止时三轴都归零，`substep()` 的旋转分支不启用，热路径没有额外定点开销。角加速度用相邻样本差分，`dt` 用 `micros()` 实测并夹在 2~20 ms，首拍、读失败与长间隔跳变都不差分；差分结果再过 25 ms 一阶低通，最后按 0.5 rad/s² 归零。0.056 dps 的噪声经差分约 0.28 rad/s²，低通后约 0.08 rad/s²，低于死区，所以静置时欧拉项不会让粒子抖。读失败连续约 15 ms 就 `stopSpin()`，不保留旧转速——否则粒子会继续受一个虚构的离心力。屏幕系三轴 ω 与 ω̇ 打在 `s` 的 `[STA]` 行里，方便按《标定.md》的三个符号预言验收；`w [0-400]` 是转速增益（百分数），`w 0` 等于停转。转动原点取实测的模块安装位置，存在 `BoardProfile.h` 的 `IMU_PIVOT_ENGINE_*`：逻辑格 (4,7) 的格心，换算成引擎连续坐标是 (4.5, 0.5)，不是默认的板心 (4, 4)。

**转动已经实时进来了，但“抛”仍然只有平面内一种。** 陀螺驱动的离心、科氏与欧拉项都落在板面内；引擎没有 z 自由度，竖向抛板时加速度计只改变 `G`（进而改变 `N` 与板面摩擦），平面内受力仍为零，粒子不会离板。这里说的“抛”一律指横向甩板；要让粒子真正飞离板面，得另加 z 状态、离板判定与落回弹跳，那是模型扩展，不在这一版。

**编码器方向已实测。** 本板正交查表的 `+1` 对应逆时针，所以 `Gewu.ino` 顶部的 `ENCODER_SIGN = -1`，顺时针才是添加、逆时针才是删除。方向只由这一个常量决定，不要改 `ENC_TABLE`；换编码器或对调 A/B 接线之后要重新确认。

### 4.5 钢珠模式参数

钢珠是水、红豆之后的第三组材料预设，不是新几何。内核的占据原语仍是一格一块，没有旋转自由度，也不引入球体或多格刚体；`PhysicsWorld.h` 只加了一个 `restitutionQ16()` getter 供串口回读，动力学路径一行没改。钢珠和水、红豆一样，屏幕上就是一个点亮像素，三者的差别全在参数。

**密度不进入自由落体。** Ø4 mm 的 GCr15 轴承钢球质量 0.262 g、转动惯量 4.19×10⁻¹⁰ kg·m²，但自由落体与质量无关；单材料世界里等质量碰撞的质量也整体约掉。所以钢珠不能用更大的重力标度来表达「重」——那只会让整个世界变快。钢珠的手感只能由低摩擦与高恢复系数表现。重力标度保持 0.0118，与红豆同一时间尺度，切模式时下落速度不变。

**重力标度的上限仍是 `vmax`。** 实时重力是 0.04258 格/子步²，8 格自由落体末速 0.826，超过 `vmax = 0.6`，会被夹断并破坏能量守恒。0.0118 下理论末速 0.4345，留 28% 余量；实测单颗落体峰值 0.3768、弹性台球 0.4415、1.5 转/秒甩板 0.2511，都没有触顶。

| 参数 | 钢珠 | 红豆 | 水 | 依据 |
|---|---:|---:|---:|---|
| `gravityPerG` | 0.0118 | 0.0118 | 0.0120 | 密度不影响自由落体；与红豆同一时间尺度 |
| `spinScale` | 100% | 100% | 200% | 真实角速度；低摩擦本身已经够夸张 |
| `plateFriction` μ_p | 0.003 | 0.05 | 0 | 滚动阻力系数 0.001~0.005，取中值；Q16 为 197 LSB |
| `pairFriction` μ | 0.15 | 0.45 | 0 | 干态钢-钢滑动 0.15~0.20，取低端；方块无滚动 |
| `restitution` e | 0.78 | 0.50 | 0 | 0.4 m/s 下钢-钢约 0.80，钢-硬质墙 0.6~0.7，折中 |
| `damping` | 0.9999 | 0.9998 | 0.9995 | 空气阻力时间常数约 69 s；65529/65536 约 74 s |
| `cohesion` | 0 | 0 | 0.0004 | 无内聚 |
| `cohesionDamping` | 0 | 0 | 0.04 | 无黏性 |
| `hydrostatic` | 0 | 0 | 1.0 | 无静水压强 |
| `vmax` | 0.6 | 0.6 | 0.6 | 共享；8 格落体仍有 28% 余量 |
| `restitutionSlop` | 0.004 | 0.004 | 0.004 | 3.84 mm/s，共享；防止低速抖动 |

**板面摩擦。** 滚动阻力系数的量级：轴承钢对轴承钢 0.001~0.002，对玻璃 0.002~0.004，对 PMMA / PCB 阻焊 0.003~0.005。虚拟板面按硬质光滑面取 0.003。它对应启滑倾角 `atan(0.003) = 0.172°`；逐 LSB 扫出来的实测阈值是 3 LSB、0.222°，与红豆 μ_p = 0.05 的 40 LSB、2.965° 形成两个数量级的差别。手持板子不可能稳到 0.2°，所以钢珠模式实际永远不会静止在斜面上，会一直往低处流。这是特性，不是缺陷。

**块间摩擦。** 干态、清洁的钢-钢滑动摩擦系数是 0.15~0.20，有氧化膜或潮湿时可到 0.3。模型里没有滚动，方块之间是纯滑动，所以取低端 0.15，等效圆球互相滚过对方的那部分自由度。0.15 折合休止角 8.5°，但方块互锁比圆球强，模型里的实际堆角会更高；红豆模式把物理上约 0.5~0.6 的摩擦压到 0.45，正是同一个补偿方向。**这是整组参数里最不确定的一项**，上板建议用 `u` 命令扫 0.10 / 0.15 / 0.20。

**恢复系数。** GCr15 对 GCr15 的 e 随撞击速度下降：0.1 m/s 时约 0.85~0.90，0.5 m/s 时约 0.78~0.82。本世界的撞击速度上限是 `vmax` 对应的 0.576 m/s，所以钢-钢按 0.80 取是合理的；但模型只有一个 e，同时管块-块和块-墙，钢对 PMMA / FR4 只有 0.6~0.7，于是折中取 0.78。数值验证：从第 7 行自由落体，e = 0.78 的第一次回弹高度应为 `e² × 7 = 4.26` 格，实测回到第 3 行、离底 4 格；e = 0.90 的理论回弹 5.67 格，实测 5 格，但速度反号 16 次，底部会出现大量一两帧的小弹跳。这就是不取 0.90 的理由。台面可用 `e [0-100]` 在 0.70~0.82 之间扫。

**阻尼。** Ø4 mm 钢珠在空气中 0.5 m/s 时雷诺数约 130，阻力约 1.9×10⁻⁶ N，减速度约 7.2×10⁻³ m/s²，速度时间常数约 69 s。0.9999 每子步损失 7 LSB，时间常数约 39.0 s 仿真时间，乘 1.90 倍慢放是 74 s 真实时间，与 69 s 相差约 7%，是 Q16.16 能表示的最近档位。0.9998 会把阻力放大一倍，对钢珠过阻尼。

**内聚与静水压强全零。** 钢珠之间没有表面张力，也没有液体「重量变横向推力」的静水压强。这三个量为零时，内核里整段内聚与压强代码被跳过，每子步开销与红豆模式相同。

**台面实验。** `sim/steel/steel.py` 提供六支命令：`drop` 单颗落体与回弹、`pile` 落堆、`plate` 板面启滑阈值、`bounce` 扫恢复系数、`tilt` 斜板流动（钢珠对红豆）、`show` 终端播放。默认的 `tilt` 用 2° 板面、屏幕内重力转 30°：钢珠从左下角流到右下角（质心 x 从 1.50 到 5.42），红豆原地不动（质心不变）。这是两种材料最直观的差别。镜像对称残差 0 格，所有场景 `audit = 0`。

**局限。** 8×8 的封闭盒子放不下真正的休止角：落堆最终总是填满底部若干整行，钢珠和红豆在这一项上没有可见差别。仿真只能验证不变量、速度余量与反弹衰减，堆角和流动感只能上板看；这与红豆当年「a 3 还散、a 5 发滞」的调法一致。另外 60 Hz 渲染下钢珠速度快，单个像素在帧间跳跃会比红豆明显；这是帧率问题，不是参数错。**这一条已被 §4.6 的屈服门部分推翻**：自由料堆现在有材料差别，只有被侧向围住的满堆仍然填满整行。

**固件接口。** `SimMode` 增加 `MODE_STEEL`，SW2 在松开时按 水 → 红豆 → 钢珠 → 水 循环，`m steel` 直接切换；切换保留现有粒子，只恢复该模式默认参数。**按键循环后来改成 水 ↔ 钢珠**：红豆预设移出按键路径，只能 `m particles` 切入，从红豆按 SW2 回到水；`SimMode` 枚举与 `m` 的三值校验不变。串口新增 `q [0-999]`（板面摩擦，千分之一；钢珠的 0.003 低于 `f` 的 0.01 步长，必须用 `q`）与 `e [0-100]`（恢复系数，百分数）。`s` 的状态行把 `mup` 的显示精度从两位小数提到四位，并补了 `e`。本次编译占 345520 B flash、18384 B RAM；多出来的主要是三模式的分支、帮助文本与两条新命令。按键语义后来又改了一次：SW3 按住冻结/松开恢复，计时模式改由 SW2 长按 2 秒触发（外圈闪 120 ms 后清空并补一颗），本次编译 348330 B flash、18448 B RAM。

### 4.6 颗粒屈服门与自由竖列失稳

**问题。** §4.5 记的「8×8 放不下真正的休止角」在竖列上有个更刺眼的表现：三颗钢珠在竖直板上排成 `(0,0)(0,1)(0,2)` 会永远立着。现实里它一定塌。原因不是摩擦不够——板面静摩擦在竖直时 `N = 0`，块间静摩擦在完全对齐的竖列里横向相对速度恒为零，没有东西可作用；原因是方格把接触面做成了整条格边，方块竖着码起来就是砖垛，静力上真的稳定。完全对齐的钢珠竖列在现实中也是不稳定平衡，稳定盆地半宽约 0.15 格（μ = 0.15），而引擎每次都在格心生成，恰好落在盆地中心。

**纯压强为什么不行。** 把 §4.4 的静水压强直接开到钢珠/红豆上，竖列确实会塌（增益 0.01 就能在自由落体过程中把它拆开），但料堆也一起塌：4×4 料堆在 0.02 下约 100 s 仿真内摊成两层，0.05 下 80 s，0.1 下 40 s，而且不会停在某个休止角——它是水机制，自由面永远被往外推。一个参数同时要「竖列塌得快」和「料堆不摊平」，无解。

**屈服门。** 新增 `Params.yield_mu`（Python 与 C++ 同名）。`yield_mu = 0` 是原来的纯压强路径，水模式逐位不变；`> 0` 时在压强项上加一道 Mohr–Coulomb 门：

- 自由竖列：两侧都没有相邻料块（墙不算侧向支撑）→ 没有侧向围压，阈值恒为零，照推。
- 有侧向支撑的块：只有在侧向水头坡度的模长 `hypot(tx, ty)` 超过 `μ·own` 时才推，否则保持不动。
- `own = 0` 的自由面直接跳过——那里没有竖向载荷，也不该由压强把它推走。

同一增益下，μ 小的钢珠停得更平，μ 大的红豆停得更陡：4×4 料堆在增益 0.10/0.15 下，钢珠是 `8-7-1`（底部两层，右翼拟合 12.1°），红豆是 `7-6-3`（三层锯齿丘，21.4°）。物理参考是 `arctan(0.15) = 8.5°` 与 `arctan(0.45) = 24.2°`：方向与量级对，模型把范围压窄了。4×8 满堆仍然保持 8-8-8-8 不动——完全被侧向包围，门不会误触发。

**参数与实验。** `sim/steel/granular.py` 提供 `column / pile / mirror / budget / all` 五支命令，默认增益 0.10。竖列坍塌（0.10）：钢珠 2 颗 0.93 s、3 颗 0.18 s；红豆 2 颗 1.62 s、3 颗 0.50 s（0.15 下分别为 0.37/0.12 与 1.02/0.30 s）。增益 0.05~0.15 区间两种材料的堆形分离稳健；0.20 开始两边都往平走。镜像转置检验除恰好 45°（§4.1 的轴序平局）外残差 0.0000，所有场景 `audit = 0`，|v| 峰值 0.3289（`vmax` 的 55%）。定点开销：4×8 满堆、同一初态、一个子步，钢珠 2040 → 1313 ops、红豆 2200 → 1473 ops，新增的 24 次 `hypot` 被跳过自由面/未屈服块的乘加抵掉，净开销是负的。

**固件接口。** `Params` 增加 `yieldMu`（默认 0，逐位基准不动），`PhysicsWorld` 增加 `setYieldMuFloat()` / `yieldMu()`，`pressureAccel()` 按 Python 的同一顺序预计算侧向偏移。`SimMode` 的预设：水 `hydrostatic = 1.0, yieldMu = 0`；钢珠 `0.15 / 0.15`；红豆 `0.15 / 0.45`。串口新增 `y [0-999]`（千分之一）现场改屈服 μ，`s` 的状态行补了 `yield=`。`m` 切换恢复该模式默认。本次编译 347086 B flash、18416 B RAM；`v plain|friction|spin|water` 四组与 Python 逐行相同（242 / 242 / 602 / 242 行）。

**压强路径与屈服门的逐位覆盖（`v hydro` / `v hydrod` / `v grain` / `v graind`）。** 在此之前没有任何 trace 覆盖静水压强：`v plain|friction|spin` 的 `hydrostatic` 是 0，`v water` 是零重力，`g∥ = 0` 时压强整项关闭。补四条，共用同一个 19 块初态（左下 4×3 贴墙块 + 中下 2 格 + 右侧 4 格竖列 + 右上 1 格）、零摩擦、零恢复、零内聚、`hydrostatic = 1.0`，只差重力向量与屈服 μ：`hydro` / `grain` 用竖直重力 (0, 79)，`hydrod` / `graind` 用 (40, 66) 约 31°；`hydro` 与 `hydrod` 的 `yield_mu = 0`（纯压强路径），`grain` 与 `graind` 的 `yield_mu = 0.45`（红豆预设）。竖直组覆盖对称简并、贴墙、自由面 `own = 0` 与逐块侧向搜索；斜向组覆盖射线同时跨 x、y 边界的 min-f 插值与对角侧向偏移。屈服门各分支在 240 帧里的命中计数：`grain` 自由竖列 129 次、被门挡住 2927 次、`own = 0` 早退 3824 次；`graind` 自由竖列 776 次、被门挡住 3232 次（斜向重力下 `own` 一次都没有为 0，阈值比较被压得最重）。μ 取 0.45 而不是 0.15，是因为 0.15 在斜向场景里只挡 116 次，几乎不触发。期望由 `sim/water/port_trace_hydro.py` 生成，四条 240 帧都是 242 行。**新 trace 立刻抓到一处一直存在的分叉**：`pressureAccel()` 的水路径（`yieldMu = 0`）在对称简并分支里按 `COHESION_OFFSETS` 的顺序搜侧向偏移，而 Python 的 `_lateral_pair()` 用的是 `(1,0)(-1,0)(0,1)(0,-1)(1,1)(1,-1)(-1,1)(-1,-1)`；竖直重力下 `dot` 只由 `dx` 决定，`(±1,0)` 与 `(±1,±1)` 全部同分，并列时取哪一个完全由扫描顺序决定，于是第一帧就分叉。C++ 改用 `LATERAL_OFFSETS`（与 Python 同序）后四条逐行相同；原有四条 `plain / friction / spin / water` 不受影响（都不开压强），复测仍是 242 / 242 / 602 / 242 行。本次编译 347572 B flash、18416 B RAM。

**压强的开销与三项优化。** 成本分两块：每子步重建的全场水头表（每块最多 24 个半格步）与逐块梯度。优化前 4×8 平放、钢珠、一个子步的定点计数是水头表 599、逐块 264、整子步 1401；水模式（`yield_mu = 0`）逐块 1016、整子步 4375。逐块那一半里最贵的是对称简并分支：每块都重搜一遍与重力垂直的偏移对（8 个偏移 × 2 次 `fromFloat` + 2 次 `mul`），而这个偏移对只依赖重力方向、全场相同，32 块就是 32 次完全相同的搜索。三项改动全部逐位等价：

- 偏移对提到 `updatePressure()` 每子步算一次，水路径只查表：水模式逐块 1016 → 440 ops，整子步 4375 → 3824（−12.6%）
- `fromFloat()` 的整数参数改直接乘 `ONE`：水头表每块 3~5 次、偏移对每子步 16 次，都是整数到 Q16.16 的精确换算；每子步省掉 144~272 次软浮点（C3 上每次约 100~200 周期，定点计数器看不到这一项）
- 屈服门的 `hypot(tx, ty) ≤ μ·own` 换成 `tx² + ty² < (μ·own + 1)²`（`isqrt(n) ≤ T ⟺ n < (T+1)²`）：4×8 逐块 264 → 240、8×8 616 → 560，每子步省 24~56 次 32 轮开方

板上实测（`m steel`、`k 2000`、h 0.15 对 h 0，单位 ms/帧）：32 块静置 7.230 / 4.079 → 4.616~4.861 / 4.055~4.141，压强项 3.151 → 0.56~0.72（占 43.6% → 12%~15%）；满盘 64 块 15.991 / 8.600 → 9.985 / 8.334，压强项 7.391 → 1.651（46.2% → 16.5%）。压强项快约 4.5 倍，满盘整帧 15.99 → 9.99 ms，从贴着 16.7 ms 实时预算回到 40% 余量。八条 trace 与 Python 逐行相同，`granular.py column` 的坍塌时间不变，编译 347098 B flash（−474 B）、18416 B RAM。§4.4 里「满盘最坏路径 0.3–0.5 ms/帧」是改连续射线时的估算，实测高了一个数量级——以本节实测为准。

**局限。** 台阶间距只能取 `arctan(1/n)`，不是连续角度；8×8 的堆太小，角度只能粗估，且 μ 在 ±0.05 内常常改不动形状（格点和料量先钉死了）。2 宽的高墙会被当作有侧向支撑而不塌——规则把「一侧有邻居」当作「坐在谷里」，这是方格里对六方堆积的替身。`μ·own` 里的 `own` 是法向力的代理，§5.5 的法向力偏小意味着有效 μ 只能上板标定。滚动自由度仍然没有。

---

## 五、代价

必须说清这个方案放弃了两样东西：

1. **放弃了"碰撞体是圆"**。方块不会滚动。对一个 8×8 的像素玩具，方块反而更贴题——但这是审美判断
2. **放弃了"连续位置 = 几何质心"这个语义**。相位是"何时请求穿越"的累积量，不是能当几何坐标画在图上的质心。静止时相位会被钉在格边上

另外两条实现性质：

3. **有顺序相关性**：两块争抢同一个空格时谁赢由处理顺序决定。实测两种顺序都不影响正确性，只影响观感
4. **强滞后**：倾角扫过去再扫回来，同一倾角下堆形不同，取决于历史。这是颗粒材料的真实性质，但也意味着斜坡不像流沙那样可复现。**未验证，需实测判断是否影响手感**。§4.3 的静摩擦补上之后，滞后又多了一个来源：启滑阈值在扫回来时不会原路返回，这是真正的静摩擦回线，和堵塞造成的滞后叠加在一起
5. **堆叠内部的正常力偏小**（结构性，残余已量化，手感未量化）：接触不是持续约束，而是跨格事件；每块每轴每子步只有一次门处理，一次扫描只解一遍，不迭代到收敛。上面那块每子步获得的 `g·dt` 要沿堆高逐层传下来，冲量最多传一格/子步。实测竖直柱（底端贴墙、重力向下、600 帧后、g = 0.0012）：

   | 深度 | 1 | 2 | 3 | 4 | 5 | 6 | 7 | 8 |
   |---|---|---|---|---|---|---|---|---|
   | 稳态最大 \|vy\| | 0.00000 | 0.00241 | 0.00404 | 0.00687 | 0.01109 | 0.01614 | 0.02202 | 0.02834 |

   这是极限环不是发散：位置被格边夹住，速度有界。8 层柱是 23.6 倍 `g`，但只占 `vmax` 的 4.7%；显示上看不出来，因为格号不变、相位被钉住。

   **"多扫几次"不是便宜的修法。** 一维链、理想顺序（从墙往上）、`e = 0`、无热启动，把初速压到 10% 所需扫描次数：深度 2 是 4 次，3 是 9 次，4 是 15 次，8 是 63 次，大致按 k² 增长。8 层柱要 63 次才能压到 10%，每子步只加 2~4 次几乎无用。要真正收敛，得改成持久接触表、累积法向/切向冲量、热启动，并处理恢复系数不能逐轮重复施加、摩擦上限要用累积冲量这两个坑——那是换一层求解器，不是加一个循环。

   **顺序相关性**：同一物理初态、只把块的编号反序，三块贴墙一列在单子步后是 `[0.1, 0.1, 0.0]` 与 `[0.05, 0.075, 0.075]`。`gate_order = "pen"` 按离格心的曼哈顿距离降序排，把 12 块堆积的 400 帧最大位置差从 0.259 格压到 0.095 格，但它只是缓解：对称堆形里键值并列，稳定排序退回块号序，而且它不知道重力朝哪，选不出支撑端优先的理想顺序。

   **另一条独立的管线问题**：墙与块-块摩擦在位置积分**之后**施加。实测单块靠在竖直板底边、板倾斜 10°（理论阈值 `atan(0.55) = 28.8°`）时没有滑动，但每子步爬 `g·sinθ`，1200 帧爬了 0.6 格，采样点上的速度恰好被清零。这是先积分后摩擦的离散误差，和接触求解器无关；只修求解器不会消掉它，要一起修就得把接触求解移到积分之前。

   **初步探测**：同样竖直、关掉板面摩擦，8 层柱在 10° 已剪切/平移 3 格以上，单块只是爬行。这个实验混着爬行与滑移，不能当干净阈值用；分离两者的测量见第六节第 7 条
6. **恰好 45° 的轴序平局**：按速度分量决定先过哪个轴，在 `|vx| = |vy|` 时只能退回固定的先 x，于是恰好 45° 上镜像残差不为零（0.20 格）。这是测度零的——实际倾角不会精确停在 45.000°，而且只有 μ = 0.55 的初始条件下才出现

**没有放弃的**：连续速度、连续重力方向（任意角度直接作用于速度向量，不经过任何方向量化）。前提 6 和 7 都保住了。

如果坚持"位置必须是真正的几何质心、可以跨格、位置就是能直接画在屏幕上的坐标"，那么**必须放弃强保证**，只能回到事后投影或事后匹配，而那两条路只能是弱的或廉价的。这是一条真正的二选一，但它不是"位置 vs 重力"，而是**"位置必须是几何量 vs 强保证"**。

---

## 六、下一步

1. ~~把原型落进 `sim/`，原实现保留作基线，加 `--engine` 开关~~ —— 已完成。`sim/particle/run.py --engine v1|v2`，两个引擎共用 `sim/spawn.py` 的摆位，同一个 `--scene` 给出同一份初始格号
2. ~~写统一评测脚本，重点是动能守恒残差~~ —— 已完成。`sim/particle/eval.py invariant|kinetic|ops`
3. ~~补各向异性扫描（见附录 C）~~ —— 已完成。`sim/particle/aniso.py`，结论见 §4.1
4. ~~转动项：离心、科氏、欧拉，任意转轴~~ —— 已完成。`sim/particle/rot.py`，结论见 §4.2。平放转板、四角聚团已经是模型的直接推论；绕板面内的轴转会把料推离该轴
5. ~~板面静摩擦~~ —— 已完成。`sim/particle/eval.py plate`，结论见 §4.3。法向压力由 `N = sqrt(G² − g∥²)` 给出；平放低速转板时确实一块都不动，临界转速与 `sqrt(μ_p·N/r)` 对得上
6. 实测滞后对手感的影响，决定是否接受——静摩擦给了它一条可测的真回线
7. 验证堆叠内部正常力偏小这一条（见第五节第 5 条）——它决定斜坡上的阈值滑移有多大。初步探测已做（竖直板、8 层柱在 10° 就剪切），但混着摩擦爬行，不能当阈值；干净实验要测稳态滑移速率而不是累计位移，把爬行与真实滑移分开。如果 3~4 层就开始明显提前滑动，值得开 v3；只有 6 层以上才偏，就在文档里承认它
8. ~~定下方案后再移植到 C++~~ —— 已完成。内核在 `firmware/common/fixed_q16.h` 与 `firmware/common/PhysicsWorld.h`，正式草图在 `firmware/Gewu/`；`mul` 的半值取整改成了对称分支，`hypot` 补了 64 位 isqrt，`div` 走 64 位中间量。与原来这条计划唯一的偏差是法向压力：固件跟 IMU 走，`N` 不能只在初始化时算一次，改成每次重力更新重算（见 §4.4）。逐位对照用 `sim/particle/port_trace.py` 与板上 `v` 命令，三组场景 240 / 240 / 600 帧全部一致

---

## 附录 A · 候选方案评估

| 方案 | 做法 | 要求 4 | 要求 5 | 备注 |
|---|---|---|---|---|
| T1 加强修补层 | 修 sleep、修 2-循环、加全局匹配兜底 | **弱**（0.01~0.11% 帧） | **弱** | 终态可靠兜底保证，中途不保证；成本最高 |
| T2 格子锚定 | 格号成为状态不变量，跨格是事件 | 强（构造性） | 强 | 验证 12 万帧 0 违反 |
| T3 物理与显示解耦 | 物理纯牛顿，渲染层做最小代价匹配 | 强（但廉价） | 强 | 物理保真度弱，像素可能跨屏跳 |
| T4 格号 + 连续速度 | 压掉相位，位置即格号 | 强 | 强 | T2 的严格子集，只是省两个定点变量 |
| T5 D2Q9 格子玻尔兹曼 | 正确二维格子气 | 强 | 强 | 计算量远超玩具所需 |
| 纯牛顿（不做占用约束） | 圆盘硬球，无视格子 | **弱**（0.01~0.07% 帧） | **弱** | 圆盘可斜对角共处一格 |

**只有 T1 和「纯牛顿」给弱保证。** T1 的弱来自"事后修补不收敛"，纯牛顿的弱来自"圆盘与格子形状不一致"——两者是同一个几何问题的两面。

**T3 为什么是"廉价地强"**：它把"两个像素不会同时亮"变成纯渲染层的簿记事实，跟物理没有关系。它严格满足了**字面**要求 5，却绕过了**本意**——物块就是那个像素。一旦渲染层靠匹配指认像素，物块和像素就不是同一个东西了，拥挤时身份可以互换、像素可以跨屏跳。技术上可行，但用物理保真度换了字面满足。

**T4 为什么降级**：它给强保证也不违反任何硬性要求，但相对 T2 是严格劣的——T2 的相位累加器就是它的内部实现。留着只作"如果 C3 预算实在不够"的后备。

**T5 为什么不做**：见 2.1。

---

## 附录 B · 被否掉的思路

每条都写了理由，为的是下次重走之前能先看到它已经被试过。

**把参数调好（让 tilt 80 好看一点）** —— 帧级错误率在任何参数下都不为零。而且 2-循环是复合映射的性质，与参数无关：换参数只是把周期轨挪到别处或拉长周期。实测把静止阈值调到最优后仍有 0.01~0.09% 的帧出错。

**只修静止判定阈值** —— 必要但不充分。把一个严重卡死（0.11%）降到 0.01~0.09%，离"始终"还差得远。它是机制层的修复，碰不到表征层。

**只修修补函数的 2-循环（加访问标记或换方向）** —— 局部规则无论怎么改，都只是把周期轨推向更长的周期。在没有全局可行性判据的前提下**无法证明**它收敛，只能测；而"测不出来"不等于"不存在"。要走这条路就必须连同全局兜底一起做，那就回到 T1，成本更高、保证更弱。

**提高子步频率 / 减小 dt** —— 穿隧确实能靠这个解决，但 2-循环不是时间步的问题：它是**同一时刻**的离散冲突，加细时间步只会让它每帧触发更多次。

**删掉占用约束，用纯牛顿** —— 实测自己在 tilt 30 和 tilt 80 各有 0.07% 的帧出错。原因正是 2.2 节那条证明：圆盘可以斜对角共处一格。删掉修补层只是把"修补造成的错误"换成"几何造成的错误"，量级还差不多。

**恢复系数调到 0 并关掉静止判定，靠纯耗散收敛** —— 实测 tilt 80 反而升到 0.24%，比原参数还差。有接触的堆叠需要一点弹性才能重新排列，完全非弹性会锁死。

**保留圆盘碰撞但写个更聪明的修补** —— 几何层不允许。只要碰撞体和占据体形状不同，就必然存在"硬球满意而占用不满意"和反过来的状态，修补层就得在两者之间选一个牺牲。这个牺牲就是能量损失和瞬移的来源。

**隐藏格（每个对象保留"真实位置"和"显示位置"两套）** —— 等价于 T3，理由见附录 A。

**格子气 / 元胞自动机** —— 见 2.1。各向异性无法通过调参消除，这是 HPP 模型 1973 年就被证明的结果。

**把重力方向量化成 8 或 16 个方向以换取更简单的碰撞** —— 它给出的强保证是假的强：保证来自量化本身，代价是倾斜时"跳着翻面"，等于用一个可见缺陷换一个不可见缺陷。

---

## 附录 C · 判别实验设计

这些实验还没跑，写下来是为了将来跑的时候不用重新设计。

**轨迹**（每条 3000 帧，40 个 seed）：

- `hold`：固定倾角，逐个取 0/15/30/45/60/75/80/85/90/105/135/180
- `slow`：0 → 180 → 0，周期 600 帧（准静态，测滞后）
- `fast`：0 → 180 → 0，周期 60 帧（测跟不上时会不会破不变量）
- `flip`：在 89°/91° 和 179°/181° 附近来回抖（测边界翻转）
- `random`：连续随机游走倾角（测最恶劣的连续扰动）

**指标**（前两个是判定性的）：

1. **逐帧点亮数正确率**。判定标准只有一条：**是否为 100.000%**。任何非 100% 就是弱保证，不接受"很少"
2. **不变量自检的累计违反数**。必须是**独立于引擎**的检查函数——直接扫所有块的格号求重复数，不要用引擎自己的计数器
3. **动能守恒残差**。无重力时从同一初态跑，看总动能随时间的变化。修补层会在每次瞬移时把切向速度清零，这个指标会明显掉；格子锚定只在真实接触处按库仑摩擦耗散，残差应当小一个数量级
4. **滞后回线面积**：`slow` 轨迹下，倾角上扫与下扫的质心之差对倾角积分。质心要用**格号**算，不要用连续相位算，否则会把相位钉边误读成位移
5. **每帧定点运算数**：给 `fixed.py` 的各个运算加计数器直接读。C3 的预算要靠这个数字对表

**各向异性专项**（这是否掉格子气的原始理由，必须验）：重力方向从 0° 以 1° 步长扫到 90°，每个角度跑到静止，记录堆料质心。若曲线在 45° 附近出现台阶，就是仍然各向异性。

**判定技巧**：格子锚定方案 0~90° 的质心曲线应当是平滑的，唯一的跳变可能在 75° 附近——那是堆料从"贴侧墙"翻到"贴顶墙"的雪崩。要区分它是**真实的颗粒阈值行为**还是**量化假象**，把摩擦系数调大重跑：真实的雪崩阈值会随摩擦移动，量化假象不会。

---

## 附录 D · 复现与产出物

**复现命令**：失败的配置是 `python sim/particle/run.py --engine v1 --tilt 80 --n 6 --seed 5`（默认 `seed=1` 不复现，0 次触发）。新内核用 `--engine v2` 跑同一串参数。

**产出物**：`sim/` 下的公共层——`fixed.py`（定点原语）、`spawn.py`（统一摆位）、`world2.py`（格子锚定内核）、`checker.py`（独立检查）；`sim/particle/` 下的粒子内核脚本——`world.py`（基线）、`eval.py`（评测套件）、`aniso.py`（各向异性扫描）、`rot.py`（转动与镜像检验）、`run.py`（终端演示，`--scene center --spin-rps` 就是转板聚角的直接演示）、`port_trace.py`（与固件 `v` 命令逐行对照的确定性 trace）；`firmware/common/fixed_q16.h` 与 `firmware/common/PhysicsWorld.h`（C++ 逐位移植），`firmware/Gewu/Gewu.ino`（正式固件：编码器增删粒子 + IMU 实时重力与三轴角速度）。材料预设的产出物另见 `sim/water/water.py` 与 `sim/steel/steel.py`（钢珠的参数推导见 §4.5）。早期在 `%TEMP%\simlab\` 里的 `run2.py` 与十个诊断脚本已被系统清理——**文档是持久的，临时目录里的东西是易失的**，这也是把验证落进仓库的理由。

---

## 附：与 README「待定」的关系

README 的待定第一条是"物理模型的粒度——纯元胞自动机还是允许亚像素位置后量化"。本文给出的答案不是这两者中的任何一个：**位置保持连续，但"占用"是状态的一部分而非事后检查**。粒度问题在物块模式下就此结案。

水模式已按「同一内核 + 显式界面项」落地：零摩擦、零恢复，静水压强 `h` 把竖直重量变成横向推力，负责竖柱塌落与液面找平；八邻域内聚 `a` 与键轴黏性 `j` 默认取很小的一组（a 4 / j 4）——`h` 单独就能撑起宏观的水行为，内聚与黏性只负责低速流淌时不散成单个格子；`a` 再大就会发滞。壁面虚拟格与接触线力留在原型里，固件暂未启用。早期担心「5~20 个牛顿分子是稀薄气体不是水」，实际做下来，观感靠的是内聚 + 压强这两条显式规则，而不是分子动力学的涌现——规则仍然作用在牛顿粒子上，没有另起一套元胞更新，共用同一个格子锚定内核、数据结构与渲染层。
