konamivrc6/Gewu/标定.md

# 标定

这份文档管的是「接线全对、固件也跑得起来，但读数需要修正」的那些量。接线故障查 [`硬件接线.md`](硬件接线.md)，构建与烧录查 [`README.md`](README.md)，本文只记：哪些量需要标、判据是什么、标到哪一步、结论往哪放。

这一轮工作在 `feat/calib` 上完成。标定的产物是**常数**，不是散文——每一项最终要么落到固件里的常数表，要么明确判定「不需要标」。

---

## 当前状态

仓库里有**两块实机**。第一块 2026-10-17 完成标定，常数已归档到 `firmware/common/BoardProfile.h.20261017`（不参与编译）；第二块 2026-10-21 完成标定，常数在现行的 `firmware/common/BoardProfile.h`。下表不特别注明的是两板共用的设计层结论；**逐板不同的量（加速度计六个、陀螺三个）在第二、三节分板列出**。

| 项目 | 器件 | 状态 | 结论去处 |
|---|---|---|---|
| 编码器每格折合的正交跳变数 | EC11 | **已验，固件现值正确** | 不改，`ENC_STEPS_PER_DETENT = 4` |
| 编码器旋向与 `dir` 符号的对应 | EC11 | **已测** | 见下文；固件如需取反再改 |
| 加速度计零点与增益 | MPU6500 | **两块板都已标定**（见第二节） | 现行 `BoardProfile.h`（第二块板）；第一块的归档在 `BoardProfile.h.20261017` |
| 加速度计安装朝向 → 屏幕坐标 | MPU6500 | **已测，已落地**（见第五节） | 固件里的 `gravityInScreen()` 与 `g` 模式 |
| 陀螺零偏 | MPU6500 | **两块板都已标定**（见第三节） | 现行 `BoardProfile.h`（第二块板）；第一块的归档在 `BoardProfile.h.20261017` |
| 陀螺标度因子 | MPU6500 | **不标**（见第三节末） | 只在将来要积分求角时才需要考虑 |
| 陀螺轴 → 屏幕坐标 | MPU6500 | **已测，已落地**（见第五节末） | 固件里的 `rateInScreen()` |
| 温度换算 | MPU6500 | 未校，仅按型号选公式 | 本项目不标（见第四节） |
| 点阵屏行列走向 | MAX7219 | **已确认，`FC16_HW` 正确** | 不改，`MX_HW_TYPE` |
| 点阵屏朝向 | MAX7219 | **已确认，`MX_ROTATION = 0` 正确** | 不改；逻辑坐标随之定为数学系 `(x, y)` |
| 点阵屏亮度分档 | MAX7219 | 未实测，可运行时试 | 使用时的常数（`i` 命令） |

---

## 前提：固件里与标定相关的配置

标定结果只在下列配置下成立。**动量程时零点与增益要按比例换算，改采样率或 DLPF 会改噪声带宽**；除此之外任何一项变动都意味着这台板子的结论变了。

这些量现在集中在 `firmware/common/BoardProfile.h`（只有「上电初值」那几条留在 `.ino` 的可调参数里）。分开放不是为了整理文件：那一份头文件只存**实测结论与标定成立的前提**，所以任何一条被改动都只可能意味着「这台板子的结论变了」，而不可能是「我想调个参数」。

| 项 | 现值 | 含义 |
|---|---|---|
| I2C 地址 | `0x68` | AD0 接地 |
| I2C 速率 | 400 kHz | 4.7k 上拉下合规 |
| `SMPLRT_DIV` | `0x04` | 陀螺输出 1 kHz ÷ 5 = **200 Hz** 采样 |
| `CONFIG` (0x1A) | `0x03` | 陀螺 DLPF 44 Hz 档 |
| `ACCEL_CONFIG2` (0x1D) | `0x01` | 加速度计 DLPF 218 Hz 档，**仅 MPU6500 有**。原来是 44 Hz，会削掉手甩的短脉冲 |
| `AFS_SEL` | `0x08` | **±4 g，8192 LSB/g**。量程与标定值的关系见下一条说明 |
| `FS_SEL` | `0x00` | **±250 dps，131 LSB/dps** |
| 温度公式 | `raw / 333.87 + 21.0`（6500）、`raw / 340.0 + 36.53`（6050） | 两条差约 15 °C 且都不报错 |
| 点阵硬件档案 | `FC16_HW`，`MX_ROTATION = 0`，`MX_DEVICES = 1` | 已实机验过（见六节）。逻辑坐标约定：数学系，原点左下，`x` 右、`y` 上 |
| 点阵初始化 | `SCANLIMIT = 7`、`DECODE` 关、`INTENSITY = 0` | 亮度 0 是最暗档（1/32 占空比），不是关屏。这是**上电初值**，`i` 命令能临时改，复位后回到这里 |
| 跑马灯周期 | `CHASE_MS = 60` | 同样是上电初值，`m` 命令能临时改，复位后回到这里 |

**量程与标定值。** `ACCEL_GAIN` / `ACCEL_OFFSET` 是 ±2 g 量程下实测的。固件现在跑 ±4 g，读取时用 `IMU_ACCEL_SCALE = 8192 / 16384 = 0.5` 同时缩放零点与增益：同一物理加速度在 ±4 g 下产生的 raw 计数正好减半，零点也减半，这是 ADC 的线性缩放，不是重新标定。代价只有一个：每 LSB 对应的 g 值翻倍，折算到 g 的噪声也跟着翻倍。DLPF 从 44 Hz 改到 218 Hz 只改噪声带宽；零点是多秒平均测的，均值不受影响，九个常数继续有效。**第二块板（2026-10-21）例外：它是在 ±4 g 下直接测的**，不经过这条换算，见第二节末。

台面侧的脚本在 `tools/` 下：`serial_send.py` 逐条发串口命令，`imu_stat.py` 抓一段数据做静止统计，`accel_calib.py` 做六面标定。原始采样日志与姿态数据留在 `%TEMP%`，不进仓库——T: 只有 1.3 GB，而且日志不是结论，本文只抄结论与判据。

---

## 一、编码器（已完成）

### 每格折几个正交跳变

**方法**：复位板子等开机横幅，开 90 秒记录窗口，手转**5 格**（每格卡位停一下），事后把 `[ENC]` 行按时间间隔切成段统计。

**结果**：5 格 → 5 行 `dir` 事件，`detent` 每行只动 1，相邻间隔 1.43~1.65 s，离散度不到 15%——正是「一格一停」该有的样子。固件里 `ENC_STEPS_PER_DETENT = 4`，满 4 个正交跳变才报一行，即「一格一行」，两侧对上，**现值正确，不用改**。

窗口里既没有幽灵事件（去抖与上拉这条链干净），也没有漏格。快拨时约 4.75 ms 一个跳变，与 19 ms 的相邻间隔对得上，不是触点抖动被误判成两格。

### 旋向与符号

**顺时针 → `dir = −1`；逆时针 → `dir = +1`**（实测所得）。

这个符号由 A、B 两相接在哪两个 GPIO 上决定，与编码器的物理旋向没有必然关系，所以换板、改接线、或者哪天把 A/B 对调了，这一条要重测。做界面时若希望「顺时针让数值变大」，就在固件里取反。

### 已知边界（不必修）

A、B 两相是分两次 `digitalRead()` 取回的，两次之间若正好发生跳变，读到的状态对可能从未真实存在过。查表法能丢掉「不相邻的状态对」，但对「看起来合法的反向相邻态」无能为力，最坏情况是格点附近偶发 ±1 计数（合 1/4 格，通常被下一格吃掉）。要彻底消除得一次性把两位取回（`REG_READ(GPIO_IN_REG)` 一类），自检与玩具用途下不值得。

---

## 二、加速度计（已标定）

### 为什么必须六面标定

平放静止时读数模长约 1.04 g，比 1 g 大 4%；而且未修正的模长随姿态在 0.990~1.037 g 之间变。倾斜**不会**改变模长（倾斜只是把重力矢量在各轴之间重新投影），所以这是真误差——但只看一两个姿态，分不清「往哪边偏」里多少来自零点、多少来自增益。

拿手扶的两三个姿态拟合也不行，两条理由：

1. **姿态取向的已知精度不够。** 手摆的姿态与「纯绕一根轴旋转」差约 0.34°，对姿态本身无所谓，但拟合会把这点偏差放大。
2. **不能拿读数归一化后的方向当自变量。** 读数本身就带着要拟合的零点与增益误差，由它算出的方向不等于真实方向，拟合因此有偏（变量含误差，errors-in-variables）。三组两两联立解 Z 轴，增益分别得 1.065 / 1.133 / 0.769，零点连符号都翻了——这就是这个病的症状。

六面标定绕开这两条：方向由构造给出（`±1`），不从测量里反推。

### 方法

静止时加速度计只感受 1 g 重力，方向指向地心。把每个轴分别朝上、朝下各测一次，共六个姿态。设某轴朝上静止读数为 `raw⁺`、朝下为 `raw⁻`：

- 零点偏移 `b = (raw⁺ + raw⁻) / 2`
- 实际灵敏度 `S = (raw⁺ − raw⁻) / 2`（计数/g；±2 g 档的标称值 16384）
- 修正：`a(g) = (raw − b) / S`

三个轴各算一组。六个姿态还能互相校验——修正后**每个姿态的模长都应当是 1.00 g**，哪个姿态偏了就说明哪个轴的解不对。

**怎么摆**：不要去猜「模组哪根轴朝上」，那从外面看不出来。按屏幕方向摆——点阵面朝上、点阵面朝下，再把四条边缘各翘到**正好 90°**（板子立起来，某条边成为最高的那条线）。第五节那张表给出四条边与四根模组轴的对应，所以这四个姿态正好就是 ±X、±Y 各朝上一次。

**倾角误差对零点免疫、对增益不免疫**：设某轴真实灵敏度是 `S`、姿态倾斜 `θ`，两次读数约等于 `S·cos θ + b` 和 `−S·cos θ + b`。相加除以 2 时 `cos θ` 正好抵消，所以**零点项不受倾角误差影响**；相减除以 2 得 `S·cos θ`，也就是**增益会被 `cos θ` 压低**——倾 8° 就少 1%。由此两条实用结论：同一个轴朝上、朝下那两次要摆成**大致相同的角度**（角度不等会把零点也带偏）；绝对角度却不必抠到零。**稳定性比准确性更要紧**，手抖一下污染的是整段均值。

**取样**：每个姿态静置数秒取均值。按手册噪声密度 300 µg/√Hz 估算，200 Hz 采两秒共 400 点，均值稳定性可到 0.1 mg，远小于要解决的 4%。姿态要稳，别用手按着——体温会传进去，手抖也会污染均值。

### 结果：第一块板（2026-10-17）

六个姿态的原始计数解出：

| 轴 | 灵敏度 `S`（计数/g） | 相对标称 | 零点 `b`（计数） | 零点（g） |
|---|---|---|---|---|
| X | 16384.0 | 1.00000 | +163.8 | +0.0100 |
| Y | 16404.5 | 1.00125 | −20.5 | −0.00125 |
| Z | 16682.1 | **1.01819** | −304.9 | **−0.0186** |

**误差几乎全压在 Z 轴上。** X 的增益一分不差，只有一个 +10 mg 的零点；Y 增益高 0.13%；Z 增益高 1.8% 且带一个 −18.6 mg 的零点。两个方向读数那 3.7% 的差全部由这两个常数解释，没有剩余。

修正 `a(g) = (raw − b) / S` 之后：

- 六个姿态的模长落在 **1.0000 ~ 1.0004 g**，最大偏差 0.04%，判据是 1%，余量二十几倍；修正前范围是 0.9901 ~ 1.0368 g。
- 与构造方向的夹角从 0.05°~2.51° 收到 **0.08°~1.69°**。前面那个数里混着零点与增益的误差，后面才是各姿态真正的摆放误差。最大的是「立上边缘」2.51°，那条边上有 USB 口、插着线；它对 `S_x` 的影响在 0.06% 量级，不值得重摆。
- **一个没参与拟合的姿态当了交叉验证**：第三节那 60 秒零偏采样也是平放，但摆法与六个姿态里那一次不同（板面偏了 0.79°）。用这六个常数修正它，`|a| = 1.0009 g`，差 0.086%，判据 1%。这一条比六个姿态的自检更有说服力，因为那个姿态没进过拟合。

这组常数在 2026-10-21 之后归档到 `firmware/common/BoardProfile.h.20261017`——第一块板停用，那份档案不参与编译。修正式在 `Hardware_Test.ino` 与 `Gewu.ino` 的 `imuReadCalibrated()` 里。

### 结果：第二块板（2026-10-21）

第二块板 2026-10-21 标定。**方法上有一处不同：这次是在固件实际运行的 ±4 g 量程下直接采的**，不是像第一块板那样在 ±2 g 下标定、再靠比例换算到 ±4 g。工具把读数乘回 ±2 g 刻度求解，固件读取时再乘 `IMU_ACCEL_SCALE = 0.5` 还原，两次缩放严格抵消，所以这一组在 ±4 g 下直接成立，不依赖「零点在模拟域、随量程缩放」那条假设。

摆法与判据与上面完全相同。六个姿态各采 20 秒，唯一例外是 `flat_up` 采 60 秒，顺带当陀螺零偏窗口。

| 轴 | 灵敏度 `S`（计数/g） | 相对标称 | 零点 `b`（计数） | 零点（g） |
|---|---|---|---|---|
| X | 16360.1 | 0.99854 | −32.1 | −0.00196 |
| Y | 16412.0 | 1.00171 | −135.9 | −0.00829 |
| Z | 16577.3 | **1.01180** | +56.5 | +0.00345 |

- 修正后六个姿态的模长落在 **1.0000 ~ 1.0002 g**，最大偏差 **0.02%**（判据 1%，余量五十倍）；修正前范围是 0.9934 ~ 1.0155 g。
- 六个姿态与构造方向的夹角 0.12° ~ 1.03°，全部小于 3°。
- 这六个姿态同时复核了第五节的轴映射：每个姿态的实测方向都对上了构造给定的 ±1，没有出现 90° 的错位。

**两块板子的对比：**

| 项 | 第一块 | 第二块 |
|---|---|---|
| X 增益 | 1.00000 | 0.99854 |
| Y 增益 | 1.00125 | 1.00171 |
| Z 增益 | **1.01819** | **1.01180** |
| X 零点 | +10.0 mg | −2.0 mg |
| Y 零点 | −1.25 mg | −8.29 mg |
| Z 零点 | −18.6 mg | +3.45 mg |
| 零点矢量和 | 21.2 mg | 9.2 mg |

**两颗片子的 Z 轴增益都偏高**（+1.8% / +1.2%）。两次构不成证据，但如果第三块也是这个方向，那更像是 MPU6500 这一封装/工艺的系统性，而不是个体差异——到那时值得考虑把 Z 的默认增益直接写成 1.01 左右，而不是每次从 16384 起标。现在不改。

**一条台面上的教训**：采样期间键盘抽屉的振动会把 `az` 的标准差从 0.0047 g 抬到 0.0155 g、`gy` 从 0.062 dps 抬到 0.178 dps，而且 `ax`/`ay` 纹丝不动，看起来像传感器噪声。**标定时台面必须安静**，发现标准差偏大先找振源，别怀疑芯片。

**一条摆位上的教训**：8×8 点阵是方形对称的，光看屏分不出哪条边是「左」。这次把「左边缘」摆成了「下边缘」，靠 `record` 报的夹角（89.71°）当场发现；数据本身可用（对该姿态只差 0.88°），把标签改挂到 `bottom_edge` 即可。以后立边缘的姿态一律以读数为准贴标签，不靠口头指路。

**烧回去之后的复测**（2026-10-21，Gewu v0.2 正式固件）：

| 项 | 读数 | 判据 |
|---|---|---|
| 平放，8 次采样均值 | `gxS +0.0004`、`gyS +0.0004`、`gzS −0.998`，`\|g\| = 0.998 ± 0.002` | 1.000 ± 0.01，**通过** |
| 平放，陀螺 | 三轴 `wS` 全是 `0.00`（死区 0.2 dps） | ±0.1 dps，**通过**（套第一块板常数时是 +1.4 / +11.0 / −7.3） |
| 样本外：垫到 47.9° | `gxS +0.7436`、`gyS −0.002`、`gzS −0.6719`，`\|g\| = 1.0022` | 1.000 ± 0.01，**通过** |

单次采样的散布约 ±5 mg，比六面自检那 0.02% 大是正常的——那边是 20 秒平均。烧录后**没有**观察到第三节那条约 1 dps 的暂态，见该节末尾。

### 判据与去向

判据是修正后六个姿态的模长都落在 `1.00 ± 0.01 g`。产出是六个常数（三轴各一个零点、一个增益），写进固件的 IMU 层。本文档抄它们是为了留痕，**权威副本在固件里，两处不一致时以固件为准**。

---

## 三、陀螺零偏（已标定）

### 第一块板（2026-10-17）：60 秒静止采样

板子平放不动，`python tools/imu_stat.py --sec 60`，120 点：

| 轴 | 均值 | 单点标准差 | 标准误 | 零偏常数（计数） |
|---|---|---|---|---|
| `gx` | −1.313 dps | 0.058 | 0.0053 | −172 |
| `gy` | +3.662 dps | 0.055 | 0.0050 | +480 |
| `gz` | −1.292 dps | 0.056 | 0.0051 | −169 |

温度 28.2~28.6 °C（均值 28.4）。

**没有可辨识的漂移。** 分成六个 10 秒窗口，逐窗均值的首末差在 ±0.01 dps 以内，而同期温度升了 0.30 °C；窗口之间的散布略大于单窗标准误，是随机的低频抖动，不累积。单点标准差 0.056 dps 与手册噪声密度换算出的量级一致（44 Hz DLPF 下约 0.08 dps），说明这一轮板子确实静止。

顺带一提，`gy = +3.662 dps` 完全落在手册给的初始容差内（±20 dps 这一档），**不是故障、不是坏件**；零偏的意义只在于软件补偿能把静态漂移压下去。

### 落进固件后复测

常数写进去之后，复位后连采五个 60 秒窗口（板子已经热了）：三轴各稳在 **±1 个计数（0.01 dps）**以内，五分钟内没有趋势；与上面那次 28.4 °C 的 −172 / +480 / −169 相比只差 1~3 个计数，即 **≤0.03 dps**。所以零偏在热态稳定时是**可复现**的。

### 一个还没解释掉的暂态

烧录之后那一次采到，同板同姿态，只按复位后的时间排列：≈2 s 时修正后 `gz` 约 −1.16 dps，≈33 s 时 −0.50，≈170 s 时 −0.37，≈220 s 时已回到 −0.07，稳态 −0.02。一个约 **1 dps、衰减时间一两分钟**的暂态。上面那五个窗口**没有复现它**，因为那时板子本来就是热的。

两个候选机制现在分不出来：

1. **烧录带来的热暂态。** 往 flash 写 300 KB 那阵子电流持续偏高，而普通复位只有不到一秒的活动。
2. **过载后的零偏记忆。** 烧录后拿起板子那阵子，`GRAV` 行里出现过 +18 dps，有些 MEMS 陀螺在大角速度输入之后零偏会偏掉再慢慢回来。

分清楚要专门做实验（故意甩一下看它怎么回，或者等板子凉透再通电看有没有同样的暂态）。**实用上的结论不受影响**：单点补偿在热态稳定时有效到 0.03 dps，但烧录完或者大动作之后要等几分钟再信它——将来真要做陀螺积分，这一条必须先解决。

**一条新证据（2026-10-21，第二块板）**：第二块板从连续运行的热态直接烧录，烧完立刻读 `s`，三轴 `wS` 全是 0.00——死区是 0.2 dps，真有 1 dps 的暂态一定看得见。没有复现。这与「烧录带来的热暂态」这个候选一致：第一块板那边热态复测也没复现，第二块板热态烧录当场就没有。反过来说，若真是热暂态，等板子凉透再烧一次应当能稳定复现，那是下一步最便宜的判别实验。

### 判据与去向

判据：补偿后静止时三轴读数均值落在 ±0.1 dps 内。这里要给个时间尺度——**同一次采样内**的标准误是 0.005 dps，**跨次复测**的偏差是 0.03 dps，都远在判据内；那个 1 dps 的暂态不在此列。

**温度**：0.7 °C 的温差只带来 ≤0.03 dps 的变化，也就是这颗陀螺的温度系数大致在 **0.04 dps/°C 以内**，比手册典型值还小——在这个温度范围内单点补偿就够。真要做温漂补偿得在多个温度点各采一次，对玩具项目大概不值。另外标定时不要用手拿着板子：体温会传进去，也会顺着线缆扯动板子。

### 第二块板（2026-10-21）

同样的 60 秒平放静止窗口，121 点，温度 25.3 °C：

| 轴 | 均值 | 单点标准差 | 标准误 | 零偏常数（计数） |
|---|---|---|---|---|
| `gx` | −6.742 dps | 0.059 | 0.0053 | **−883** |
| `gy` | +2.919 dps | 0.062 | 0.0056 | **+382** |
| `gz` | +2.329 dps | 0.052 | 0.0047 | **+305** |

单点标准差与第一块板（0.058 / 0.055 / 0.056 dps）一致，说明噪声水平是同批次的；但**零偏完全不同**：

| 轴 | 第一块 | 第二块 | 差 |
|---|---|---|---|
| X | −1.31 dps | −6.74 dps | **5.4 dps** |
| Y | +3.66 dps | +2.92 dps | 0.7 dps |
| Z | −1.29 dps | +2.33 dps | 3.6 dps |

两个值都落在手册的初始容差（±20 dps）里，都不是坏件。这一条是「同型号不能共用常数」最直接的证据：把第一块的常数套到第二块上，静止时屏幕系角速度残留 **+1.4 / +11.0 / −7.3 dps**，是固件 0.2 dps 死区的几十倍。

### 没有标的部分，以及为什么不标

**没标的**：标度因子（手册给的初始容差是 ±3% 量级）、交叉轴灵敏度（±2% 量级）、非线性、以及标度因子的温度系数。零偏是唯一标了的量（三个常数）。

**为什么不标**，按用途分三档：

- 「在不在转、往哪边转」——零偏加轴符号就够，判过零点即可。
- 「转得多快」当控制量——几个百分点的标度误差看不出来。
- **积分求角**——这时确实要，但**瓶颈不是标度**。零偏 0.03 dps 走一分钟就是 **1.8°**，而那个 1 dps 的暂态一分钟是 **60°**；标度 3% 作用在「转过 90°」上是 **2.7°**，而且不随时间累积。所以任何积分应用里，先要解决的是零偏的稳定性，不是标度。

**真要标的话有个不用转台的办法**：拿重力当绝对参考。静止 → 绕某根屏幕轴转 180° → 静止，加速度计能给出终点姿态（准到 0.1° 以内）；把这段时间的角速度积分起来（先减零偏、端点取静止区间），标度因子 = 积分值 / 180°。精度受限于转动有多快——转得越快，零偏在积分里的占比越小。

---

## 四、温度（不标定，但要配对公式）

温度不是标定的对象，但它是陀螺零偏漂移的自变量，所以记两条：

- **公式必须与型号匹配**。MPU6500 与 MPU6050 的换算公式不同，套错在室温下会偏高约 15 °C，**不报错也不警告**，是换芯片后最容易静默出错的地方。固件已经按 `WHO_AM_I` 选公式，并把裸值一并打印，日后换芯片时一眼能看出该用哪条。
- **绝对温度本身不校**。MPU 内置温度传感器的绝对精度是几度级别，而本项目只拿它看漂移趋势，不需要绝对准确度。

---

## 五、安装朝向 → 屏幕坐标映射（已确定）

格物的核心输入是「重力矢量指向屏幕的哪一边」，所以 IMU 的轴与 8×8 点阵的坐标之间必须有确定的映射。它跟「传感器标定」是两件事：六面标定解决的是**数值准不准**，这一项解决的是**哪个轴对应屏幕的哪一维**。

屏幕这一侧在第六节已经定了：逻辑坐标是数学系，原点左下，`x` 右、`y` 上。

### 结论

三根屏幕轴在模组坐标系里的像：

| 屏幕轴 | 模组坐标 |
|---|---|
| `x`（向右） | `−Y` |
| `y`（向上） | `−X` |
| `n`（出屏、朝观察者） | `−Z` |

于是读数换到屏幕系（静止时加速度计测的是支持力，方向朝**上**，所以重力是它取反）：

```
g_x = +ay / |a|
g_y = +ax / |a|
g_z = +az / |a|        // 出屏为正，点阵面朝上平放时该读到约 −1.0
```

**平面内的映射就是一次交换，不取反、不翻转。** 二维世界要的重力投影是 `(ay, ax) / |a|`，它的模长等于 `sin(倾角)`；平方和不足 1 的那部分落在法线方向上，与平面内的物理无关。

和第六节一样，这是**实测结论而不是约定**：换安装方向、换板、换点阵模块都要重验。

### 实测记录

姿态方向一律以屏上那盏灯为准，这样没有观察者视角的歧义：先在屏上点一个 L 形（`h 0` + `v 0`，拐角即原点，在左下角），于是「右边缘」指离那条竖线最远的那条边、「上边缘」指离那条横线最远的那条边。每组静止采 8 秒。

| 姿态 | 读数（世界「上」在模组系，已归一化） | 推出 |
|---|---|---|
| 点阵面朝上平放 | (0.012, −0.002, −1.000) | `ax`、`ay` 都近 0 → X、Y 躺在屏幕平面里，**法线就是 Z** |
| 抬起右边缘约 39° | (0.018, −0.628, −0.778) | 翘 `x = 7` 那条边只动 `ay` → 屏幕 `+x` 映到 `−Y` |
| 抬起上边缘约 35° | (−0.572, +0.000, −0.820) | 翘 `y = 7` 那条边只动 `ax` → 屏幕 `+y` 映到 `−X` |

后两行是**预言在先、实测在后**的：第一行定了法线之后，用「屏幕系与模组系都是右手系」这一条，`x̂ × ŷ = n̂` 只有一组解，据此可以算出第二行应当读到 `(−sin θ, 0, −cos θ)`。把实测的 34.91° 代进去得 `(−0.5723, 0.0000, −0.8200)`，与实测四位小数完全相同。两个本来会翻车的分支——`+y` 映到 `+X`、或者法线不是 `−Z`——由此排除。

按第一行的法线反解第二行时，`屏幕 x̂` 的像在 `X` 上还留了约 0.03 的分量（约 1.6°），比噪声大。可能是芯片贴装相对板边歪了一两度，也可能是 X 轴的零点；两种可能都不影响上面那张表（次近的候选轴离它 88°）。

上面这三个姿态只翘到 35°~39°，**方向信息够用，满足不了六面标定对「严格竖直」的要求**。把四条边各翘到正好 90°，再加点阵面朝上、朝下，正好六个，所以第五节和第二节可以一次做完，不必摆两遍。

### 落地

已写进 `firmware/Hardware_Test/Hardware_Test.ino`：

- `gravityInScreen()` —— 上面那三行，全文件只有这一处定义模组系与屏幕系的对应（跟点阵那边的 `logicalToHw()` 同一个做法）
- `imuReadCalibrated()` —— 在 `imuRead()` 之上套第二、三节的两组修正常数
- 重力显示模式，间隔 `GRAVITY_MS = 50`（20 Hz），串口命令 `g` 进入，把平面内的重力方向画成一颗灯

**那条 500 ms 的 IMU 数据行仍是未修正的原始读数**，故意不动：它是标定的输入，换模块重标定要从这种日志里取数。修正后的物理量由重力模式每 500 ms 打一行 `GRAV` 给出，两者可以互相核对。

### 验收（已通过）

平放加四个倾斜方向，屏上那颗灯与 `GRAV` 行的读数对着看：

| 抬起的边 | `gx` | `gy` | tilt | `dir` | 灯落在 | `\|g\|` |
|---|---|---|---|---|---|---|
| 平放 | +0.007 | +0.007 | 0.6° | `LEVEL` | 正中 | 0.999 |
| 右边缘（`x = 7`） | −0.858 | +0.007 | 59.1° | `L` | 最左列 | 1.000 |
| 左边缘（`x = 0`） | +0.702 | −0.009 | 44.6° | `R` | 最右列 | 0.999 |
| 上边缘（`y = 7`） | −0.015 | −0.933 | 69.2° | `D` | 最下行 | 0.997 |
| 下边缘（`y = 0`） | +0.027 | +0.636 | 39.4° | `U` | 最上行 | 1.003 |

五个姿态里只有「平放」进过六面拟合，其余四个都是样本外的。`|g|` 全部落在 0.995~1.006 g。

还有一层比模长更硬的几何自检：倾斜姿态下 `sin(tilt)` 应当等于平面内分量、`cos(tilt)` 等于 `|gz|`。以抬右边缘那次为例，59.1° 给出 0.858 与 0.514，实测 `gx = −0.858`、`|gz| = 0.513`——**两个分量各自对上**，而不是只凑出一个凑巧正确的模长。

### 角速度用同一张表，但**不是**同一个函数

陀螺与加速度计在同一颗 die 上，所以轴是同一套，映射表也还是上面那张。但把表用在角速度上时符号跟重力**相反**，而且理由不同：

- 加速度计读的是**支持力**（方向朝上），重力 = 取反，所以那一路上有两个负号恰好抵消，结果是不取反的一次交换：`g_screen = (ay, ax, az)`。
- 角速度是直接的物理量，不取反，于是每根屏幕轴在模组里指向负方向的那个负号留下来：`ω_screen = (−ω_Y, −ω_X, −ω_Z)`。

还有一处比符号更容易翻车的：角速度是**赝矢量（轴向矢量）**，一般变换是 `ω' = det(R)·R·ω`，比普通矢量多一个行列式符号。这里 `det(R) = +1`——屏幕系与模组系**都是右手系**（`x̂ × ŷ = (−Y) × (−X) = −Z = n̂`），所以那个符号是 +1。**若哪天真把屏幕系改成镜像，角速度会整体翻号而重力不会有任何变化**，这就是为什么固件里是 `gravityInScreen()` 与 `rateInScreen()` 两个函数、两段注释，而不是一个带符号参数的函数。

三项实测都是**先由推导给出预言、再实测**，相位基准取同一帧里的重力（转速本身没有绝对参考，重力有）：绕法线顺时针转，预 `ω_z < 0`，14 点全负；抬右边缘，预 `ω_y < 0`，抬升段全负；抬上边缘，预 **`ω_x > 0`**，抬升段全正。第二条与第三条符号相反，不是笔误，是那张表里 `x` 与 `y` 一根成右手、一根成左手的结果——这一对同时验证了符号和行列式那一条。

固件里的落地是 `rateInScreen()`，`g` 模式每 500 ms 打的那行 `GRAV` 末尾三个数就是它算出的屏幕系角速度（这一行里的数因此全是屏幕系）。

**正式固件已经接上这一路。** `firmware/Gewu/Gewu.ino` 每 5 ms 读一次陀螺，链路是 `rateInScreen()` → 屏幕系 → 每轴 0.2 dps 死区 → `w` 转速增益 → `PhysicsWorld::setSpinScreenQ16()`（翻 y、z 进引擎系）。`s` 的 `[STA]` 行直接打印屏幕系三轴 ω 与 ω̇（dps 与 dps/s），验收时按上面三条预言比对即可；平放静止时三轴应落在 0.2 dps 死区内。转动原点用实测的模块安装位置：逻辑格 (4,7) 的格心，即引擎连续坐标 (4.5, 0.5)，常量在 `BoardProfile.h` 的 `IMU_PIVOT_ENGINE_X/Y`。陀螺零偏到 0.03 dps 对离心、科氏、欧拉的影响远低于板面静摩擦死区，所以本版不再做额外补偿；但烧录后那条约 1 dps、衰减一两分钟的暂态仍然存在——它不影响本版动力学，将来若要用陀螺积分求角度，仍要先解决这一条。

---

## 六、点阵屏（已确认）

### 结论

| 量 | 值 | 判定 |
|---|---|---|
| `MX_HW_TYPE` | `FC16_HW` | 逻辑行落在屏上是**横线**、逻辑列是**竖线**，与该类型的定义一致，不用换 |
| `MX_ROTATION` | `0` | 逻辑 `y` 向上增长，于是 `(x, y)` 直接就是数学坐标系，不需要旋转 |
| `MX_DEVICES` | `1` | 级联模块数，本板只有一块 |
| `INTENSITY` | `0` | 上电初值，运行时可用 `i` 改 |
| `SCANLIMIT` | `7` | 扫描 8 行，单块模块固定 |
| `DECODE` | 关 | 必须关，否则收到的不是点阵图案 |

**坐标约定**：逻辑坐标是**数学系**——原点在左下角，`x` 向右、`y` 向上，各 0~7。固件里 `p x y` 的第一个参数是 `x`。

这个约定与 MAX7219 库的行主序 `(row, col)` 差一个转置，换算只发生在固件的 `logicalToHw()` 一处。之所以只把两个参数换个位置、不做 `7 - y`，是因为实测本模块装好后逻辑 `y` 与库的 `row` 数值直接相等。**这条「数值相等」是实测结论而不是约定**，换板或换模块要重验。

### 实测记录

把亮度提到 `i 8`（最暗档在环境光下看不清走向），清屏后逐点点亮、人眼判读：`p 0 0` 在左下角，`p 0 1` 在正右方（`x` 向右），`p 1 0` 在正上方（`y` 向上，与库的 row 同号），`h 3` 是一条自下往上第 4 行的横线，`v 3` 是一条自左往右第 4 列的竖线，四角全对。没有位序整段反转的坑。

**一条方法论上的注意**：`(FC16_HW + 模块数字线是横的)` 与 `(GENERIC_HW + 模块数字线是竖的)` 会给出**逐点完全相同**的映射——两者差一个转置，物理网格转置一次、逻辑坐标又转置一次，正好抵消。所以「模块真实属于哪一族」在原理上既无法、也不必判定，有意义的只有最终那张映射表。判断该不该换 `MX_HW_TYPE`，看的是「逻辑行在屏上是横是竖」，而不是去猜模块接线。

### 工具：串口命令

这一项的判据是「哪颗物理灯亮」，串口里读不出来，只能人眼看。`Hardware_Test` 里那一路命令就是为此，上电仍是跑马灯，敲 `?` 打完整清单。宿主侧用 `tools/serial_send.py` 发这些命令：`python tools/serial_send.py 'i 8' 'c' 'p 0 0'`。

| 命令 | 作用 |
|---|---|
| `p x y` | 点亮逻辑坐标 (x, y)。**不清屏**，可以连着画 |
| `c` | 清屏，唯一会擦除内容的命令 |
| `a` | 全亮，查死点 |
| `h y` / `v x` | 点亮整行 / 整列 |
| `s row` / `s col` / `s off` | 逐行扫 / 逐列扫 / 停 |
| `m [ms]` | 切回跑马灯，带参数则同时改每格毫秒 |
| `g` | **重力模式**：把平面内的重力方向画成一颗灯，20 Hz 更新，每 500 ms 打一行 `GRAV`。这是第五节那张映射表的落地与验收工具 |
| `i [0-15]` | 设亮度，不带参数则报当前值 |

**重验的走法**（换模块或改板子朝向之后）：`i 8` 提亮度 → `c` 清屏 → `p 0 0` 看是否在左下角 → `p 1 0` 看是否在正上方 → `p 0 1` 看是否在正右方 → `h 3` / `v 3` 看行列走向。结论写回 `MX_HW_TYPE` / `MX_ROTATION`。

**为什么朝向只能靠重编译，亮度却不用**：点一旦画进 MAX7219，缓冲里存的就是**物理位置**，运行时改映射改不动已经画上去的内容；要让它在运行时生效，固件就得另存一份逻辑坐标的影子、每次切朝向整体重画，为一个只做一次的动作不值得。亮度只是一条寄存器写入，不存在这个问题，所以给了 `i`。

判断依据是现成的：`chaseStep()` 是**逐点**画的（不是拼行字节），所以 `MX_HW_TYPE` 错了会直接表现为镜像、转置、或者走到某一行跳到别处。拼行的话行列反了看不出来，逐点画才验得出来——这也是当初这么写的原因。

### 亮度的物理事实

强度寄存器的 16 档对应占空比 `(2n + 1) / 32`，从 1/32 到 31/32。占空比是线性的，**人眼感知不是**：0→1 的变化看得出的程度远比 14→15 大。要做「感觉均匀」的调光，得自己按幂律重映射，不能直接拿档位当等差用。

### 边界：没有逐点灰度

MAX7219 的强度寄存器是**整屏**调光，没有逐点灰度。要做灰度（比如重力动画的拖影、渐隐）得在固件里分时复用做软件 PWM，这会跟 SPI 刷新率、跑马灯节拍、以及按键扫描的实时性互相牵制。**这是设计决策，不是标定能解决的**，所以要在这条分支上定下来：格物是否真的需要灰度。

---

## 待办

- [x] 加速度计六面标定——已出六个常数，见第二节；修正后六姿态模长最大偏差 0.04%
- [x] 安装朝向 → 屏幕坐标的轴映射——已测：屏幕 `x` = `−Y`、`y` = `−X`、法线 = `−Z`
- [x] 九个常数（加速度计六个 + 陀螺三个）与轴映射一起写进固件，并加了一个把屏幕系重力方向画出来／打出来的 `g` 模式
- [x] 落地后用四个倾斜方向复核——四个方向与平放全对，见第五节「验收」那张表
- [x] 陀螺零偏静止采样——60 秒 120 点，首末窗口无趋势，温度 28.4 °C
- [x] 陀螺轴 → 屏幕坐标——三项都按「推导先给预言、实测后验」做过，符号与行列式判定全部成立
- [ ] 陀螺那个约 1 dps 的暂态（烧录后出现、一两分钟衰减）机制未定，见第三节
- [ ] 第二块板的点阵与编码器沿用第一块板的结论，尚未独立重测（同 PCB 同模块，原理上应一致；换模块时要重验）
- [ ] 两块板的 Z 轴增益都偏高（+1.8% / +1.2%），第三块板可用来验证是否为系统性
- [ ] 陀螺标度因子不标，但这条决定写下来了；将来若要做积分求角，先解决暂态再谈标度
- [x] 点阵屏 `MX_HW_TYPE` 实机确认——`FC16_HW` 正确，逻辑行是横线
- [x] 点阵屏 `MX_ROTATION` 定下来——`0`，逻辑坐标随之定为数学系 `(x, y)`
- [ ] 定下格物是否需要逐点灰度（这是个设计问题，不是标定问题）
- [ ] 点阵屏亮度分档实测（若显示上要用到中间亮度）
- [ ] 编码器：换板或改接线后重测旋向符号

## 什么时候需要重新标定

- 改了量程（`AFS_SEL` / `FS_SEL`）——零点与增益的比例尺全变
- 改了采样率或 DLPF（`SMPLRT_DIV` / `CONFIG` / `ACCEL_CONFIG2`）——噪声带宽变，零偏均值随之变
- 换了传感器型号，或换了模块（同一型号不同批次的零点也不同）
- 改了传感器相对点阵屏的安装朝向——第五节那张轴映射表要重验，**加速度与角速度两份都要**（陀螺那份还要盯符号：`x` 与 `y` 一正一负）
- 换了点阵模块，或改了模块相对板子的安装方向——重验第六节那张映射表
- 工作温区明显偏离标定温度（只有做了温度补偿才不受影响）
