konamivrc6/Gewu/firmware/common/BoardProfile.h

/*
 * BoardProfile —— 这台格物板子实测出来的档案（第二块板，2026-10-21 标定）
 * ======================================================================
 *
 * 【这是第几块】仓库里现在有两块实机。第一块（2026-10-17 标定）的档案归档在
 * BoardProfile.h.20261017，那份不参与编译；本文件对应第二块，2026-10-21 完成六面标定与陀螺零偏采样。
 * 两块板子共用同一版 PCB 与同一批模块，所以点阵与编码器那几条是设计不变量，直接沿用；
 * 凡与 IMU 有关的每一条都是这块板子重新测的。要给第一块板重烧之前，先把两份档案换回来。
 *
 * 【分组规则】只存「实测结论」和「标定成立的前提」，不存可以随手调的旋钮。
 * 一行东西如果改了就代表这台板子的实测结论变了，它在这里；如果改了只是「我想让它跑快一点 / 亮一点」，
 * 它留在 .ino 的「可调参数」一节。轴映射不是数而是逻辑，所以在 .ino 的 gravityInScreen() 里。
 *
 * 【每条的出处】结论、判据与原始记录都在仓库根目录《标定.md》：
 *   点阵模块的行列走向与朝向        第六节（第一块板实测；本板同 PCB 同模块，未独立重测）
 *   编码器每格的正交跳变数          第一节（同上）
 *   加速度计的零点与增益（六个量）  第二节
 *   陀螺零偏（三个量）              第三节
 *   IMU 轴 → 屏幕坐标的映射          第五节（本板由六面标定的夹角间接复核，见第二节）
 *   加速度计的安装位置（转动原点）  实物测量：逻辑格 (4,7)
 *
 * 【不要手改】这些是量出来的，不是调出来的。改了等于伪造标定，而且这种错是**静默**的：
 * 读数照样有、屏幕照样亮，只是每一个数都带一个你自己编的偏置，形态上还像模像样。
 * 要改就去重测，流程与台面工具见《标定.md》，六面标定用 tools/accel_calib.py。
 *
 * 【什么时候整份作废】换板、换点阵模块、换 IMU 模块、改任何器件的安装朝向、
 * 改量程或采样率 / DLPF（下面那组「标定成立的前提」）。
 */
#ifndef BOARD_PROFILE_H
#define BOARD_PROFILE_H

#include <MD_MAX72xx.h>   // 只为 moduleType_t：点阵的「硬件档案」是库里的枚举，不是裸数字

// ============================ 点阵模块（沿用第一块板） ============================

// 【已实机确认】本板就是 FC16_HW，不用改：串口点出四角和 h 3 / v 3 两条线，
// 四角与两条线的朝向全部与预期一致，即逻辑行确实是横线、逻辑列确实是竖线。依据见《标定.md》六节。
// 若换模块后跑马灯方向不对，按下面四个候选逐个试；四个都不对再动 MX_ROTATION。
//   MD_MAX72XX::FC16_HW      最常见的单块 8×8 模块（FC-16 板型）
//   MD_MAX72XX::PAROLA_HW    Parola 套件用的模块
//   MD_MAX72XX::GENERIC_HW   通用型
//   MD_MAX72XX::ICSTATION_HW ICStation 的模块
static const MD_MAX72XX::moduleType_t MX_HW_TYPE  = MD_MAX72XX::FC16_HW;

// 【已实机确认】0 就是对的：本模块装好后逻辑 y 恰好向上增长，于是 (x, y) 直接就是数学坐标系，不需要旋转。
// 0~3，每加 1 把逻辑坐标顺时针转 90°，实现见 .ino 里的 logicalToHw()。
static const uint8_t                  MX_ROTATION  = 0;

static const uint8_t                  MX_DEVICES  = 1;    // 级联模块数，本板只有一块

// ============================ 编码器（沿用第一块板） ============================

// EC11 转一格产生的正交跳变数。实测 5 格 → 5 行事件、每行 detent 只动 1，与 4 对得上。
// 转一格刷出 4 行事件就说明这个值不对，改它——但那是重测，不是调参。
static const uint8_t  ENC_STEPS_PER_DETENT = 4;

// ============================ IMU 接线与配置 ============================

static const uint8_t  MPU_ADDR       = 0x68;   // AD0 接地（硬件接线.md 5.4 节）

// 加速度计的安装位置，也就是刚体转动的原点。物理内核要的是引擎连续坐标（x 右、y 下、格子占 [c, c+1]）：
// 逻辑列 4 的格心是 x = 4.5；逻辑顶行 7 对应引擎 cy = 0，格心是 y = 0.5。写成引擎坐标是为了让 .ino 里不再出现一次行翻转。
// 这是实物位置，不是调参旋钮——模块挪了就要重测。
static const float IMU_PIVOT_ENGINE_X = 4.5f;
static const float IMU_PIVOT_ENGINE_Y = 0.5f;

// 【标定成立的前提】下面这五个是**选择的**，不是测出来的——但标定结果只在这一组值下成立，
// 所以和标定产物放在一起。改量程时零点与增益按比例换算（见 IMU_ACCEL_SCALE），改采样率或 DLPF 会改噪声带宽。
//   SMPLRT_DIV 0x04 → 1 kHz / (1+4) = 200 Hz 采样
//   CONFIG     0x03 → 陀螺 DLPF 44 Hz 档
//   ACCEL_CONFIG2 0x01 → 加速度计 DLPF 218 Hz 档（只有 MPU6500 有这一颗寄存器）
//     原来是 0x03（44 Hz），会把手甩那种十几毫秒的脉冲削掉大半。DLPF 只改带宽，不改静态增益与零点，所以这一项不影响标定。
static const uint8_t  IMU_SMPLRT_DIV     = 0x04;
static const uint8_t  IMU_DLPF_CFG       = 0x03;
static const uint8_t  IMU_ACCEL_DLPF_CFG = 0x01;

// IMU 量程。寄存器值和每单位 LSB 数是一对，改一个必须同时改另一个。
//   AFS_SEL 0x00=±2g(16384) 0x08=±4g(8192) 0x10=±8g(4096) 0x18=±16g(2048)
//   FS_SEL  0x00=±250(131)  0x08=±500(65.5) 0x10=±1000(32.8) 0x18=±2000(16.4)  —— 单位 dps
// ±4 g 是为了让猛甩不削顶；代价是每 LSB 对应的 g 值翻倍，静态分辨率减半。
static const uint8_t IMU_ACCEL_AFS = 0x08;
static const float   IMU_ACCEL_LSB = 8192.0f;
static const uint8_t IMU_GYRO_FS   = 0x00;
static const float   IMU_GYRO_LSB  = 131.0f;

// ============================ 标定产物（实测） ============================

// 九个修正量，来历与判据见《标定.md》第二、三节：
//   a_g[i]   = (raw[i] - ACCEL_OFFSET[i]·k) / (ACCEL_GAIN[i]·k)     k = IMU_ACCEL_SCALE
//   w_dps[i] = (raw[i] - GYRO_OFFSET[i])  / IMU_GYRO_LSB
//
// 【这组是在 ±4 g 下直接测的，不是 ±2 g 标定再换算】工具按「读数 × 2」把结果表达在 ±2 g 刻度上，
// 固件读取时再乘 k = 0.5 还原，两次缩放严格抵消。所以本板没有「零点是否随量程缩放」这条假设——
// 第一块板那组是在 ±2 g 下标定、在 ±4 g 下使用，才需要那条假设。
//
// 为什么非修正不可：未修正时静止模长随姿态在 0.993 ~ 1.016 g 之间变，也就是「往哪边偏」既取决于姿态、
// 又取决于误差，单点读数根本分不开这两者。修正后六个标定姿态的模长落在 1.0000 ~ 1.0002 g，最大偏差 0.02%，
// 判据是 1%，余量五十倍。
//
// 误差分布比第一块板均匀：X 增益低 0.146%、零点 −2.0 mg；Y 增益高 0.171%、零点 −8.3 mg；
// Z 增益高 1.180%、零点 +3.4 mg。零点矢量和 9.2 mg（第一块板是 21.2 mg）。
//
// 陀螺零偏 −6.74 / +2.92 / +2.33 dps。X 轴比第一块板大 5.4 dps——同型号两颗片子的零偏可以差这么多，
// 所以这组常数不能跨板沿用。60 秒静止窗口的单点标准差 0.059 / 0.062 / 0.052 dps，
// 121 点的标准误 0.0055 dps，判据是 ±0.1 dps。
static const float IMU_ACCEL_CAL_LSB = 16384.0f;
static const float IMU_ACCEL_SCALE   = IMU_ACCEL_LSB / IMU_ACCEL_CAL_LSB;   // ±4 g 时 0.5
static const float ACCEL_GAIN[3]   = {16360.1f, 16412.0f, 16577.3f};
static const float ACCEL_OFFSET[3] = {-32.1f, -135.9f, 56.5f};
static const float GYRO_OFFSET[3]  = {-883.0f, 382.0f, 305.0f};

#endif  // BOARD_PROFILE_H
