konamivrc6/Gewu/(commit log)

2026-10-02 docs(hw): bootstrap 格物 with README and hardware wiring guide
    - Add README.md covering Bill of Materials, the 3.3V/5V level-shifting rationale, the software stack and the open design questions
    - Add 硬件接线.md with verified pin allocation, per-device wiring, pull-up/capacitor decisions, common pitfalls and a pre-power checklist
    - Add .gitattributes forcing LF line endings repo-wide and excluding binary formats from text conversion
2026-10-02 feat(tools): add EasyEDA Pro project parser and PCB netlist exporter
    - Add epro_dump.py to unpack .epro2 archives and stream the .epru JSON Lines store into per-document element records
    - Add netlist.py to resolve PAD_NET records into a designator-keyed netlist, so the board can be cross-checked against 硬件接线.md independently of the EDA's own DRC
    - Both scripts are dependency-free and read an exported project directly, no need to open the editor
    - Add .gitignore for Python bytecode caches and the preview images extracted while inspecting a project
    [epro_dump.py, netlist.py]
2026-10-03 fix(tools): count delete tombstones separately in .epru parser
    - A delete tombstone is written as "head|||", which leaves a lone "|" behind after both separators are stripped, not an empty string; the old check only tested for a blank body, so every tombstone fell through to the JSONDecodeError branch and was tallied as a parse failure, drowning out real parse errors
    - Report tombstones under their own "<墓碑>" counter instead of the type tally, so per-type element counts stop being inflated by entries that no longer exist
    [epro_dump.py]
2026-10-03 docs(hw): trim duplicated notes from wiring guide and record C1 as unpopulated
    - Drop the lines that restated rules already carried by the "三条铁律" list, the per-device tables or the "易错点" section (5V pull-up ban, I2C-through-buffer ban, single-network-name pitfall, module pinout caveat)
    - List C1 in the 5V domain and split it out of the MAX7219 decoupling row as an explicitly unpopulated backup bulk cap, matching the schematic's "Add into BOM = no" flag
2026-10-03 chore(pcb): add EasyEDA Pro project and Gerber export
    - PCB/ProPrj_Gewu_2026-10-03.epro2 is the reviewed four-layer board: 90.0 x 60.0 mm outline with R1.98 corners, six M3.2 mounting holes, GND and +5V solid inner planes on L2 and L3
    - PCB/Gerber_PCB1_2026-10-03.zip is the fabrication export taken from that revision, 17 files including the two drill programs and the flying-probe test data
    - Mark .epro2 as binary in .gitattributes; it is a ZIP container, so relying on git's text auto-detection is not safe and a stray eol conversion would corrupt the archive
    - README: enumerate PCB/ and tools/ in the file table, and tick off the PCB milestone
2026-10-12 chore(pcb): 加入顶部面板 Gerber 与前面板 Logo 图稿
    - PCB/Gerber_TopShell_2026-10-12.zip 是前面板的制造导出件；面板不露铜，阻焊是负片，GTS/GBS 里因此没有图元，下单前需补一个落在挖槽内的图形或由审核人工放行
    - PCB/ProPrj_Gewu_2026-10-12.epro2 是立创EDA 专业版工程，前面板文档 TopShell 与主板并列其中
    - 面板Logo/ 存放图稿：总览 SVG 把铜皮（浅绿）、铜皮挖空（深绿）与丝印（白）分成独立的组，另有供导入的分层 SVG 与 PNG、可直接喂给 art2pcb 的平色图，以及整板预览
    - 画面是白丝印压在铜板上，投影从铜里挖穿、露出基材；投影偏移对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
2026-10-13 refactor(tools): 抽出工程包解析的公共层
    - 新增 doc_sections / iter_section_records：按 DOCHEAD 划分文档段并归属记录，
    段名取段内第一条 META 的 title（器件名、封装名、板名都在那儿，DOCHEAD 里没有）
    - 新增 device_index：器件库索引以 DOCHEAD 的 uuid 为键。META 记录的 head["id"]
    恒为常量 "META"，拿它当键会让 25 个器件互相覆盖、只剩一条
    - 新增 find_latest_project：自动取 PCB/ 下最新的 .epro2。三个脚本原先各自硬编码
    工程名，工程一改名（2026-10-06 → 2026-10-12）就集体失效
    - 新增 natural_key / layer_name，统一 R1..R10 的排序与层面命名
    - survey 改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
2026-10-13 fix(tools): 修正网表导出只读第一个 PCB 段导致的空输出
    工程里有三个 PCB 文档（主板 PCB1、顶壳 TopShell、已删除的 Power），
    find_pcb_section 只返回第一个，而第一个是顶壳、一个元件都没有，
    于是脚本一路静默输出「元件 0 个」，看起来像工程是空的。
    - 改为遍历全部 PCB 文档段，用共用的 doc_sections 切分
    - 位号改从原理图段取，靠 Unique ID 与 PCB 元件连接。PCB 段的 Designator 是
    layout 时为手焊方便手工改的展示值（100nF / 4k7 / HCT125），38 个里 21 个
    与真位号不同，不能当位号用
    - 器件名改走 device_index。原先对 Device 属性的值做 js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
    [netlist.py]
2026-10-13 feat(tools): 重写元器件清单导出，补上聚合采购表与手焊清单
    原来三列（封装 / 立创编号 / 描述）全空、默认参数必然报错，重写后裸跑即可。
    - 器件关联改按 DOCHEAD 的 uuid 查器件库，修好全空的三列；顺带救回 SW4——
    它的 partId 是 EC11E15244B2，器件库里那条却叫 EC11E15244B2_C470754
    - 立创编号取 Supplier Part，描述取 LCSC Part Name；原先两者取反，表里会拿
    100nF ±10% 50V 这类描述冒充 C5137467 这类编号
    - 封装名走 DEVICE 的 Footprint(uuid) → FOOTPRINT 段的 META.title；
    原理图 Footprint 属性 38/38 全为 null，Supplier Footprint 是供应商分类串
    - 新增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
2026-10-16 docs(hw): 订正 M3 传感器型号为 MPU6500
    - 接线文档：器件清单、电压域、引脚分配、5.4 节标题、易错点 5 与参考资料一并改名
    - README：硬件表、设计要点里 I2C 的表述与软件栈一并改名，并注明 EDA 工程沿用 MPU6050 只是元件库所限
    - 依据：firmware/Hardware_Test 上电自检把 WHO_AM_I 读回 0x70，与 MPU6050 的 0x68 不符
2026-10-16 feat(firmware): 板级上电自检草图
    - firmware/Hardware_Test：一次上电验 MAX7219 点阵（经 SN74HCT125 电平转换）、IMU 的 I2C 总线、串口链路，以及两个微动开关加编码器共五路输入
    - IMU 不引入任何库，直接用 Wire 读写寄存器：Adafruit_MPU6050 的 begin() 里是 if (chip_id.read() != MPU6050_DEVICE_ID) return false; 这样的硬比较，而本板实测 WHO_AM_I = 0x70（MPU6500），那个库在这块板子上永远初始化失败、重试救不回来
    - 按 WHO_AM_I 认型号，0x68 与 0x70 都接受；温度按型号选公式（6500 用 raw / 333.87 + 21.0），raw 一并打印，日后换芯片时一眼能看出该用哪条。两条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
2026-10-17 feat(calib): 完成点阵与 IMU 标定，结论落进固件和 BoardProfile.h
    - 本分支收拢标定阶段。四类量——点阵的行列走向与朝向、编码器每格的正交跳变数、加速度计零点与增益、陀螺零偏——现在都是实测值而不是「应该是」。九个常数与轴映射进了固件，结论与判据都在新建的《标定.md》里，原始采样日志留在 %TEMP% 不进仓库
    - 点阵：逻辑坐标改成数学系 (x, y)，原点左下、y 向上，setPoint 不再需要任何减法。模块是 FC16_HW，用「点出四角 + h 3 / v 3 两条线」实机确认，MX_ROTATION = 0 同样是实测的。自检草图加了一路串口命令：点名点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
2026-10-17 feat(sim): 完成格子锚定物理原型与设计验证
    - 加入 v1 硬球基线与 v2 格子锚定内核，统一 spawn 摆位与 checker 独立不变量检查
    - 补齐 eval 评测（不变量、动能、运算数、板面摩擦阈值）、aniso 各向异性扫描与 rot 转动 / 镜像检验
    - 任意转轴的离心 / 科氏 / 欧拉与板面静摩擦；mul 改成对称半值取整，消掉三处方向性偏置
    - 设计文档记录单次扫描的柱深残余、约 k² 收敛次数、门序相关性与摩擦爬行
2026-10-17 feat(firmware): 完成格子锚定内核的固件移植与 IMU 接入
    - PhysicsWorld.h / fixed_q16.h：world2.py 的 C++ 逐位移植，含三轴离心、科氏、欧拉与板面静摩擦
    - Gewu.ino：编码器增删粒子（容量 64），MPU6500 200 Hz 实时重力与三轴角速度
    - IMU 链路：±4 g、加速度计 DLPF 218 Hz；加速度与陀螺分两次 6 字节读，跳过温度
    - 角速度经 0.2 dps 死区、w 增益与 25 ms 低通差分驱动转动；转动原点取实测安装位置 (4.5, 0.5)
    - 手感初值：重力标度 0.0040、板面摩擦 0.08、块间摩擦 0.40；f / u / g / w 可现场调
    - 新增 tools/serial_console.py：常驻提示符，支持 :port（:com）、:re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
    [BoardProfile.h, Gewu.ino, PhysicsWorld.h, fixed_q16.h, serial_console.py]
2026-10-17 feat(firmware): 加入 SW3 慢速生成任务
    - 三路微动接入 15 ms 消抖扫描，照搬 Hardware_Test 的 ButtonState，只在按下沿动作
    - SW3 清空全部粒子并立刻补一颗，之后每 60 秒加一颗；任务中再按 SW3 等于重开
    - SW2、ENCSW 按下与编码器任意一格都会终止任务，已有粒子保留；串口命令不打断
    - 满 64 颗自动结束；新增 t [1-3600] 临时改周期，s 增加 drip 状态行
    - README 与物块模式_物理设计.md 同步命令清单与固件尺寸（337056 B flash / 17584 B RAM）
    - plain / friction / spin 三组 v trace 与 sim/port_trace.py 仍逐行一致
2026-10-17 chore(pcb): 更新外壳工程，扩大 SW1 孔并加入底壳
    - TopShell 的 SW1 按键孔加大，Gerber 重导出为 2026-10-17
    - 新增 BottomShell Gerber 导出（2026-10-17）
    - EasyEDA 工程更新为 ProPrj_Gewu_2026-10-17.epro2，移除 2026-10-12 的旧导出
2026-10-17 fix(tools): 串口默认值改为自动识别 CH343
    - 新增 tools/serial_port.py：按 VID/PID 认沁恒 CH34x，唯一命中直接用
    - 没有命中时只剩一个串口就兜底，多个候选列出设备与描述并提示用 --port 指定
    - serial_send / serial_console / imu_stat / accel_calib 不再写死 COM11，换机器不用改脚本
    - README 同步说明；上传示例改为先用 board list 确认端口
    [accel_calib.py, imu_stat.py, serial_console.py, serial_port.py, serial_send.py]
2026-10-18 feat(physics): 加入水模式，优化物理响应效果
    - 水模式：零摩擦、零恢复、连续静水压强，外加很小的内聚力（`a` 4）与键轴黏性（`j` 4），低速流淌时不再散成单个格子
    - 物理子步改为每帧 4 个，仿真侧默认同步到 4 子步 / 240 Hz，逐位 trace 显式钉住原来的 2 子步 / 120 Hz
    - 粒子模式按颗粒材料反推手感：重力标度 0.0118、板面摩擦 0.05、块间摩擦 0.45、恢复 0.50、阻尼 0.9998、转速 100%
    - SW2 切换水 / 粒子模式并保留现有粒子，只恢复该模式的默认参数；SW3 慢速生成不再被切模式打断
    - 仿真拆分公共层，粒子脚本移入 `sim/particle/`，新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
2026-10-21 feat(calib): 完成第二块板的六面标定与分板档案
    - 第二块板 2026-10-21 完成六面标定：ACCEL_GAIN {16360.1, 16412.0, 16577.3}、ACCEL_OFFSET {-32.1, -135.9, 56.5}
    - 陀螺零偏同窗口测出 {-883, +382, +305}，X 轴比第一块板大 5.4 dps，证明常数不能跨板沿用
    - 这次在 ±4 g 下直接标定，与固件读取时的 k = 0.5 严格抵消，去掉了第一块板那条「零点随量程缩放」的假设
    - 第一块板的档案 git mv 到 BoardProfile.h.20261017，不参与编译；要给旧板重烧需把两份换回来
    - 《标定.md》分板记录两块板的数据、两板对比、台面振动与摆位错边两条教训，以及烧回后的三项复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
2026-11-01 perf(physics): 内聚改为成对施加，水模式运算量降 15%~29%
    - 每对相邻邻居只遍历一次，等大反向同时写进两个块；阻尼的推力向量只算一次，省掉反向那份重复乘法与一半的邻格查表
    - 覆盖完整：半平面偏移 (1,0) (0,1) (1,1) (-1,1) 连同各自反向量恰好覆盖全部八条边，不重复也不遗漏
    - 逐位等价的三条依据：定点累加可交换可结合；fx::mul() 取整严格奇，mul(-a,b) == -mul(a,b)；阻尼项在反方向上恰好同值（u' = -u 使 vrel' = vrel，故 d' = d）
    - 固件侧 cohesionAccel(i) 换成整场 cohesionPairs(ax, ay)：substep() 先清零 extX/extY，内聚整场填，再逐块叠静水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
2026-11-01 feat(firmware): 加入钢珠模式与 e / q 串口命令
    - 钢珠模式与粒子共用同一内核和重力标度 0.0118，只改材料系数：板面 μ_p 0.003、块间 μ 0.15、恢复 e 0.78、阻尼 0.9999
    - 密度不进入自由落体，钢珠的「重」由低摩擦与高恢复表现，不用更大的 g；8 格落体末速 0.4345，仍在 vmax 0.6 以内
    - SW2 从两态切换改为 水 → 粒子 → 钢珠 → 水 循环，m steel 可直接切换，切换保留现有粒子
    - 新增 q [0-999]（板面摩擦，千分之一；钢珠的 0.003 低于 f 的 0.01 步长）与 e [0-100]（恢复系数，百分数）
    - s 状态行的 mup 显示精度提到四位，并补上 e；PhysicsWorld.h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
2026-11-01 feat(firmware): 三路按键改为松开沿触发
    - SW2 / SW3 / ENCSW 的动作从按下沿移到松开沿，为组合键留出「按住 A 再点 B」的时序窗口
    - 两个沿都打印事件：按下报 press，松开报 release 后执行原动作
    - 开机横幅与 ? 帮助文本同步松开沿描述
    - 消抖、编码器正交解码与 handleDetent 路径不变；Hardware_Test 自检草图不同步
    - README 与物块模式设计文档同步按键时机措辞
    - 编译通过并已烧录 COM4，占 345924 B flash、18384 B RAM
2026-11-11 feat(hw): 加入电源板设计、PCB 与 Gerber
    - 新增 电源设计.md：独立电源小板的规格、选型与风险记录（TP5400 单芯片方案，18650 升压到 5V，DW01A + 8205A 保护）
    - 电源板 PCB 定稿：90 × 60 mm、两层；工程包更新到 2026-11-11，主板与电源板同在一个工程里
    - 删除 2026-10-17 工程包：11-11 已包含它的上盖、底壳与主板内容，另多一块完整电源板，留着只会重复
    - 加入电源板 Gerber（Power_PCB2），与已入库的 PCB1、TopShell、BottomShell 并列
    - README 硬件表补电源小板一行：18650 → 5V 升压与保护，与主板叠装
    - README 注明电源板有三处飞线，打样后需手工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
2026-11-12 feat(physics): 加入颗粒屈服门与自由竖列失稳
    - 新增 Params.yield_mu / yieldMu；0 保持水模式的纯压强路径，逐位不变
    - 两侧无料块的自由竖列没有侧向围压，压强项恒屈服，2/3 颗竖列必塌
    - 有侧向支撑的料堆按 hypot(tx, ty) > μ·own 屈服，停在 arctan(1/n) 台阶
    - 同一增益下钢珠（μ=0.15）比豆子（μ=0.45）摊得更平：4×4 末态 8-7-1 对 7-6-3，右翼约 12.1° 对 21.4°
    - 新增 sim/steel/granular.py：竖列、料堆、镜像、定点开销四组验证
    - 固件移植：Params.yieldMu、pressureAccel 的屈服门、三模式预设、y [0-999] 命令与 yield= 回读
    - 设计文档新增 §4.6，记录问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
2026-11-12 feat(physics): 补齐压强与屈服门的逐位 trace，修正水路径侧向偏移顺序
    - 新增 `v hydro` / `v hydrod` / `v grain` / `v graind` 四条确定性 trace，共用 19 块初态（贴墙 4×3 + 中下 2 格 + 右侧竖列 + 右上 1 格），零摩擦、零恢复、零内聚、`hydrostatic = 1.0`，只差重力向量与屈服 μ
    - 竖直组 (0, 79) 覆盖对称简并、贴墙、自由面与 `own = 0` 早退；斜向组 (40, 66) 覆盖射线同时跨 x、y 边界的 min-f 插值与对角侧向偏移
    - 屈服 μ 取 0.45（豆子预设）：斜向场景下 0.15 只挡住 116 次、几乎不触发，0.45 挡住 3232 次，阈值比较的两侧都能走到；竖直场景挡住 2927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
    [Gewu.ino, PhysicsWorld.h]
2026-11-12 perf(physics): 压强项三处逐位等价优化，满盘压强开销降到 1/4.5
    - 侧向偏移对从逐块搜索提到 `updatePressure()` 每子步一次：水路径的对称简并分支原来每块重搜一遍 8 偏移 × 2 次 `fromFloat` + 2 次 `mul`，而这个偏移对只依赖重力方向、全场相同；水模式逐块 1016 → 440 ops，整子步 4375 → 3824
    - `buildPressureDepth()` 与 `pressureAccel()` 里 `fromFloat()` 的整数参数改直接乘 `ONE`：格号、半格步数、边界格号都是整数，`fromFloat(v)` 在整数上就是 `v * ONE`；每子步省掉 144~272 次软浮点（C3 上每次约 100~200 周期，定点计数器看不到这一项）
    - 屈服门改平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
2026-11-12 feat(firmware): 红豆预设移出 SW2 按键循环，中文名统一为「红豆」
    - SW2 只在 水 ↔ 钢珠 之间切；红豆预设（μ_p 0.05、μ 0.45、e 0.50）只留 `m particles` 串口入口，从红豆按 SW2 回到水，再按才进钢珠
    - 新增 `nextButtonMode()`，替换 `(simMode + 1) % MODE_COUNT`；`SimMode` 枚举与 `MODE_COUNT` 不变，`m` 的三值校验、`mode=` 回显、`s` 状态行都不动
    - 中文名统一为「红豆」：固件文件头、开机横幅、`?` 清单、`q` / `g` / `w` 的默认值说明与注释，以及 README、设计文档 §4.4~§4.6、`sim/steel` 与 `sim/water` 的注释一起改
    - 协议与标识符按约定不动：`m particles`、`M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
2026-11-12 feat(firmware): SW3 改为按住冻结，SW2 长按 2 秒闪外圈进计时
    - SW3 在消抖确认的按下沿冻结物理推进、松开沿恢复；冻结期间编码器增删照常，新增粒子停在原地，且不打断计时
    - SW2 长按满 2 秒时点阵最外圈 28 颗闪 120 ms，随后清空、立刻补一颗并开始每 60 秒加一颗的计时任务
    - SW2 短按照旧在 水 ↔ 钢珠 之间循环；长按触发后的松开不再切换预设
    - 编码器转动增删与 ENCSW 清空仍打断计时；闪烁期间被打断时只取消计时启动，闪烁照常闪完
    - 冻结只停物理，不停 IMU 与计时；k / v 台面命令不受冻结影响
    - 同步更新帮助文本、开机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
